tsshendo/2-Phase-interleaved-buck-converter/kicad/tools/README.md

# kicad/tools

Scripts used to build and check the Stage 2 schematic. Run them with KiCad's bundled Python
(`C:\Program Files\KiCad\10.0\bin\python.exe` on Windows).

| Script | What it does |
|---|---|
| `gen_symbols.py` | Writes the project symbol library `ECE533_Guide/ECE533.kicad_sym`: custom IC symbols drawn from the manufacturer datasheets (LTC3861, Si8274, AMC3301, INA301, LM5012, TPS2553, TLV3012, VOM1271, 74LVC1G74, SI86S620, NME1S0505SC, EPC2304, ERUC23) and the named power symbols (PGND, GND_ISO, +5V_PWR, +5V_ISO, VBUS, +24V). |
| `gen_schematic.py` | Generated the initial hierarchical sheets (root, input protection, power stage, 2 × power phase, aux supply/fan, isolation, controller, fault logic/rack I/O). |
| `check_netlist.py` | Connectivity checks on an exported netlist (74 checks: every signal path through the hierarchy, Kelvin returns, the two ground domains kept apart). |
| `gen_footprints.py` | Writes `ECE533_Mods.pretty` (EPC2304, TDK ERUC23, Kelvin 2512 shunt, Littelfuse 456 fuse, drawn from the datasheets), the fuse placeholder STEP, and the git-ignored `lib/vendor/ECE533_Vendor.pretty` (Würth REDCUBE, Murata NME1S). See `lib/vendor/README.md`. |
| `build_pcb.py` | Stage 3 first pass: builds `ECE533_Guide.kicad_pcb` from the netlist (footprints, nets, schematic links, outline, stack-up, net classes, heatsink/barrier drawings) and places all parts (fixed floor plan + nearest-free-spot placement). Re-running overwrites the board, so after Stage 3 edit in KiCad. |
| `check_footprints.py` | Checks every symbol pin against the pads of its footprint (and flags unused pads). |
| `make_bom.py` | Builds `bom/PCB_BOM.xlsx` and `bom/PCB_BOM.csv` from an exported netlist. |
| `route_power.py`, `route_signals.py` | Stage 4 power copper and Freerouting round trip for the main board; their `Router` and DSN helpers are reused by `pm_route.py`. |
| `pm_assign.py`, `pm_flags.py` | PowerModule: footprints, catalog values and MPN/LCSC fields on the base schematic; PWR_FLAGs on the driver supply nets. |
| `pm_build.py` | PowerModule: builds `PowerModule.kicad_pcb` from the netlist and places all 54 parts in the report's layout. |
| `pm_route.py` | PowerModule: report polygon pours (`power`), Freerouting for the signals (`signals`), ground fills and stitching (`finish`). See `docs/design/power_module.md` §8. |
| `pm_bom.py` | PowerModule: `bom/PowerModule_BOM.csv` from the netlist. |
| `kisch.py`, `kilib.py`, `sexp.py`, `parts.py` | Helpers: schematic writer, symbol builder, S-expression reader, part catalogue (footprints, MPNs). |

**After Stage 2, edit the schematic in KiCad.** Re-running `gen_schematic.py` overwrites the
sheets, so it is a record of how they were built, not the master copy. `check_netlist.py` stays
useful after manual edits:

```
kicad-cli sch export netlist -o build.net kicad/ECE533_Guide/ECE533_Guide.kicad_sch
python kicad/tools/check_netlist.py build.net
```
