tsshendo/2-Phase-interleaved-buck-converter/docs/datasheets/README.md

# Datasheets and references

Vendor datasheets aren't committed (copyright). Download them locally into this folder;
`*.pdf` here is fine to keep locally, but please don't commit it.

| Part | Role | Link |
|---|---|---|
| EPC2304 | 200 V eGaN FET (Q3–Q6) | https://www.digikey.com/en/products/result?keywords=EPC2304 |
| TDK ERUC23-3R2K | Coupled inductor (L1) | https://www.digikey.com/en/products/result?keywords=ERUC23-3R2K |
| Infineon 1EDN7550UXTSA1 | Gate driver (U1–U4) | https://www.digikey.com/en/products/result?keywords=1EDN7550UXTSA1 |
| MCC SS110HL-TP | Bootstrap Schottky (D1–D4) | https://www.digikey.com/en/products/result?keywords=SS110HL-TP |
| Skyworks SI86S620BC-IS | Digital isolator (likely removed) | https://www.digikey.com/en/products/result?keywords=SI86S620BC-IS |
| Murata NME1S0505SC | Isolated 5 V module (likely removed) | https://www.digikey.com/en/products/result?keywords=NME1S0505SC |
| Molex 105313-1206 | Signal header (J4) | https://www.digikey.com/en/products/result?keywords=1053131206 |
| Chemi-Con EGXF161ELL111MK25S | Bulk capacitor (C5/C6) | https://www.digikey.com/en/products/result?keywords=EGXF161ELL111MK25S |
| Alpha Novatech Z60-12.7B | Heatsink | https://www.alphanovatech.com/en/c_z60e.html |
| Sanyo Denki 9GA0405P6H001 | 5 V cooling fan | https://products.sanyodenki.com/en/sanace/dc/dc-fan/9GA0405P6H001/ |
| TI UCC27611 | Reference: alternative GaN driver | https://www.ti.com/product/UCC27611 |
| onsemi FAN3122 app note | Reference: gate-drive design | https://www.digikey.com/en/products/result?keywords=FAN3122 |
| TI TIDA-050089 | Reference design the topology follows | https://www.ti.com/tool/TIDA-050089 |
