tsshendo/2-Phase-interleaved-buck-converter/docs/design/power_module.md

# Power module board (`kicad/PowerModule`)

A separate KiCad project that holds **only the power stage** of the ECE 533 report design, driven
through a control connector. It is the report's module, laid out on the credit-card board. The main
board (`kicad/ECE533_Guide`, Stages 1–5) is a different project and is not affected.

| | |
|---|---|
| Schematic | Base files from the report (commit `57d8ca5`): `PowerModule.kicad_sch` (power stage) + `gate_drive.kicad_sch`. The circuit is unchanged (see §2) |
| Board | 85.60 × 53.98 mm ID-1 (R3.18), 4 × 2 oz, 1.6 mm, ENIG, JLCPCB 4-layer |
| Parts | 60, the same parts as the report (bulk caps split, 1 kΩ gate pull-downs added, §2): 4 × EPC2304, ERUC23-3R2K, 4 × 1EDN7550B, 2 × SI86S620BC, NME1S0505SC, REDCUBE terminals |
| Checks | ERC: 0 errors, 6 warnings (off-grid wire ends in the base drawing). DRC with schematic parity: **0 violations, 0 unconnected, 0 parity issues** |
| Scripts | `kicad/tools/pm_assign.py`, `pm_flags.py`, `pm_build.py`, `pm_route.py`, `pm_bom.py` (see §8) |

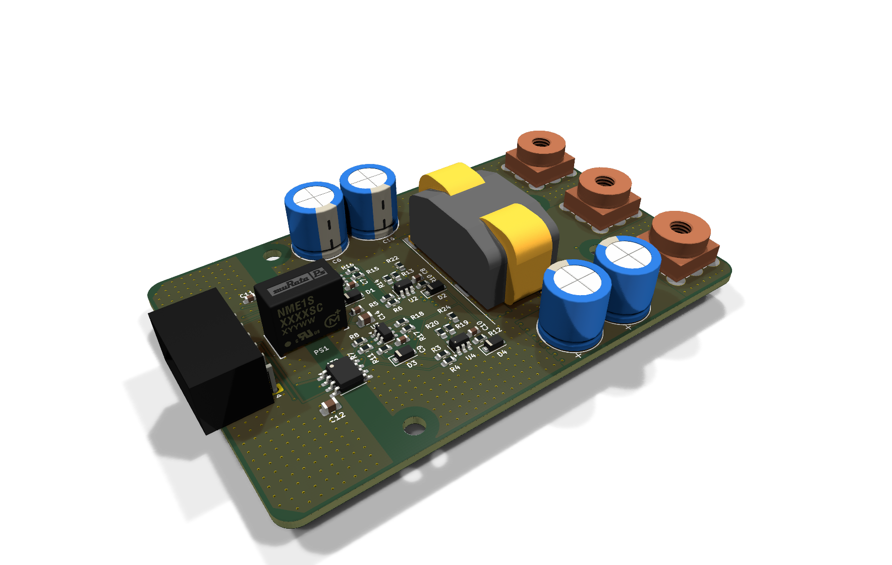
[picture p1: docs/design/img/pm_3d_iso.png]
top


## 1. What the module does
- 72 V in (J1 DC+, J3 DC−), 24 V / 46 A out (J2, return through J3), two phases 180° apart and one
  coupled inductor. No controller on board.
- **J4 (Molex Nano-Fit 105313-1206, right angle)**, centred on the left edge between the isolators,
  mating face 2.2 mm off the board edge (project footprint `ECE533_Mods:Molex_Nano-Fit_105313-1206_RA`
  with a right-angle model drawn from the footprint outline and the Molex drawing; KiCad's library has
  no Nano-Fit model). PS1 sits on J4's centreline. J4 brings in
  the four gate commands and their 5 V supply. The AT1 pair runs on L4 and the AT2 pair on L1 in
  fixed lanes (each pair swaps order at the isolator, so one signal per pair changes layer once):
  15–19 mm per line:

| J4 pin | Net | Function |
|---|---|---|
| 1 | +5V | 5 V for the isolator inputs and PS1 (the module draws < 0.1 W, PS1 is rated 1 W) |
| 2 | AT1 A1 | Phase 1 low side (Q4 on when high) |
| 3 | AT1 A2 | Phase 1 high side (Q3 on when high) |
| 4 | AT2 A1 | Phase 2 low side (Q5 on when high) |
| 5 | AT2 A2 | Phase 2 high side (Q6 on when high) |
| 6 | GND | Control ground (isolated from the power ground) |

  Each isolator output pair feeds the two drivers of a phase crosswise (B1 → U1 IN−/U2 IN+, B2 →
  U1 IN+/U2 IN−), so **both inputs high or both low turns both FETs off**. Dead time is set by the
  external controller.
- Isolation: AT1/AT2 (SI86S620BC) carry the commands, PS1 (NME1S0505SC) makes the isolated
  +5V_iso / GNDPWR supply for the driver side. The barrier band is x = 16.3–19.7 mm on every layer,
  with a 2.5 mm DRC rule between the J4-side nets and the rest.

## 2. Schematic changes (minimal)
The base schematic is used as given. The only additions are:
1. **Footprints, catalog values and part numbers** (`pm_assign.py`). Every passive is 0603 or
   larger, and the values follow the BOM:
   - C1–C4: 2.2 µF (base: 2.5 µF);
   - bulk: each bulk position is **two parallel EGXF 62 µF / 160 V** (EGXF161ELL620MJ25S, 10 × 25 mm):
     C5 + C15 on the output, C6 + C16 on the input (user request: half values for lower ESR; the GXF
     160 V series has no 55 µF part, so 2 × 62 µF = 124 µF per position, ≥ the former 110 µF).
     C15/C16 are joined with `VOUT` / `VIN` labels (`pm_split_bulk.py`). Base schematic: C6 440 µF;
   - R13/R14/R19/R20: 5.6 Ω (base: 6 Ω).
2. **`SHIELD` label** joining the two centre taps (C1/C2 and C3/C4). This is the interstitial-shield
   return terminal described in the report (p. 18).
3. **PWR_FLAGs** on the driver supply nets, which come in through J4, PS1 and the bootstrap parts.
4. **Gate pull-downs R21–R24** (1 kΩ, 0603, gate to Kelvin source: P1H–KS1, P1L–GNDPWR,
   P2H–KS2, P2L–GNDPWR), as in the report's LTspice model (`pm_pulldowns.py`).
5. `connectors.kicad_sch` was dropped: it was in the base folder but not in the hierarchy.

EPC2304 uses the base SamacSys 15-pin symbol. The new footprint `EPC2304_QFN-7_3x5mm_15pin` has the
EPC copper, mask and stencil drawing, with pins 8–15 stacked on the matching physical pad: G → 1/12,
SK → 2/15, D → 3/8, 5/9, 7/10/11, S → 4/13, 6/14.

## 3. Stack-up and layer use (two planes, as in the report)
| Layer | Report equivalent | Use |
|---|---|---|
| L1 (top, 70 µm) | 1st Cu plane | Inductor, drivers, isolators, PS1, bulk caps, terminals. VOUT plane (inductor → J2, C5), VBUS strip (C6, J1), switch-node pads, gate traces, PGND fill on the power side, GND fill on the J4 side |
| L2 (70 µm) | Interstitial shield | Continuous `SHIELD` plane on the power side, with antipads at every feedthrough. No traces |
| L3 (70 µm) | Interstitial shield | Second copy of the shield, 0.1 mm above the FET plane (closest to the dv/dt source). No traces |
| L4 (bottom, 70 µm) | 2nd Cu plane (MOSFET side) | EPC2304s and input ceramics; patterned VBUS / SW / PGND combs, centre-tap island, Kelvin islands, PGND return to J3 |

The report's alumina stack (70 µm / shield / 70 µm) becomes FR-4 3313 prepreg (0.1 mm) on each side
of a 1.1 mm core. L2 and L3 are set as plane layers, so the router never puts traces on them.
**Deviation:** the user's answer allowed L3 to be "empty (or ground)". I used it as a second shield
layer, because it sits right next to the switch nodes. If you want L3 empty, delete its zone.

## 4. Layout, following the report (pp. 20–25)
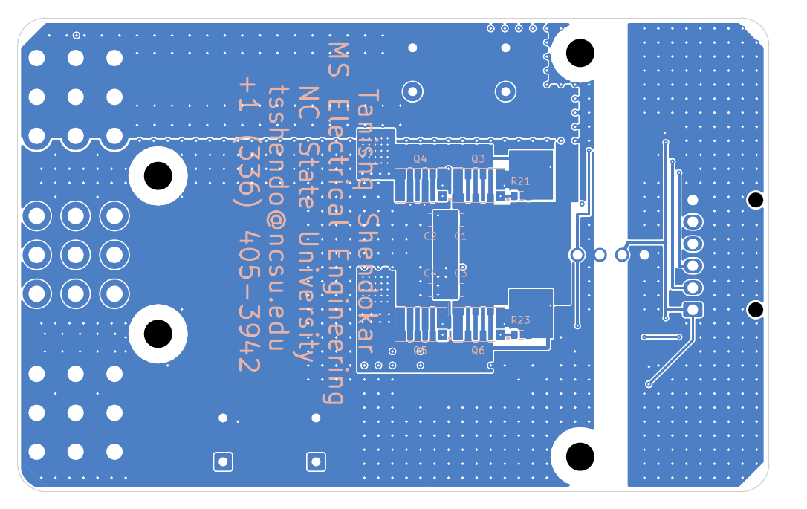
[picture p2: docs/design/img/pm_L4.png]
L4

*L4 from below (mirrored): the two half-bridges, combs and centre-tap island.*

- **Order, left to right** (report figures "Gate Isolator…" and "Gate and power terminals"): J4 on
  the side, AT1/AT2 with PS1 between them, a column of four gate drivers, the 2 × 2 FET block, the
  coupled inductor, then the bulk capacitors and the terminals. The report brings its power wires
  out of the top. Here they land on REDCUBE M4 terminals on the right edge: DC+ top, VOUT middle,
  DC− bottom.
- **FET block** (bottom, at x 33.0 / 39.6 and y 19.1 / 34.9). Each phase is one row: HS left, LS
  right, strips vertical, gate pads toward the drivers. The rows sit exactly under the inductor's
  switch-node pads (pad pitch 15.8 mm), so the phases are copies of each other.
- **Patterned 2nd plane (L4), per phase:**
  - Switch-node comb along the outer ends of the strips (HS sources + LS drains), straight under the
    inductor pad, with 25 filled vias in the pad and 8 more in the band (0.06 mΩ, < 3 % of RDS(on)).
  - VBUS comb (HS drains) and PGND comb (LS sources) along the inner ends.
  - C1 + C2 (C3 + C4) in series bridge VBUS → SHIELD → PGND right at the FETs, so the commutation
    loop is cap → HS → switch node → LS → cap. That loop is about 6.6 × 5 mm, flat, 0.1 mm above the
    L3 shield.
  - The centre taps of both phases form one `SHIELD` island between the rows, stitched to L2/L3.
    That is the shield's single return terminal (report p. 18).
- **Gate drive:**
  - The HS drivers are on the top, in the report's column left of the FETs, level with their FET
    row. The **LS drivers sit on the top between the two phases**, right at the LS gate pads, with
    their outputs facing the gate vias and the gate resistors running straight to them.
  - Gate pads and the LS Kelvin pads go up through filled via-in-pad.
  - Each HS driver sits over a **Kelvin island** on L4. The island connects to the HS SK pad and joins
    the switch node only once, at a tie next to the FET. It is the driver's reference and the return
    under its gate trace.
  - Driver output → gate resistor → gate pad, total: **LS 4.8 mm, HS 5.9–6.8 mm** (the first layout
    had LS 11–14 mm).
- **Input path:** J1 → VBUS strip (L1 + L4 along the top edge, C6 on a PGND tongue) → VBUS column
  down the left of the FET block → the HS combs. **Output path:** inductor pads → L1 VOUT plane → J2,
  and the VOUT plane down to the output capacitors on the bottom edge. **Return:** L4 PGND under the inductor → J3.
- **Symmetry about the board centreline:** the FET rows (y 19.1 / 34.9), the inductor body (centred;
  its SW pads, off-centre in the TDK footprint, sit 3.95 mm above each FET row and the L4 switch-node
  copper extends under them), J4, PS1, AT1/AT2, C11/C12, the screws and the terminals are mirrored.
  The **per-phase gate-drive cells are identical copies one phase pitch (15.8 mm) apart**, like the FET
  rows: the EPC2304 gate pad is at the same corner in both rows (a bottom-side part cannot be
  mirrored), so mirrored cells would give the two phases different gate loops. As copies, both phases
  have the same driver→gate paths (HS 8.3 mm, LS 5.9 mm including the pull-down stubs).
- **Bulk capacitors grouped by role:** input C6 + C16 together on the top edge, on the **input side**
  of the inductor, over the VBUS feed to the HS drains: they supply the pulsed input current next to
  the ceramics and keep the input ripple off the output side; their '−' pins reach the L4 PGND comb
  through an L1 tongue and vias next to LS1. Output C5 + C15 together on the bottom edge, on the
  **output side**, under the inductor's VOUT pads and next to J2, on the VOUT plane.

| L1 (1st Cu plane) | L2 (shield) |
|---|---|
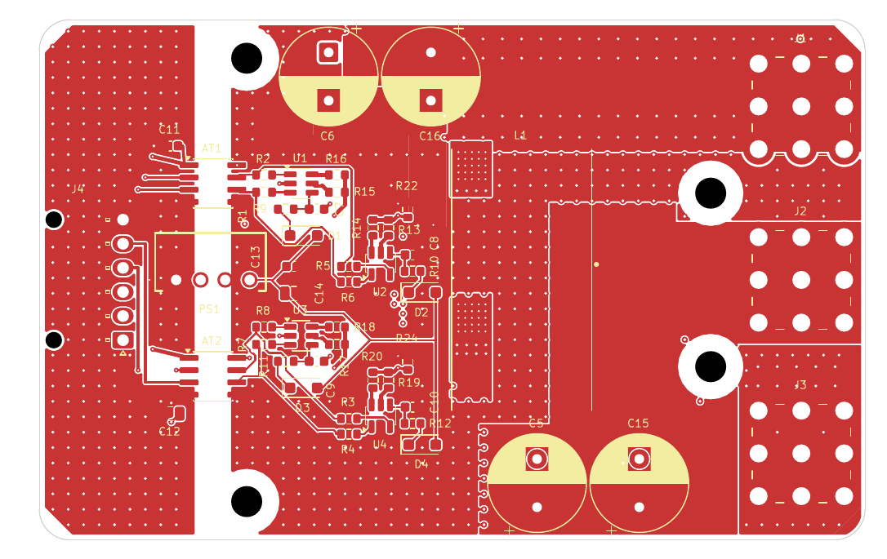
[picture p3: docs/design/img/pm_L1.png]
L1
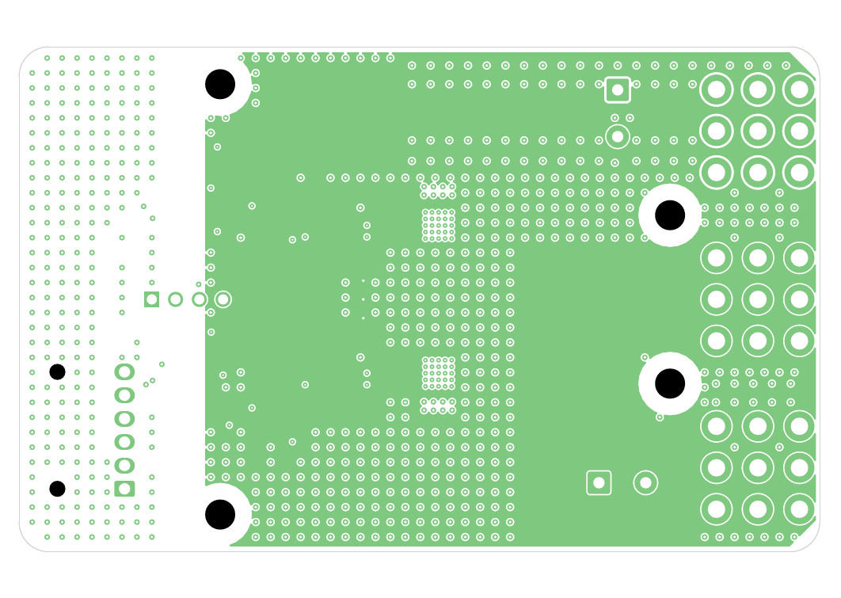
[picture p4: docs/design/img/pm_L2.png]
L2
|  |  |

- **Silkscreen:** every reference designator is on the silkscreen (0.8 mm, on the part's side).
  The bottom carries the owner block (name, degree, university, e-mail, phone) at 2.3 mm, between
  the FET block and the terminals. Note that the heatsink covers it once mounted.

## 5. Mechanics and thermal
- Z60-12.7B on the bottom at x 19–79 mm: flush with neither edge, 3 mm overhang top and bottom.
  There is a 3.0 mm pedestal over the FET block and an insulating TIM (HS and LS share the
  heatsink), drawn on Dwgs.User / B.Fab.
- **4 × M3 holes** (NPTH, 3.4 mm copper keep-out): (21.5, 4.0), (21.5, 50.0), (69.6, 18.0),
  (69.6, 36.0) mm. Screw heads stay clear of the top parts.
- Only the FETs and C1–C4 are on the bottom. THT leads under the heatsink (C5, C6, PS1 pins 3–4,
  J1–J3) must be trimmed to ≤ 2.5 mm (pedestal 3.0 mm).
- FET losses, junction temperature and fan: unchanged from `thermal.md`.

## 6. Current and copper
| Path | Copper | Estimate |
|---|---|---|
| Switch node → inductor, per phase | L4 band + 33 vias + L1 pad | 0.06 mΩ (vias), 23 A |
| VOUT, inductor → J2 | L1 plane ≥ 12.6 mm wide, about 25 mm long | ≈ 0.45 mΩ → 0.9 W at 46 A (one layer) |
| PGND return → J3 | L4 plane ≥ 10 mm wide + L1 fill | ≈ 0.4 mΩ |
| VBUS column (narrowest part) | L4, 2.6 mm × 7.3 mm beside the HS1 Kelvin island | 0.69 mΩ → 0.22 W at 17.9 A |
These are DC estimates (ρ = 1.72 × 10⁻⁸ Ω·m, 70 µm). Stage 1 asked for ≥ 20 mm of VOUT copper on
two layers. This module has one VOUT layer (the report's two-plane scheme puts PGND under it), so it
runs warmer than the main board. See §7.

## 6a. Parasitics vs the report (hand estimates, ±50 %)
Report values: Q3D tables and the LTspice models in `sim/ltspice/`. Layout values: copper measured on
this board; strip-over-shield L ≈ μ0·h·ℓ/w (h = 0.17 mm to the L2/L3 shield), microstrip 0.33 nH/mm,
via pair 0.4·h·ln(s/r) nH, ρℓ/A, FR-4 3313 0.0994 mm (0.365 pF/mm²; alumina 70 µm was 1.265 pF/mm²).

| Quantity | Report | This layout | Note |
|---|---|---|---|
| Commutation loop | 10.8 nH (Q3D) | ≈ 2.6 nH (2.1–3.4): planar 1.4 + 2 × 0805 in series 0.9 + FETs 0.3 | Lateral loop 6.6 × 6 mm over the shield |
| LS V_DS overshoot | ≈ 88 V (160 V peak) | ≈ 17–28 V (scaled) → ≈ 95–105 V peak | Target < 100 V: borderline-OK, confirm by extraction |
| HS gate loop | 4.93 nH, 12.6 mΩ | ≈ 4 nH, ≈ 9 mΩ (copper) | Kelvin island return under the trace |
| LS gate loop | 9.79 nH, 22.7 mΩ | ≈ 3 nH, ≈ 7 mΩ | LS drivers moved next to the LS FETs |
| Freewheel interconnect | target 0.15 mΩ (3 % RDS(on)); SPICE 0.25 + 0.1 mΩ | ≈ 0.4 mΩ (vias 0.06, SW band 0.25–0.3, return 0.1) | Over the 0.15 mΩ target, ≈ the SPICE value; an L1 copper layer over the SW band would roughly halve it (more SW area) |
| SW node → shield | 71.5 pF | ≈ 45 pF (phase 1), ≈ 64 pF (phase 2) | Includes the Kelvin island and the L1 pad; SW2 reaches 7 mm up to the centred inductor's pad |
| Shield return (tap → IL) | 1.02 nH, 0.94 mΩ | ≈ 0.3 nH, 0.24 mΩ (6 vias) | |
| IL → ground (heatsink) | 141 pF | not comparable | Here L4 copper screens the shield from the heatsink; the heatsink touches the FETs through the TIM |
| HF decoupling | 2.5 µF per leg (SPICE) | 1.1 µF per phase (2 × 2.2 µF in series, base schematic) | |
| Bulk | 440 µF in / 100 µF out (SPICE) | 124 µF in / 124 µF out | |
| Gate resistors | 2 Ω / 6 Ω, 1 kΩ pull-downs | 2 Ω / 5.6 Ω, 1 kΩ pull-downs R21–R24 (added) | HS pull-downs on the bottom in the Kelvin island, LS on the top over the gate via |

## 7. Open issues and deviations
1. **VOUT on one layer, VBUS neck 2.6 mm:** expect roughly 20–30 °C of copper rise at 46 A with no
   airflow. Options: thicker copper, or VOUT on L4 as well with PGND moved to L1.
2. **Commutation-loop inductance:** not extracted. A flat lateral loop of about 33 mm², 0.1 mm over
   the shield, should be a few nH, against the report's 10.8 nH. Confirm with Q3D/FastHenry before
   building. The series centre-tapped caps (base schematic) give only 1.1 µF per phase. Consider
   additional ceramics if overshoot is high.
3. **1EDN7550B high side:** Stage 1 judged its static common-mode range marginal at a 79 V high side.
   This is why the main board moved to the Si8274. Kept here because the module reproduces the report.
4. **PS1 SIP-4 pitch** across the barrier: same issue as the main board. PS1 sits on J4's centreline. The barrier keep-out at PS1 runs from pin-2 centre to pin-3 centre, so
   copper reaches each pin only from its own side; a DRC exception allows 0.9 mm between the pins and
   1.5 mm for copper entering PS1 (≈ 1.4 mm needed for functional isolation at ≤ 80 V, PD2).
5. Gate pull-downs R21–R24 (1 kΩ, gate to Kelvin source) were added to the base schematic (`pm_pulldowns.py`).
6. The LS Kelvin return runs on L1 and joins PGND through the fill.
7. Stock: the Digi-Key numbers come from the main BOM where the part is shared. The 1EDN7550BXTSA1
   Digi-Key PN and its stock still need to be confirmed, as do those of EGXF161ELL620MJ25S.
8. J4's 3D model is a dimensioned placeholder (boxes); swap in Molex's STEP if a full mechanical model is needed.

## 8. Regenerating
Run each command with KiCad's Python (`C:\Program Files\KiCad\10.0\bin\python.exe`) from `kicad/tools`.
```
python pm_assign.py ; python pm_flags.py ; python pm_split_bulk.py ; python pm_pulldowns.py   # once (applied)
kicad-cli sch export netlist -o pm.net ../PowerModule/PowerModule.kicad_sch
python pm_build.py pm.net                            # board, outline, stack-up, placement
python pm_route.py power                             # report pours, vias, Kelvin islands, hops
python pm_route.py signals <freerouting.exe> <dir>   # Freerouting v2.4.1 for the signals
python pm_route.py finish                            # ground fills, stitching
python pm_bom.py pm.net ../../bom/PowerModule_BOM.csv
```
Freerouting is not deterministic. After a rerun, check DRC again; the committed board is the
checked one.
