tsshendo/2-Phase-interleaved-buck-converter/docs/design/img/pm_3d_bottom.png

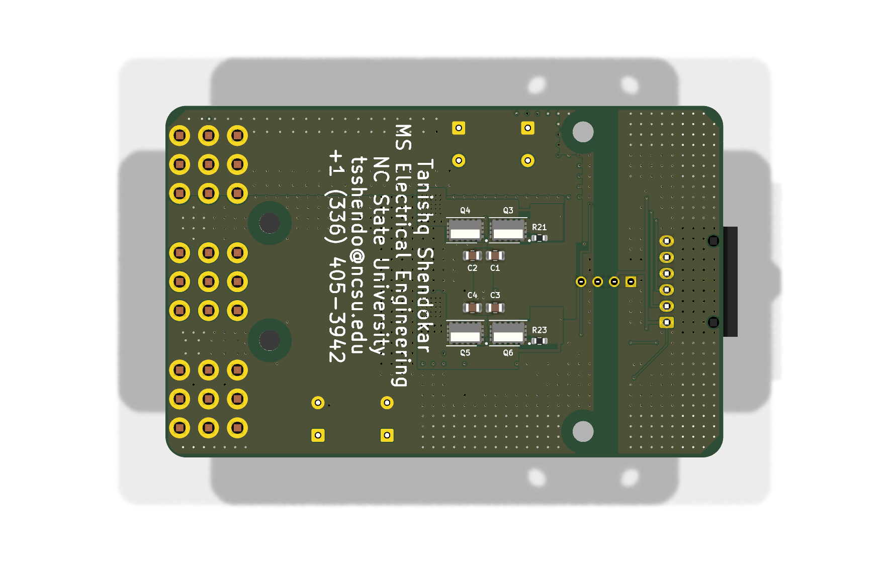
docs/design/img/pm_3d_bottom.png
