tsshendo/2-Phase-interleaved-buck-converter/docs/design/img/pm_3d_top.png

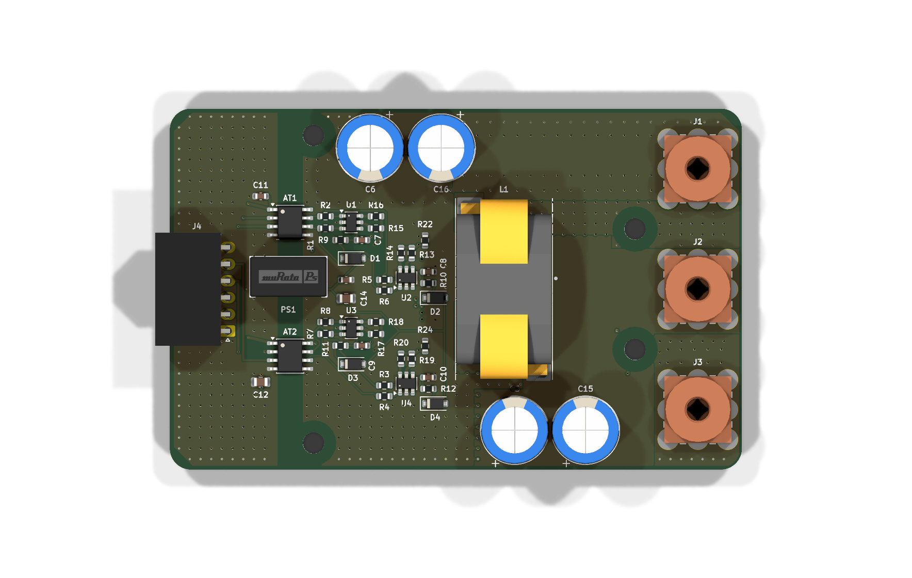
docs/design/img/pm_3d_top.png
