tsshendo/2-Phase-interleaved-buck-converter/docs/design/img/pm_all.png

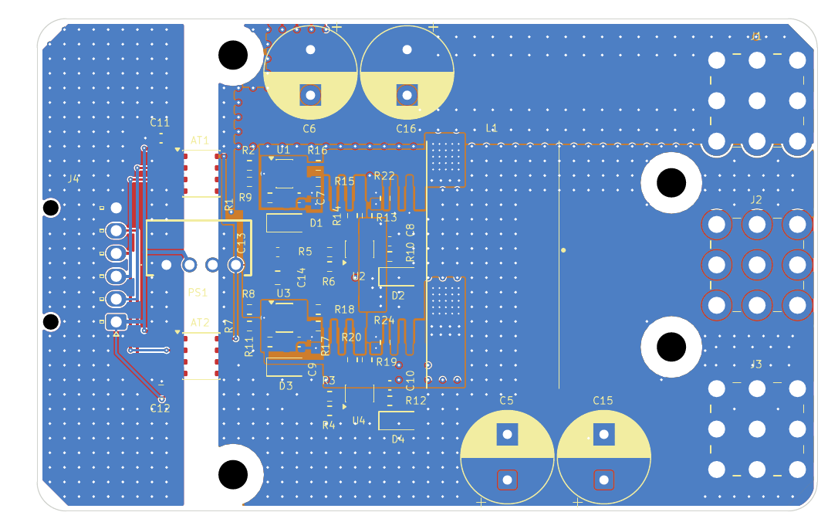
docs/design/img/pm_all.png
