tsshendo/2-Phase-interleaved-buck-converter/docs/design/img/stage3_footprints_3d.png

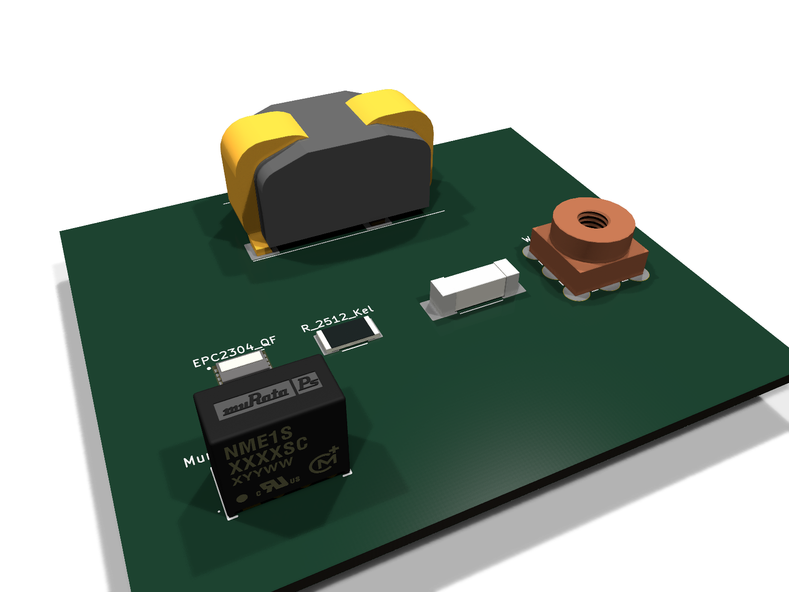
docs/design/img/stage3_footprints_3d.png
