tsshendo/2-Phase-interleaved-buck-converter/bom/PowerModule_BOM.csv

Item | Qty | Reference designators | Value | Manufacturer part number | Manufacturer | Digi-Key PN | LCSC PN | Footprint | Side | Notes
1 | 2 | AT1,AT2 | SI86S620BC-IS | SI86S620BC-IS | Skyworks | 863-SI86S620BC-IS-ND | C7363570 | SOIC-8_3.9x4.9mm_P1.27mm | Top | Report part (base schematic)
2 | 4 | C1,C2,C3,C4 | 2.2u/100V | GRM21BD72A225KE01L | Murata | 490-GRM21BD72A225KE01LCT-ND | C2981733 | C_0805_2012Metric | Bottom | Report part (base schematic)
3 | 4 | C5,C6,C15,C16 | 62u/160V | EGXF161ELL620MJ25S | Chemi-Con |  |  | CP_Radial_D10.0mm_P5.00mm | Top | Bulk split into 2 x half value per position (GXF 160 V, 10 x 25 mm); Digi-Key PN and stock to confirm
4 | 6 | C7,C8,C9,C10,C11,C13 | 100n/50V | GRM188R71H104KA93D | Murata |  | C77055 | C_0603_1608Metric | Top | Same part as the main board BOM
5 | 2 | C12,C14 | 10u/10V | GRM21BR71A106KE51L | Murata |  | C86038 | C_0805_2012Metric | Top | Same part as the main board BOM
6 | 4 | D1,D2,D3,D4 | SS110HL | SS110HL-TP | MCC | 353-SS110HL-TPCT-ND | C19996385 | D_SOD-123F | Top | Report part (base schematic)
7 | 1 | J1 | DC+ | 74650194R | Wurth Elektronik |  |  | Wurth_REDCUBE_74650194 | Top | Same part as the main board BOM
8 | 1 | J2 | Power_out | 74650194R | Wurth Elektronik |  |  | Wurth_REDCUBE_74650194 | Top | Same part as the main board BOM
9 | 1 | J3 | DC- | 74650194R | Wurth Elektronik |  |  | Wurth_REDCUBE_74650194 | Top | Same part as the main board BOM
10 | 1 | J4 | 105313-1206 | 105313-1206 | Molex | WM14975-ND | C17656275 | Molex_Nano-Fit_105313-1206_RA | Top | Report part (base schematic)
11 | 1 | L1 | ERUC23-3R2K | ERUC23-3R2K | TDK | 495-ERUC23-3R2KCT-ND |  | TDK_ERUC23 | Top | Report part (base schematic)
12 | 1 | PS1 | NME1S0505SC | NME1S0505SC | Murata | 811-NME1S0505SC-ND | C39128444 | Murata_NME1S_SIP-4 | Top | Report part (base schematic)
13 | 4 | Q3,Q4,Q5,Q6 | EPC2304 | EPC2304 | EPC | 917-EPC2304CT-ND | C6549215 | EPC2304_QFN-7_3x5mm_15pin | Bottom | Report part (base schematic)
14 | 8 | R1,R2,R3,R4,R5,R6,R7,R8 | 51k | RC0603FR-0751KL | YAGEO |  |  | R_0603_1608Metric | Top | Same part as the main board BOM
15 | 4 | R9,R10,R11,R12 | 4.7 | RC0603FR-074R7L | YAGEO |  |  | R_0603_1608Metric | Top | Same part as the main board BOM
16 | 4 | R13,R14,R19,R20 | 5.6 | RC0603FR-075R6L | YAGEO |  |  | R_0603_1608Metric | Top | Same part as the main board BOM
17 | 4 | R15,R16,R17,R18 | 2 | RC0603FR-072RL | YAGEO |  |  | R_0603_1608Metric | Top | Same part as the main board BOM
18 | 4 | R21,R22,R23,R24 | 1k | RC0603FR-071KL | YAGEO |  |  | R_0603_1608Metric | Top + Bottom | Gate pull-downs (report LTspice model): R21/R23 bottom, R22/R24 top
19 | 4 | U1,U2,U3,U4 | 1EDN7550B | 1EDN7550BXTSA1 | Infineon |  |  | SOT-23-6 | Top | Report driver (base schematic); Digi-Key PN and stock to confirm
20 | 1 | (mechanical) | Z60-12.7B heatsink | Z60-12.7B | Alpha Novatech |  |  | 4 x M3 holes H1-H4 | Bottom | Pedestal 3.0 mm over the FET block, insulating TIM
