tsshendo/2-Phase-interleaved-buck-converter/bom/PCB_BOM.csv

Item | Qty | Reference designators | Value | Manufacturer part number | Manufacturer | Digi-Key PN | Unit price (USD) | Ext. price (USD) | LCSC PN | Footprint | DNP | Notes
1 | 2 | AT1,AT2 | SI86S620BC-IS | SI86S620BC-IS | Skyworks | 863-SI86S620BC-IS-ND | 3.28 |  | C7363570 | SOIC-8_3.9x4.9mm_P1.27mm |  | Required part (CLAUDE.md section 4)
2 | 10 | C1,C2,C3,C4,C15,C16,C17,C18,C74,C75 | 2.2u/100V | GRM21BD72A225KE01L | Murata | 490-GRM21BD72A225KE01LCT-ND | 0.44 |  | C2981733 | C_0805_2012Metric |  | Required part (CLAUDE.md section 4)
3 | 2 | C5,C6 | 110u/160V | EGXF161ELL111MK25S | Chemi-Con | 565-EGXF161ELL111MK25S-ND | 2.07 |  | C1598290 | CP_Radial_D12.5mm_P5.00mm |  | Required part (CLAUDE.md section 4)
4 | 39 | C7,C8,C9,C10,C11,C13,C30,C31,C40,C41,C45,C47,C49,C50,C54,C56,C58,C59,C68,C73,C80,C87,C88,C89,C90,C91,C94,C96,C98,C100,C102,C103,C111,C112,C113,C114,C116,C117,C119 | 100n/50V | GRM188R71H104KA93D | Murata |  |  |  | C77055 | C_0603_1608Metric
5 | 4 | C12,C14,C84,C86 | 10u/10V | GRM21BR71A106KE51L | Murata |  |  |  | C86038 | C_0805_2012Metric
6 | 4 | C32,C33,C34,C35 | 10n/100V | GRM188R72A103KA01D | Murata |  |  |  | C162275 | C_0603_1608Metric
7 | 4 | C42,C51,C105,C106 | 1n/50V | GRM1885C1H102JA01D | Murata |  |  |  | C77026 | C_0603_1608Metric
8 | 16 | C43,C44,C46,C48,C52,C53,C55,C57,C83,C85,C93,C95,C97,C99,C101,C115 | 1u/25V | GRM188R71E105KA12D | Murata |  |  |  | C86020 | C_0603_1608Metric
9 | 6 | C60,C61,C62,C63,C64,C65 | 10u/50V | GRM32ER71H106KA12L | Murata |  |  |  | C77102 | C_1210_3225Metric
10 | 2 | C66,C67 | 100u/35V | EEH-ZA1V101P | Panasonic |  |  |  |  | CP_Elec_8x10.5
11 | 2 | C70,C71 | 1u/100V | CC0805KKX7R0BB105 | YAGEO |  |  |  | C5370002 | C_0805_2012Metric
12 | 1 | C72 | 470n/25V | GRM188R71E474KA12D | Murata |  |  |  | C77052 | C_0603_1608Metric
13 | 1 | C76 | 100n/100V | GRM188R72A104KA35D | Murata |  |  |  | C77058 | C_0603_1608Metric
14 | 2 | C77,C107 | 2.2n/50V | GRM188R71H222KA01D | Murata |  |  |  | C86023 | C_0603_1608Metric
15 | 2 | C78,C79 | 22u/10V | GRM31CR71A226KE15L | Murata |  |  |  | C91604 | C_1206_3216Metric
16 | 2 | C81,C108 | 4.7n/50V | GRM188R71H472KA01D | Murata |  |  |  | C77057 | C_0603_1608Metric
17 | 1 | C82 | 47n/50V | GRM188R71H473KA61D | Murata |  |  |  | C86027 | C_0603_1608Metric
18 | 3 | C92,C104,C109 | 100p/50V | GRM1885C1H101JA01D | Murata |  |  |  | C71664 | C_0603_1608Metric
19 | 1 | C118 | 10n/50V | GRM188R71H103KA01D | Murata |  |  |  | C77053 | C_0603_1608Metric
20 | 2 | D1,D2 | SS110HL | SS110HL-TP | MCC | 353-SS110HL-TPCT-ND | 0.36 |  | C19996385 | D_SOD-123F |  | Required part (CLAUDE.md section 4)
21 | 2 | D3,D4 | 5.1V | BZT52C5V1-TP | MCC |  |  |  | C78728 | D_SOD-123
22 | 1 | D5 | 30BQ100 | VS-30BQ100TRPBF | Vishay |  |  |  |  | D_SMC
23 | 1 | D6 | SMDJ85CA | SMDJ85CA | Littelfuse |  |  |  | C1978008 | D_SMC
24 | 2 | D7,D14 | TPD4E05U06 | TPD4E05U06DQAR | TI |  |  |  | C138714 | USON-10_2.5x1.0mm_P0.5mm
25 | 1 | D8 | GREEN PGOOD | LTST-C191KGKT | Lite-On |  |  |  | C125098 | LED_0603_1608Metric
26 | 1 | D9 | RED FAULT | LTST-C191KRKT | Lite-On |  |  |  | C125099 | LED_0603_1608Metric
27 | 2 | D15,D16 | BAT54W | BAT54W-7-F | Diodes Inc |  |  |  | C134417 | SOT-323_SC-70
28 | 1 | FB1 | 600R@100MHz | BLM18KG601SN1D | Murata |  |  |  | C85833 | L_0603_1608Metric
29 | 1 | J1 | DC+ 72V | 74650194R | Wurth Elektronik |  |  |  |  | Wurth_REDCUBE_74650194
30 | 1 | J2 | VOUT+ | 74650194R | Wurth Elektronik |  |  |  |  | Wurth_REDCUBE_74650194
31 | 1 | J3 | DC- return | 74650194R | Wurth Elektronik |  |  |  |  | Wurth_REDCUBE_74650194
32 | 1 | J4 | RACK I/O Nano-Fit | 105313-1206 | Molex | WM14975-ND | 2.54 |  | C17656275 | Molex_Nano-Fit_105313-xx06_1x06_P2.50mm_Horizontal |  | Required part (CLAUDE.md section 4)
33 | 1 | J5 | FAN Micro-Fit | 43650-0400 | Molex |  |  |  | C277684 | Molex_Micro-Fit_3.0_43650-0400_1x04_P3.00mm_Horizontal
34 | 1 | J6 | VOUT- | 74650194R | Wurth Elektronik |  |  |  |  | Wurth_REDCUBE_74650194
35 | 1 | L1 | ERUC23-3R2K | ERUC23-3R2K | TDK | 495-ERUC23-3R2KCT-ND | 8.96 |  |  | TDK_ERUC23 |  | Required part (CLAUDE.md section 4); Custom footprint, drawn in Stage 3
36 | 1 | L2 | 33uH | XAL7070-333MEB | Coilcraft |  |  |  |  | L_Coilcraft_XAL7070-XXX
37 | 1 | PS1 | NME1S0505SC | NME1S0505SC | Murata | 811-NME1S0505SC-ND | 1.86 |  | C39128444 | Murata_NME1S_SIP-4 |  | Required part (CLAUDE.md section 4)
38 | 2 | Q1,Q2 | IPT015N10N5 | IPT015N10N5 | Infineon |  |  |  | C108964 | Infineon_PG-HSOF-8-1
39 | 4 | Q3,Q4,Q5,Q6 | EPC2304 | EPC2304 | EPC | 917-EPC2304CT-ND | 9.05 |  | C6549215 | EPC2304_QFN-7_3x5mm |  | Required part (CLAUDE.md section 4); Custom footprint, drawn in Stage 3
40 | 2 | Q7,Q8 | 2N7002 | 2N7002LT1G | onsemi |  |  |  | C16338 | SOT-23
41 | 4 | R1,R2,R3,R4 | 51k | RC0603FR-0751KL | YAGEO |  |  |  |  | R_0603_1608Metric
42 | 2 | R9,R10 | 4.7 | RC0603FR-074R7L | YAGEO |  |  |  |  | R_0603_1608Metric
43 | 2 | R13,R14 | 5.6 | RC0603FR-075R6L | YAGEO |  |  |  |  | R_0603_1608Metric
44 | 2 | R15,R16 | 2 | RC0603FR-072RL | YAGEO |  |  |  |  | R_0603_1608Metric
45 | 2 | R21,R22 | 6.04k | RC0603FR-076K04L | YAGEO |  |  |  |  | R_0603_1608Metric
46 | 2 | R27,R28 | 22.6k | RC0603FR-0722K6L | YAGEO |  |  |  |  | R_0603_1608Metric
47 | 15 | R29,R30,R48,R52,R53,R55,R58,R61,R62,R81,R84,R91,R93,R94,R95 | 10k | RC0603FR-0710KL | YAGEO |  |  |  |  | R_0603_1608Metric
48 | 5 | R31,R32,R33,R34,R44 | 10 | RC0603FR-0710RL | YAGEO |  |  |  |  | R_0603_1608Metric
49 | 1 | R40 | 5.49k | RC0603FR-075K49L | YAGEO |  |  |  |  | R_0603_1608Metric
50 | 1 | R41 | 1M | RC0603FR-071ML | YAGEO |  |  |  |  | R_0603_1608Metric
51 | 1 | R43 | 330 | RC0603FR-07330RL | YAGEO |  |  |  |  | R_0603_1608Metric
52 | 1 | R45 | 95.3k | RC1206FR-0795K3L | YAGEO |  |  |  |  | R_1206_3216Metric
53 | 1 | R46 | 4.12k | RC0603FR-074K12L | YAGEO |  |  |  |  | R_0603_1608Metric
54 | 1 | R47 | 13.0k | RC0603FR-0713KL | YAGEO |  |  |  |  | R_0603_1608Metric
55 | 1 | R49 | 649k 0.1% | ERA-8AEB6493V | Panasonic |  |  |  |  | R_1206_3216Metric
56 | 4 | R50,R65,R69,R71 | 10.0k 0.1% | ERA-3AEB1002V | Panasonic |  |  |  |  | R_0603_1608Metric
57 | 1 | R51 | 1.69M | RC0603FR-071M69L | YAGEO |  |  |  |  | R_0603_1608Metric
58 | 1 | R54 | 200k | RC1206FR-07200KL | YAGEO |  |  |  |  | R_1206_3216Metric
59 | 1 | R56 | 32.4k | RC0603FR-0732K4L | YAGEO |  |  |  |  | R_0603_1608Metric
60 | 1 | R57 | 33.2k | RC0603FR-0733K2L | YAGEO |  |  |  |  | R_0603_1608Metric
61 | 3 | R59,R86,R87 | 100k | RC0603FR-07100KL | YAGEO |  |  |  |  | R_0603_1608Metric
62 | 1 | R60 | 25.5k | RC0603FR-0725K5L | YAGEO |  |  |  |  | R_0603_1608Metric
63 | 1 | R64 | 290k 0.1% | ERA-3AEB2903V | Panasonic |  |  |  |  | R_0603_1608Metric
64 | 1 | R66 | 26.1k | RC0603FR-0726K1L | YAGEO |  |  |  |  | R_0603_1608Metric
65 | 2 | R67,R68 | 52.3k | RC0603FR-0752K3L | YAGEO |  |  |  |  | R_0603_1608Metric
66 | 2 | R70,R72 | 5.97k 0.1% | ERA-3AEB5971V | Panasonic |  |  |  |  | R_0603_1608Metric
67 | 4 | R73,R75,R77,R79 | 7.50k 0.1% | ERA-3AEB7501V | Panasonic |  |  |  |  | R_0603_1608Metric
68 | 4 | R74,R76,R78,R80 | 2.67k 0.1% | ERA-3AEB2671V | Panasonic |  |  |  |  | R_0603_1608Metric
69 | 2 | R82,R88 | 1k | RC0603FR-071KL | YAGEO |  |  |  |  | R_0603_1608Metric
70 | 1 | R83 | 20k | RC0603FR-0720KL | YAGEO |  |  |  |  | R_0603_1608Metric
71 | 1 | R85 | 11.8k | RC0603FR-0711K8L | YAGEO |  |  |  |  | R_0603_1608Metric
72 | 2 | R89,R90 | 1.5k | RC0603FR-071K5L | YAGEO |  |  |  |  | R_0603_1608Metric
73 | 1 | R92 | 100 | RC0603FR-07100RL | YAGEO |  |  |  |  | R_0603_1608Metric
74 | 1 | R96 | 0R 100A | CSS2H-2512C-000 | Bourns |  |  |  |  | R_2512_CSS2H |  | Custom footprint, drawn in Stage 3
75 | 1 | RS1 | 2m | CSS2H-2512R-2L00F | Bourns |  |  |  |  | R_2512_Kelvin |  | Custom footprint, drawn in Stage 3
76 | 2 | RS2,RS3 | 0.5m | CSS2H-2512R-L500F | Bourns |  |  |  | C2073667 | R_2512_Kelvin |  | Custom footprint, drawn in Stage 3
77 | 1 | RT1 | 10k B3380 | NCP18XH103F03RB | Murata |  |  |  | C13564 | R_0603_1608Metric
78 | 2 | U1,U2 | Si8274GB1-IS1 | Si8274GB1-IS1 | Skyworks |  |  |  | C17368638 | SOIC-16_3.9x9.9mm_P1.27mm |  | Required part (CLAUDE.md section 4)
79 | 1 | U5 | LTC3861IUHE#PBF | LTC3861IUHE#PBF | Analog Devices |  |  |  | C686466 | QFN-36-1EP_5x6mm_P0.5mm_EP3.6x4.1mm
80 | 2 | U6,U7 | AMC3301 | AMC3301DWER | TI |  |  |  | C2869778 | SOIC-16W_7.5x10.3mm_P1.27mm
81 | 1 | U8 | AMC3330 | AMC3330DWER | TI |  |  |  | C2999368 | SOIC-16W_7.5x10.3mm_P1.27mm
82 | 2 | U9,U10 | INA301A3 | INA301A3IDGKR | TI |  |  |  | C2861552 | VSSOP-8_3x3mm_P0.65mm
83 | 1 | U11 | LM5012DDAR | LM5012DDAR | TI |  |  |  | C6079494 | HSOP-8-1EP_3.9x4.9mm_P1.27mm_EP2.41x3.1mm
84 | 1 | U12 | LM5069MM-2 | LM5069MM-2/NOPB | TI |  |  |  |  | MSOP-10_3x3mm_P0.5mm
85 | 1 | U13 | VOM1271T | VOM1271T | Vishay |  |  |  | C146286 | SOP-4_3.8x4.1mm_P2.54mm
86 | 3 | U14,U15,U22 | TLV3012 | TLV3012AIDBVR | TI |  |  |  | C62505 | SOT-23-6
87 | 3 | U16,U17,U18 | SN74LVC1G74 | SN74LVC1G74DCTR | TI |  |  |  | C840104 | SSOP-8_2.95x2.8mm_P0.65mm
88 | 3 | U19,U20,U25 | 74LVC1G08 | SN74LVC1G08DBVR | TI |  |  |  | C7666 | SOT-23-5
89 | 1 | U21 | TPS2553DBVR | TPS2553DBVR | TI |  |  |  | C55266 | SOT-23-6
90 | 4 | C36,C37,C38,C39 | 1n/200V | C0805C102J2GAC7800 | KEMET |  |  |  | C2170811 | C_0805_2012Metric | DNP | DNP: footprint only
91 | 4 | D10,D11,D12,D13 | SMBJ85A | SMBJ85A | Littelfuse |  |  |  |  | D_SMB | DNP | DNP: footprint only
92 | 1 | F1 | FUSE OPT | not fitted |  |  |  |  |  | Fuse_Littelfuse_NANO2_456 | DNP | Custom footprint, drawn in Stage 3; DNP: footprint only
93 | 4 | R23,R24,R25,R26 | 2.2 | RC1206FR-072R2L | YAGEO |  |  |  |  | R_1206_3216Metric | DNP | DNP: footprint only
94 | 1 | R42 | 0 | RC0603JR-070RL | YAGEO |  |  |  |  | R_0603_1608Metric | DNP | DNP: footprint only
95 | 1 | R63 | 10k | RC0603FR-0710KL | YAGEO |  |  |  |  | R_0603_1608Metric | DNP | DNP: footprint only
