tsshendo/2-Phase-interleaved-buck-converter/kicad/ECE533_Guide/ECE533_Guide.csv

Reference | Qty | Value | DNP | Exclude from BOM | Exclude from Board | Footprint | Datasheet
AT1,AT2 | 2 | SI86S620BC-IS |  |  |  | SOIC127P600X175-8N | https://www.skyworksinc.com/-/media/SkyWorks/SL/documents/public/data-sheets/si86s61x_2x_Ox-datasheet.pdf
C1,C2,C3,C4 | 4 | 2.5uF
C5 | 1 | 100uF
C6 | 1 | 440uF
C7,C8,C9,C10,C11,C13 | 6 | 100nF
C12,C14 | 2 | 10uF
D1,D2,D3,D4 | 4 | SS110 |  |  |  | Diode_SMD:D_SMA | https://www.smc-diodes.com/propdf/SS12-SS110%20N0229%20REV.C.pdf
J1 | 1 | DC+
J2 | 1 | Power_out
J3 | 1 | DC-
J4 | 1 | 105313-1206 |  |  |  | 1053131206 | http://www.molex.com/webdocs/datasheets/pdf/en-us//1053131206_PCB_HEADERS.pdf
L1 | 1 | ERUC23-3R2K |  |  |  | ERUC233R2K | https://product.tdk.com/system/files/dam/doc/product/inductor/inductor/high/data_sheet/b82559sxm023.pdf
PS1 | 1 | NME1S0505SC |  |  |  | NME1S0505SC | https://www.murata.com/products/productdata/8822286319646/KDC-NME1.pdf?1689910216000
Q3,Q4,Q5,Q6 | 4 | EPC2304 |  |  |  | EPC2308 | https://epc-co.com/epc/documents/datasheets/EPC2304_datasheet.pdf
R1,R2,R3,R4,R5,R6,R7,R8 | 8 | 51k
R9,R10,R11,R12 | 4 | 4.7R
R13,R14,R19,R20 | 4 | 6R
R15,R16,R17,R18 | 4 | 2R
U1,U2,U3,U4 | 4 | 1EDN7550B |  |  |  | Package_TO_SOT_SMD:SOT-23-6 | https://www.infineon.com/dgdl/Infineon-1EDN7550B-DS-v02_00-EN.pdf?fileId=5546d46262b31d2e01635d9799ef264f
