tsshendo/2-Phase-interleaved-buck-converter/sim/ltspice/Parasitic_Cap.asc

C1: cap; 71.53p
C5: cap; 13.99p
C7: cap; 141.1p
L1: ind; 1.02n
L4: ind; 5.14n
R1: res; 0.94m
R4: res; 10.075m
V1: voltage; PULSE(0 72 0 20n 20n 1.666u 5u); AC 1
Named nets: 0
.ac dec 1000 10k 1G
