tsshendo/2-Phase-interleaved-buck-converter/sim/ltspice/ECE533_IL_Buck_parasitics (2).asc

C1: cap; {Cd}
C2: cap; 440µ
C3: cap; {Cd}
C4: cap; {0.5*Cd}
C5: cap; 100n
C6: cap; 100n
C8: cap; 100µ
D1: schottky; 1N5817
D2: schottky; 1N5817
I1: current; PULSE(0 1m 0 10n 10n 2.5u 5u)
I2: current; PULSE(0 1m 2.5u 10n 10n 2.5u 5u)
L1: ERUC
L2: ind; 0.11n
L3: ind; {Lp}
L4: ind; 0.11n
L5: ind; 9.79n
L6: ind; {Lp}
L7: ind; {Lp}
L8: ind; {Lp}
L9: ind; 0.11n
L10: ind; 0.11n
L11: ind; 9.79n
L12: ind; 4.93n
L13: ind; 4.93n
R1: res; 0.1m
R2: res; {Rpd}
R3: res; 0.25m
R4: res; {Rg1}
R5: res; 0.25m
R6: res; 0.25m
R7: res; {Rpd}
R8: res; {Rpd}
R9: res; {Rg1}
R10: res; {Rg2}
R11: res; {Rg2}
R12: res; {Rpd}
R13: res; 0.1m
R14: res; 0.1m
R15: res; 0.1m
R16: res; 22.7m
R17: res; 22.7m
R18: res; 12.6m
R19: res; 12.6m
R: res; 0.25m
Rload: res; 0.521
U1: EPCGaN; EPC2304
U2: EPCGaN; EPC2304
U3: EPCGaN; EPC2304
U4: EPCGaN; EPC2304
V1: voltage; PULSE(0 5 0 {tr} {tf} 1.666u 5u)
V2: voltage; PULSE(0 5 1.766u {tr} {tf} 3.1344u 5u)
V3: voltage; PULSE(0 5 2.5u {tr} {tf} 1.666u 5u)
V4: voltage; PULSE(0 5 4.266u {tr} {tf} 3.1344u 5u)
V5: voltage; 5
V6: voltage; 5
VIN: voltage; 72
Named nets: 0
.inc EPCGaNLibrary.lib
.inc ERUC.sub
.tran 0 1m 0 100n
.param Rg1=2
.param tr=5n
.param tf=5n
.param Lp=0.47n
.param Cd=5u
.param Rg2=6
.param Rpd=1k
