tsshendo/2-Phase-interleaved-buck-converter/kicad/PowerModule/PowerModule.kicad_pcb

## KiCad design kicad/PowerModule/PowerModule.kicad_pcb (2026-10-18)

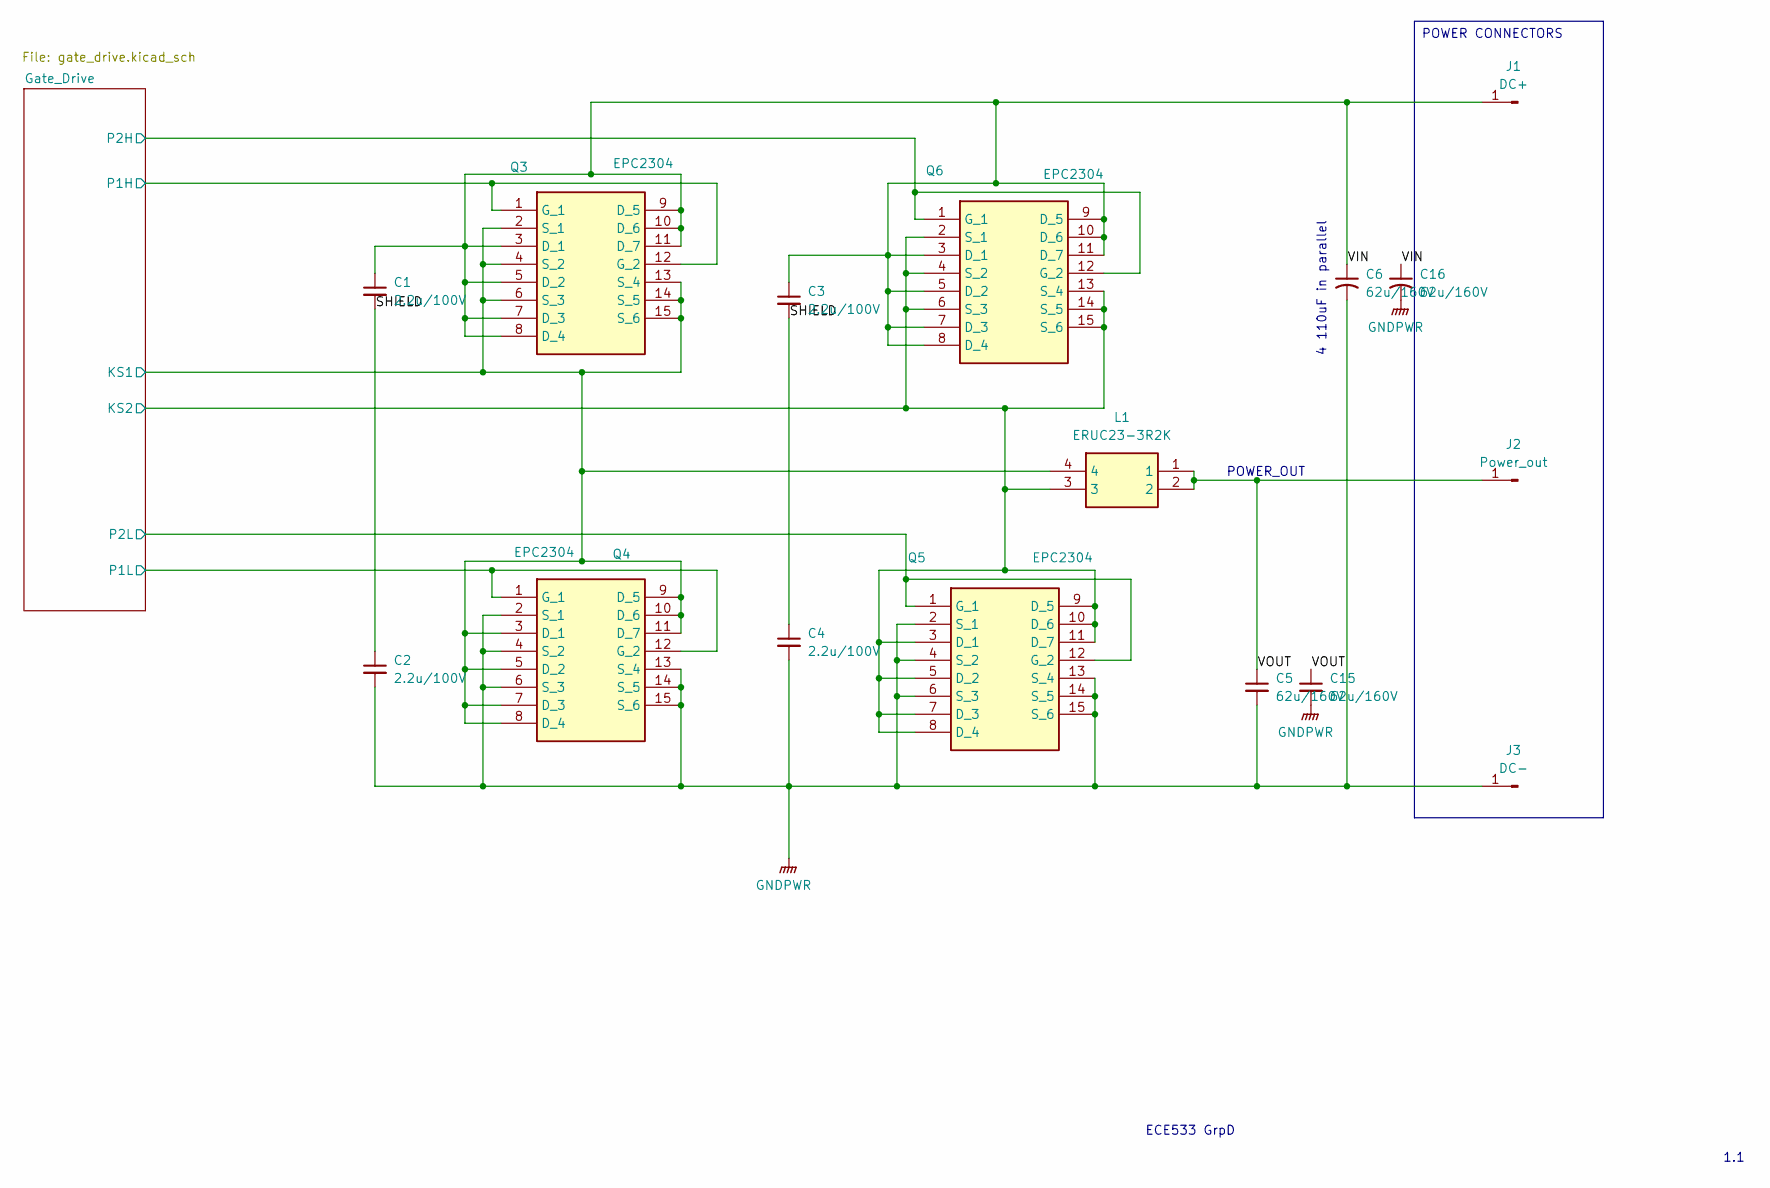
[picture p121: schematic PowerModule.kicad_sch]

Parts:
C1, C2, C3, C4: 2.2u/100V; C_0805_2012Metric; MPN GRM21BD72A225KE01L; LCSC C2981733
C5, C6, C15, C16: 62u/160V; CP_Radial_D10.0mm_P5.00mm; MPN EGXF161ELL620MJ25S
J1: DC+; Wurth_REDCUBE_74650194; MPN 74650194R
J2: Power_out; Wurth_REDCUBE_74650194; MPN 74650194R
J3: DC-; Wurth_REDCUBE_74650194; MPN 74650194R
L1: ERUC23-3R2K; TDK_ERUC23; Manufacturer_Part_Number ERUC23-3R2K; Mouser Part Number 871-ERUC23-3R2K
Q3, Q4, Q5, Q6: EPC2304; EPC2304_QFN-7_3x5mm_15pin; Manufacturer_Part_Number EPC2304; LCSC C6549215

Connections:
/Gate_Drive/KS1: L1.4, Q3.2 (S_1), Q3.4 (S_2), Q3.6 (S_3), Q3.13 (S_4), Q3.14 (S_5), Q3.15 (S_6), Q4.3 (D_1), Q4.5 (D_2), Q4.7 (D_3), Q4.8 (D_4), Q4.9 (D_5), Q4.10 (D_6), Q4.11 (D_7); also elsewhere on the board
/Gate_Drive/KS2: L1.3, Q5.3 (D_1), Q5.5 (D_2), Q5.7 (D_3), Q5.8 (D_4), Q5.9 (D_5), Q5.10 (D_6), Q5.11 (D_7), Q6.2 (S_1), Q6.4 (S_2), Q6.6 (S_3), Q6.13 (S_4), Q6.14 (S_5), Q6.15 (S_6); also elsewhere on the board
/Gate_Drive/P1H: Q3.1 (G_1), Q3.12 (G_2); also elsewhere on the board
/Gate_Drive/P1L: Q4.1 (G_1), Q4.12 (G_2); also elsewhere on the board
/Gate_Drive/P2H: Q6.1 (G_1), Q6.12 (G_2); also elsewhere on the board
/Gate_Drive/P2L: Q5.1 (G_1), Q5.12 (G_2); also elsewhere on the board
/SHIELD: C1.2, C2.1, C3.2, C4.1
/VIN: C1.1, C3.1, C6.1, C16.1, J1.1, Q3.3 (D_1), Q3.5 (D_2), Q3.7 (D_3), Q3.8 (D_4), Q3.9 (D_5), Q3.10 (D_6), Q3.11 (D_7), Q6.3 (D_1), Q6.5 (D_2), Q6.7 (D_3), Q6.8 (D_4), Q6.9 (D_5), Q6.10 (D_6), Q6.11 (D_7)
/VOUT: C5.1, C15.1, J2.1, L1.1, L1.2
GNDPWR: C2.2, C4.2, C5.2, C6.2, C15.2, C16.2, J3.1, Q4.2 (S_1), Q4.4 (S_2), Q4.6 (S_3), Q4.13 (S_4), Q4.14 (S_5), Q4.15 (S_6), Q5.2 (S_1), Q5.4 (S_2), Q5.6 (S_3), Q5.13 (S_4), Q5.14 (S_5), Q5.15 (S_6); also elsewhere on the board

Notes on the sheet:
POWER_OUT
ECE533 GrpD
1.1
4 110uF in parallel
POWER CONNECTORS

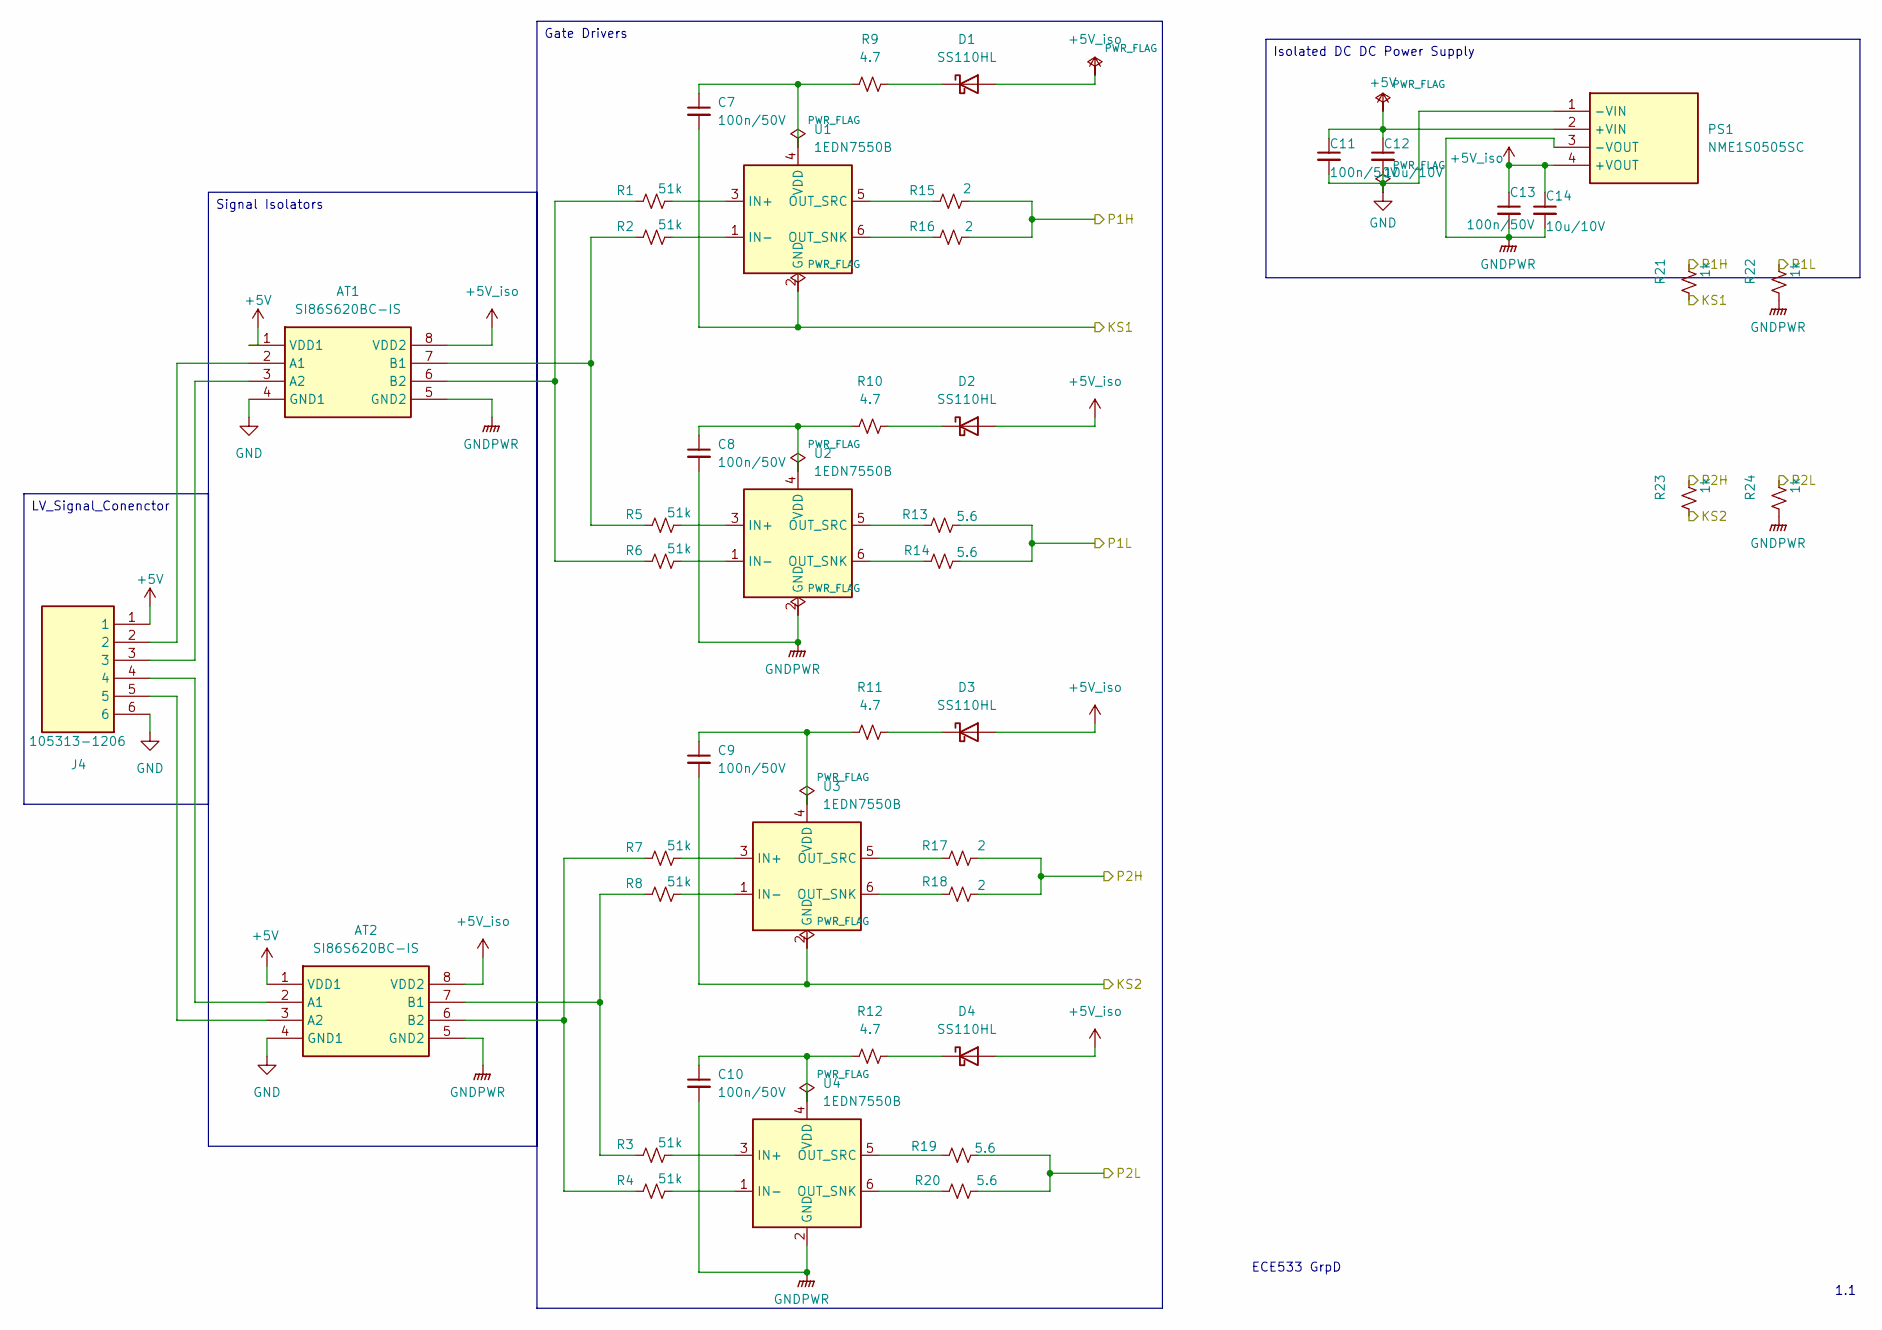
[picture p122: schematic gate_drive.kicad_sch]

Parts:
AT1, AT2: SI86S620BC-IS; SOIC-8_3.9x4.9mm_P1.27mm; Manufacturer_Part_Number SI86S620BC-IS; Mouser Part Number 873-SI86S620BC-IS
C7, C8, C9, C10, C11, C13: 100n/50V; C_0603_1608Metric; MPN GRM188R71H104KA93D; LCSC C77055
C12, C14: 10u/10V; C_0805_2012Metric; MPN GRM21BR71A106KE51L; LCSC C86038
D1, D2, D3, D4: SS110HL; D_SOD-123F; MPN SS110HL-TP; LCSC C19996385
J4: 105313-1206; Molex_Nano-Fit_105313-1206_RA; Manufacturer_Part_Number 105313-1206; Mouser Part Number 538-105313-1206
PS1: NME1S0505SC; Murata_NME1S_SIP-4; Manufacturer_Part_Number NME1S0505SC; Mouser Part Number 580-NME1S0505SC
R1, R2, R3, R4, R5, R6, R7, R8: 51k; R_0603_1608Metric; MPN RC0603FR-0751KL
R9, R10, R11, R12: 4.7; R_0603_1608Metric; MPN RC0603FR-074R7L
R13, R14, R19, R20: 5.6; R_0603_1608Metric; MPN RC0603FR-075R6L
R15, R16, R17, R18: 2; R_0603_1608Metric; MPN RC0603FR-072RL
R21, R22, R23, R24: 1k; R_0603_1608Metric; MPN RC0603FR-071KL
U1, U2, U3, U4: 1EDN7550B; SOT-23-6; MPN 1EDN7550BXTSA1

Connections:
+5V: AT1.1 (VDD1), AT2.1 (VDD1), C11.1, C12.1, J4.1, PS1.2 (+VIN)
+5V_iso: AT1.8 (VDD2), AT2.8 (VDD2), C13.1, C14.1, D1.2 (A), D2.2 (A), D3.2 (A), D4.2 (A), PS1.4 (+VOUT)
/Gate_Drive/KS1: C7.2, R21.2, U1.2 (GND); also elsewhere on the board
/Gate_Drive/KS2: C9.2, R23.2, U3.2 (GND); also elsewhere on the board
/Gate_Drive/P1H: R15.1, R16.1, R21.1; also elsewhere on the board
/Gate_Drive/P1L: R13.1, R14.1, R22.1; also elsewhere on the board
/Gate_Drive/P2H: R17.1, R18.1, R23.1; also elsewhere on the board
/Gate_Drive/P2L: R19.1, R20.1, R24.1; also elsewhere on the board
GND: AT1.4 (GND1), AT2.4 (GND1), C11.2, C12.2, J4.6, PS1.1 (-VIN)
GNDPWR: AT1.5 (GND2), AT2.5 (GND2), C8.2, C10.2, C13.2, C14.2, PS1.3 (-VOUT), R22.2, R24.2, U2.2 (GND), U4.2 (GND); also elsewhere on the board
unnamed: AT1.2 (A1), J4.2
unnamed: AT1.3 (A2), J4.3
unnamed: AT1.7 (B1), R2.2, R5.2
unnamed: AT1.6 (B2), R1.2, R6.2
unnamed: AT2.2 (A1), J4.4
unnamed: AT2.3 (A2), J4.5
unnamed: AT2.7 (B1), R3.2, R8.2
unnamed: AT2.6 (B2), R4.2, R7.2
unnamed: D1.1 (K), R9.1
unnamed: D2.1 (K), R10.1
unnamed: D3.1 (K), R11.1
unnamed: D4.1 (K), R12.1
unnamed: R1.1, U1.3 (IN+)
unnamed: R2.1, U1.1 (IN-)
unnamed: R16.2, U1.6 (OUT_SNK)
unnamed: R15.2, U1.5 (OUT_SRC)
unnamed: C7.1, R9.2, U1.4 (VDD)
unnamed: R5.1, U2.3 (IN+)
unnamed: R6.1, U2.1 (IN-)
unnamed: R14.2, U2.6 (OUT_SNK)
unnamed: R13.2, U2.5 (OUT_SRC)
unnamed: C8.1, R10.2, U2.4 (VDD)
unnamed: R7.1, U3.3 (IN+)
unnamed: R8.1, U3.1 (IN-)
unnamed: R18.2, U3.6 (OUT_SNK)
unnamed: R17.2, U3.5 (OUT_SRC)
unnamed: C9.1, R11.2, U3.4 (VDD)
unnamed: R3.1, U4.3 (IN+)
unnamed: R4.1, U4.1 (IN-)
unnamed: R20.2, U4.6 (OUT_SNK)
unnamed: R19.2, U4.5 (OUT_SRC)
unnamed: C10.1, R12.2, U4.4 (VDD)

Notes on the sheet:
ECE533 GrpD
1.1
LV_Signal_Conenctor
Isolated DC DC Power Supply
Gate Drivers
Signal Isolators

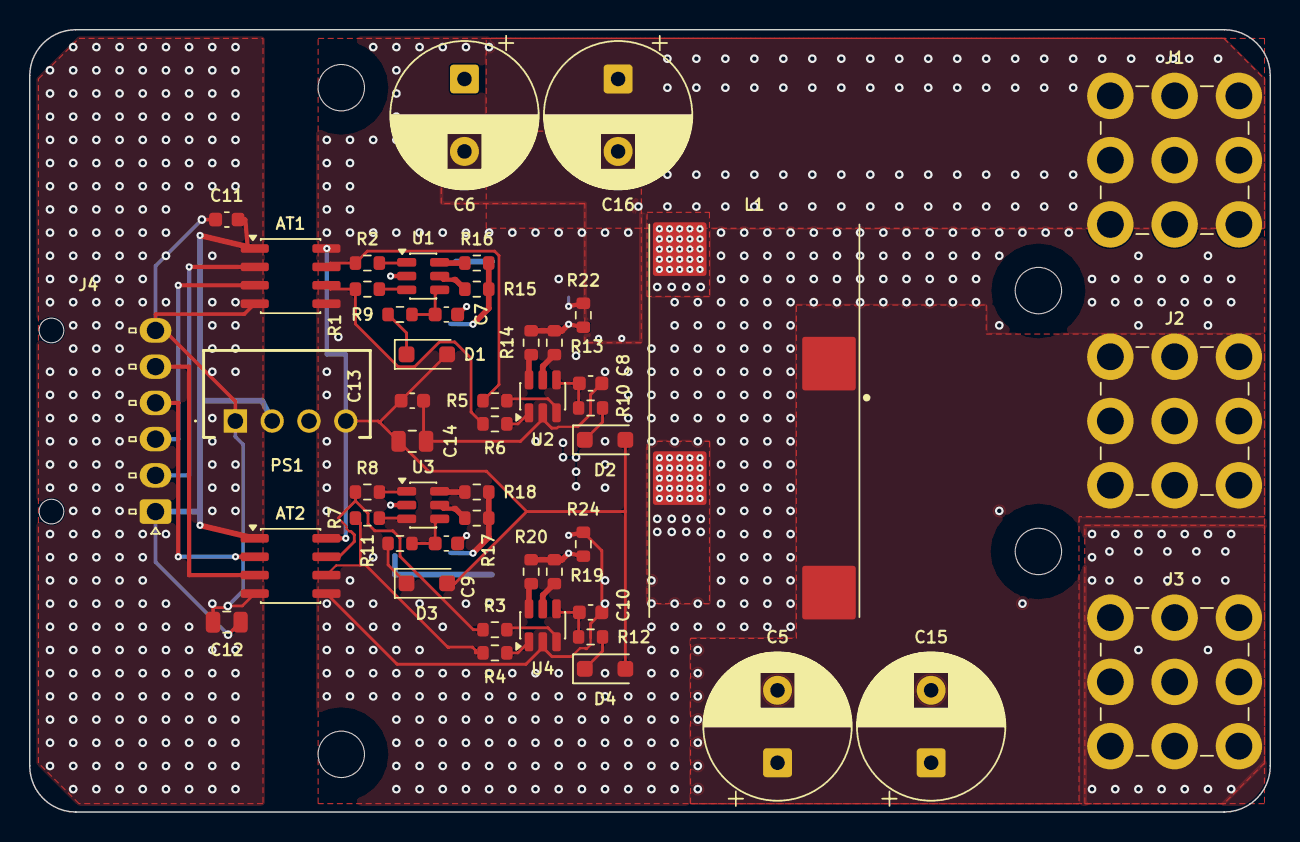
[picture p123: board PowerModule.kicad_pcb from above]

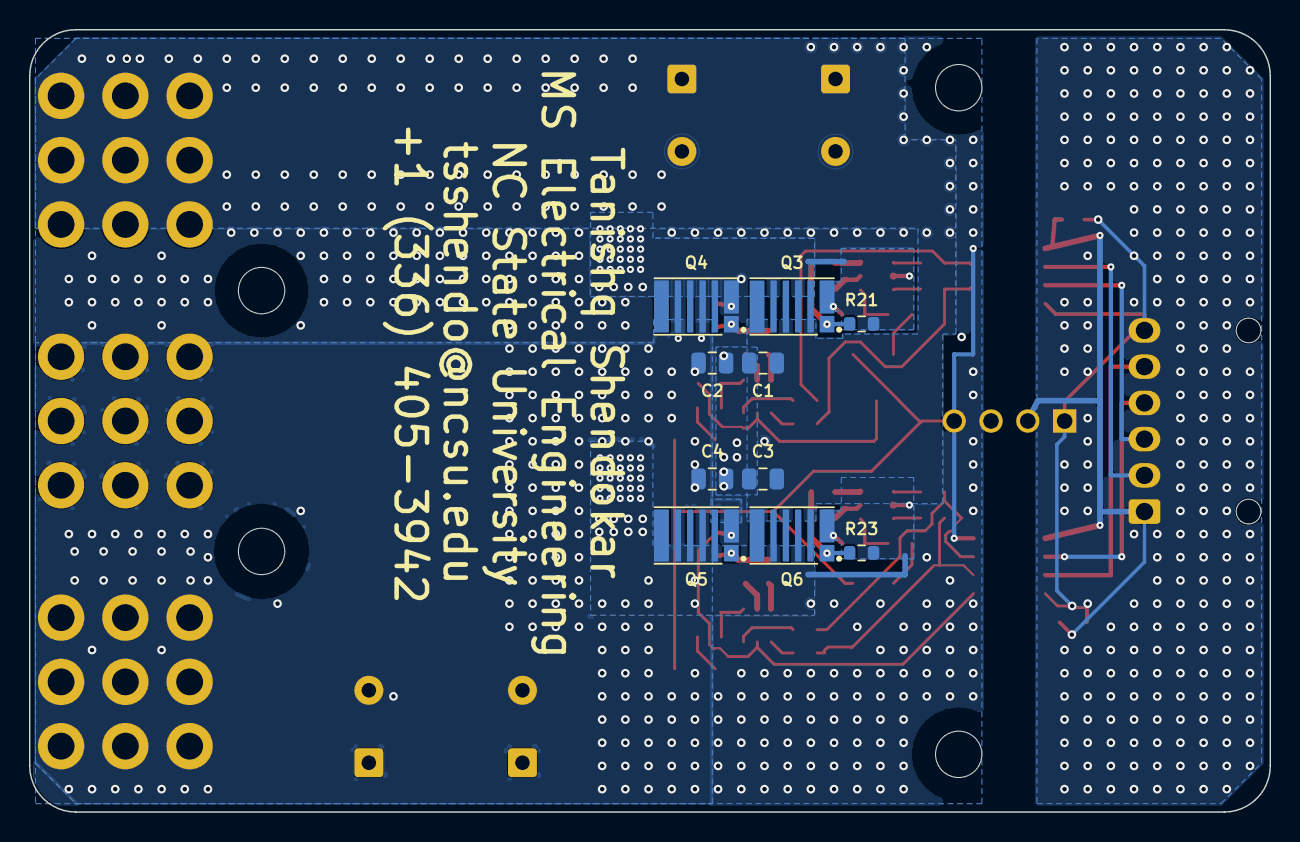
[picture p124: board PowerModule.kicad_pcb from below]

Board: 4 copper layers, 85.6 x 54.0 mm, 64 parts (10 on the bottom side), 45 nets.

Other parts of the board:
H1, H2, H3, H4: M3 heatsink; MountingHole_3.2mm_M3
