tsshendo/2-Phase-interleaved-buck-converter/kicad/ECE533_Guide/ECE533_Guide.kicad_pcb

## KiCad design kicad/ECE533_Guide/ECE533_Guide.kicad_pcb (2026-10-17)

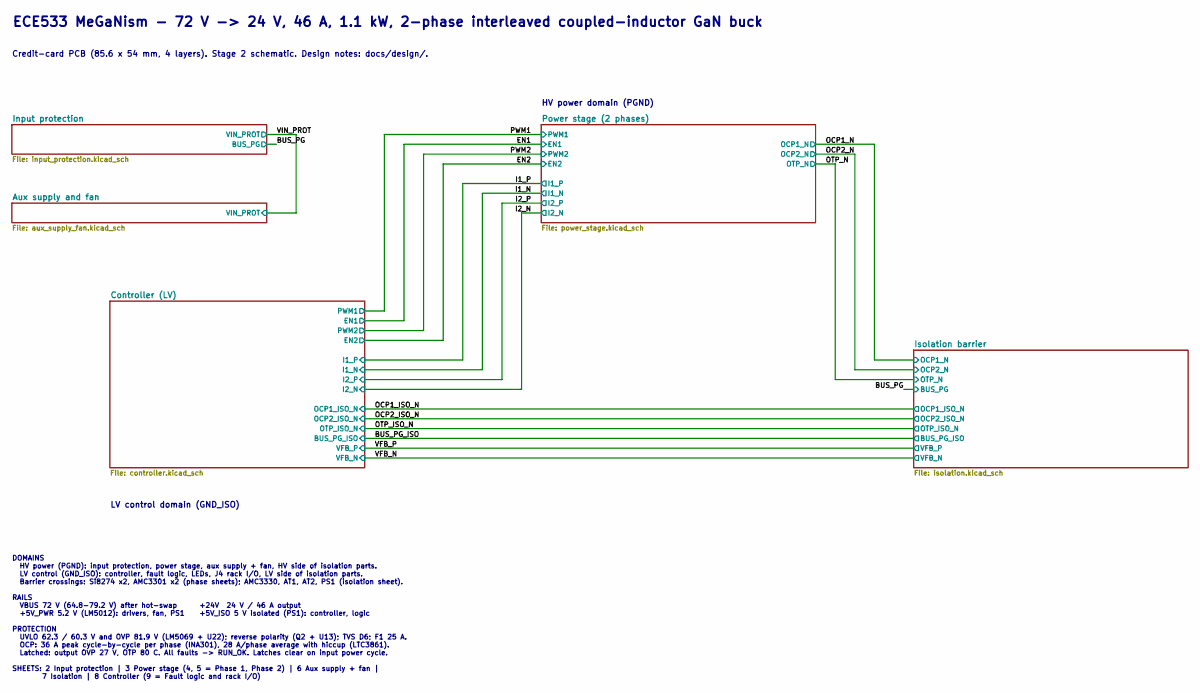
[picture p125: schematic ECE533_Guide.kicad_sch, Overview and block diagram]

Notes on the sheet:
ECE533 MeGaNism - 72 V -> 24 V, 46 A, 1.1 kW, 2-phase interleaved coupled-inductor GaN buck
Credit-card PCB (85.6 x 54 mm, 4 layers). Stage 2 schematic. Design notes: docs/design/.
HV power domain (PGND)
LV control domain (GND_ISO)
DOMAINS HV power (PGND): input protection, power stage, aux supply + fan, HV side of isolation parts. LV control (GND_ISO): controller, fault logic, LEDs, J4 rack I/O, LV side of isolation parts. Barrier crossings: Si8274 x2, AMC3301 x2 (phase sheets); AMC3330, AT1, AT2, PS1 (isolation sheet). RAIL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

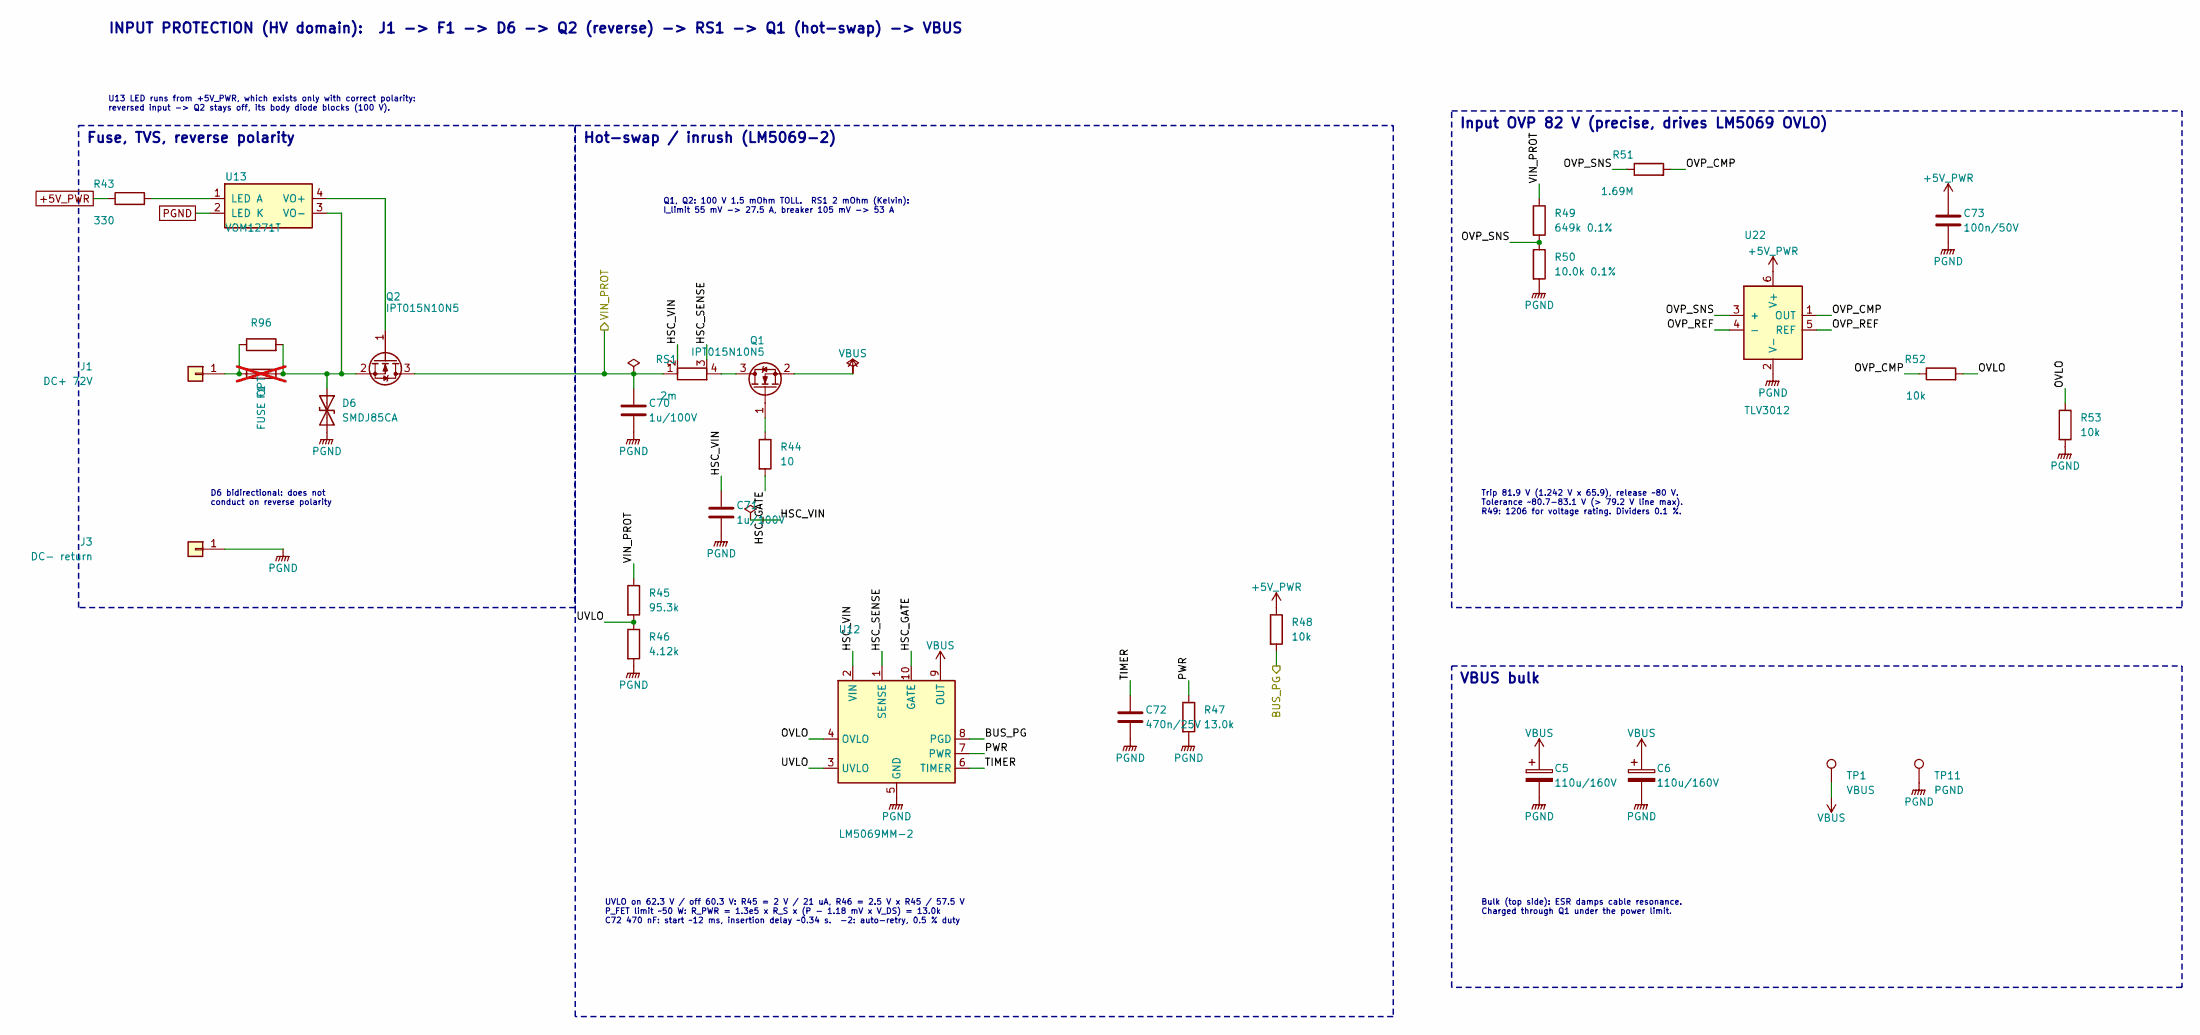
[picture p126: schematic input_protection.kicad_sch, Input protection and hot-swap]

Parts:
C5, C6: 110u/160V; CP_Radial_D12.5mm_P5.00mm; MPN EGXF161ELL111MK25S; LCSC C1598290
C70, C71: 1u/100V; C_0805_2012Metric; MPN CC0805KKX7R0BB105; LCSC C5370002
C72: 470n/25V; C_0603_1608Metric; MPN GRM188R71E474KA12D; LCSC C77052
C73: 100n/50V; C_0603_1608Metric; MPN GRM188R71H104KA93D; LCSC C77055
D6: SMDJ85CA; D_SMC; MPN SMDJ85CA; LCSC C1978008
F1: FUSE OPT; Fuse_Littelfuse_NANO2_456; MPN not fitted; not fitted
J1: DC+ 72V; Wurth_REDCUBE_74650194; MPN 74650194R
J3: DC- return; Wurth_REDCUBE_74650194; MPN 74650194R
Q1, Q2: IPT015N10N5; Infineon_PG-HSOF-8-1; MPN IPT015N10N5; LCSC C108964
R43: 330; R_0603_1608Metric; MPN RC0603FR-07330RL
R44: 10; R_0603_1608Metric; MPN RC0603FR-0710RL
R45: 95.3k; R_1206_3216Metric; MPN RC1206FR-0795K3L
R46: 4.12k; R_0603_1608Metric; MPN RC0603FR-074K12L
R47: 13.0k; R_0603_1608Metric; MPN RC0603FR-0713KL
R48, R52, R53: 10k; R_0603_1608Metric; MPN RC0603FR-0710KL
R49: 649k 0.1%; R_1206_3216Metric; MPN ERA-8AEB6493V
R50: 10.0k 0.1%; R_0603_1608Metric; MPN ERA-3AEB1002V
R51: 1.69M; R_0603_1608Metric; MPN RC0603FR-071M69L
R96: 0R 100A; R_2512_CSS2H; MPN CSS2H-2512C-000
RS1: 2m; R_2512_Kelvin; MPN CSS2H-2512R-2L00F
TP1: VBUS; TestPoint_Pad_D1.0mm; MPN Test pad (bare copper)
TP11: PGND; TestPoint_Pad_D1.0mm; MPN Test pad (bare copper)
U12: LM5069MM-2; MSOP-10_3x3mm_P0.5mm; MPN LM5069MM-2/NOPB
U13: VOM1271T; SOP-4_3.8x4.1mm_P2.54mm; MPN VOM1271T; LCSC C146286
U22: TLV3012; SOT-23-6; MPN TLV3012AIDBVR; LCSC C62505

Connections:
+5V_PWR: C73.1, R43.1, R48.1, U22.6 (V+); also elsewhere on the board
/BUS_PG: R48.2, U12.8 (PGD); also elsewhere on the board
/Input protection/HSC_GATE: R44.2, U12.10 (GATE)
/Input protection/HSC_SENSE: RS1.3, U12.1 (SENSE)
/Input protection/HSC_VIN: C71.1, RS1.2, U12.2 (VIN)
/Input protection/OVLO: R52.2, R53.1, U12.4 (OVLO)
/Input protection/OVP_CMP: R51.2, R52.1, U22.1 (OUT)
/Input protection/OVP_REF: U22.4 (-), U22.5 (REF)
/Input protection/OVP_SNS: R49.2, R50.1, R51.1, U22.3 (+)
/Input protection/PWR: R47.1, U12.7 (PWR)
/Input protection/TIMER: C72.1, U12.6 (TIMER)
/Input protection/UVLO: R45.2, R46.1, U12.3 (UVLO)
/VIN_PROT: C70.1, Q2.3 (D), R45.1, R49.1, RS1.1; also elsewhere on the board
unnamed: D6.1 (A1), F1.2, Q2.2 (S), R96.2, U13.3 (VO-)
unnamed: F1.1, J1.1, R96.1
unnamed: Q1.3 (D), RS1.4
unnamed: Q1.1 (G), R44.1
unnamed: Q2.1 (G), U13.4 (VO+)
unnamed: R43.2, U13.1 (LED A)
PGND: C5.2, C6.2, C70.2, C71.2, C72.2, C73.2, D6.2 (A2), J3.1, R46.2, R47.2, R50.2, R53.2, TP11.1, U12.5 (GND), U13.2 (LED K), U22.2 (V-); also elsewhere on the board
VBUS: C5.1, C6.1, Q1.2 (S), TP1.1, U12.9 (OUT); also elsewhere on the board

Notes on the sheet:
INPUT PROTECTION (HV domain): J1 -> F1 -> D6 -> Q2 (reverse) -> RS1 -> Q1 (hot-swap) -> VBUS
D6 bidirectional: does not conduct on reverse polarity
U13 LED runs from +5V_PWR, which exists only with correct polarity: reversed input -> Q2 stays off, its body diode blocks (100 V).
Fuse, TVS, reverse polarity
Q1, Q2: 100 V 1.5 mOhm TOLL. RS1 2 mOhm (Kelvin): I_limit 55 mV -> 27.5 A, breaker 105 mV -> 53 A
UVLO on 62.3 V / off 60.3 V: R45 = 2 V / 21 uA, R46 = 2.5 V x R45 / 57.5 V P_FET limit ~50 W: R_PWR = 1.3e5 x R_S x (P - 1.18 mV x V_DS) = 13.0k C72 470 nF: start ~12 ms, insertion delay ~0.34 s. -2: auto-retry, 0.5 % duty
Hot-swap / inrush (LM5069-2)
Trip 81.9 V (1.242 V x 65.9), release ~80 V. Tolerance ~80.7-83.1 V (> 79.2 V line max). R49: 1206 for voltage rating. Dividers 0.1 %.
Input OVP 82 V (precise, drives LM5069 OVLO)
Bulk (top side): ESR damps cable resonance. Charged through Q1 under the power limit.
VBUS bulk

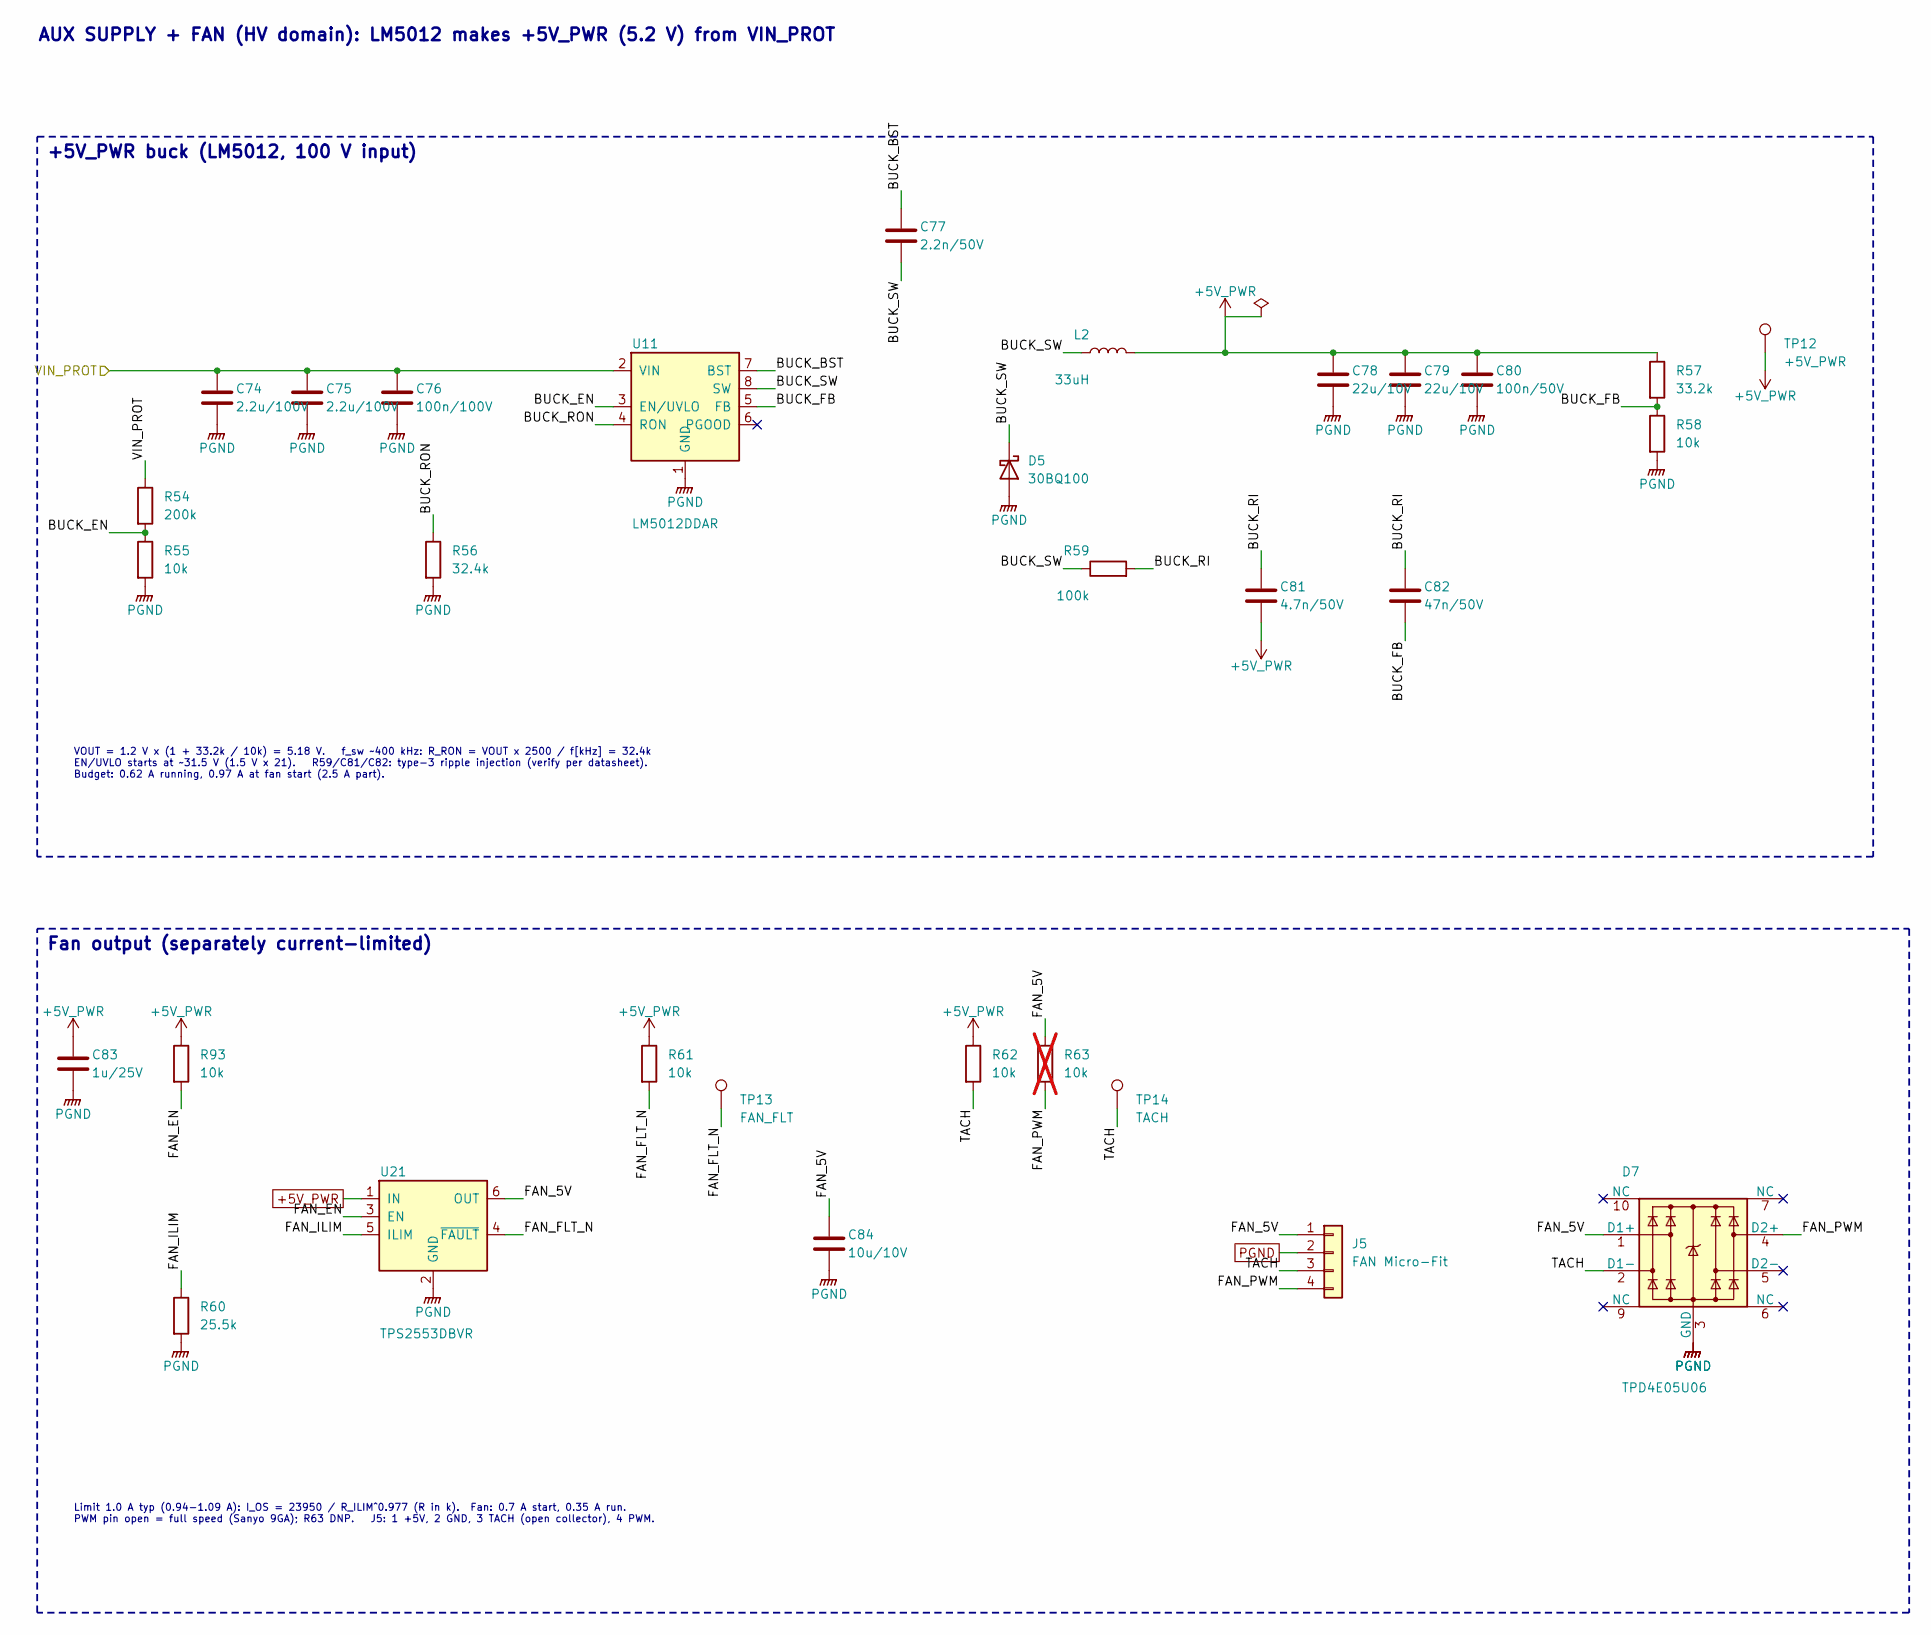
[picture p127: schematic aux_supply_fan.kicad_sch, Aux supply (+5V_PWR) and fan]

Parts:
C74, C75: 2.2u/100V; C_0805_2012Metric; MPN GRM21BD72A225KE01L; LCSC C2981733
C76: 100n/100V; C_0603_1608Metric; MPN GRM188R72A104KA35D; LCSC C77058
C77: 2.2n/50V; C_0603_1608Metric; MPN GRM188R71H222KA01D; LCSC C86023
C78, C79: 22u/10V; C_1206_3216Metric; MPN GRM31CR71A226KE15L; LCSC C91604
C80: 100n/50V; C_0603_1608Metric; MPN GRM188R71H104KA93D; LCSC C77055
C81: 4.7n/50V; C_0603_1608Metric; MPN GRM188R71H472KA01D; LCSC C77057
C82: 47n/50V; C_0603_1608Metric; MPN GRM188R71H473KA61D; LCSC C86027
C83: 1u/25V; C_0603_1608Metric; MPN GRM188R71E105KA12D; LCSC C86020
C84: 10u/10V; C_0805_2012Metric; MPN GRM21BR71A106KE51L; LCSC C86038
D5: 30BQ100; D_SMC; MPN VS-30BQ100TRPBF
D7: TPD4E05U06; USON-10_2.5x1.0mm_P0.5mm; MPN TPD4E05U06DQAR; LCSC C138714
J5: FAN Micro-Fit; Molex_Micro-Fit_3.0_43650-0400_1x04_P3.00mm_Horizontal; MPN 43650-0400; LCSC C277684
L2: 33uH; L_Coilcraft_XAL7070-XXX; MPN XAL7070-333MEB
R54: 200k; R_1206_3216Metric; MPN RC1206FR-07200KL
R55, R58, R61, R62, R93: 10k; R_0603_1608Metric; MPN RC0603FR-0710KL
R56: 32.4k; R_0603_1608Metric; MPN RC0603FR-0732K4L
R57: 33.2k; R_0603_1608Metric; MPN RC0603FR-0733K2L
R59: 100k; R_0603_1608Metric; MPN RC0603FR-07100KL
R60: 25.5k; R_0603_1608Metric; MPN RC0603FR-0725K5L
R63: 10k; R_0603_1608Metric; MPN RC0603FR-0710KL; not fitted
TP12: +5V_PWR; TestPoint_Pad_D1.0mm; MPN Test pad (bare copper)
TP13: FAN_FLT; TestPoint_Pad_D1.0mm; MPN Test pad (bare copper)
TP14: TACH; TestPoint_Pad_D1.0mm; MPN Test pad (bare copper)
U11: LM5012DDAR; HSOP-8-1EP_3.9x4.9mm_P1.27mm_EP2.41x3.1mm; MPN LM5012DDAR; LCSC C6079494
U21: TPS2553DBVR; SOT-23-6; MPN TPS2553DBVR; LCSC C55266

Connections:
+5V_PWR: C78.1, C79.1, C80.1, C81.2, C83.1, L2.2, R57.1, R61.1, R62.1, R93.1, TP12.1, U21.1 (IN); also elsewhere on the board
/Aux supply and fan/BUCK_BST: C77.1, U11.7 (BST)
/Aux supply and fan/BUCK_EN: R54.2, R55.1, U11.3 (EN/UVLO)
/Aux supply and fan/BUCK_FB: C82.2, R57.2, R58.1, U11.5 (FB)
/Aux supply and fan/BUCK_RI: C81.1, C82.1, R59.2
/Aux supply and fan/BUCK_RON: R56.1, U11.4 (RON)
/Aux supply and fan/BUCK_SW: C77.2, D5.1 (K), L2.1, R59.1, U11.8 (SW)
/Aux supply and fan/FAN_5V: C84.1, D7.1 (D1+), J5.1, R63.1, U21.6 (OUT)
/Aux supply and fan/FAN_EN: R93.2, U21.3 (EN)
/Aux supply and fan/FAN_FLT_N: R61.2, TP13.1, U21.4 (~FAULT)
/Aux supply and fan/FAN_ILIM: R60.1, U21.5 (ILIM)
/Aux supply and fan/FAN_PWM: D7.4 (D2+), J5.4, R63.2
/Aux supply and fan/TACH: D7.2 (D1-), J5.3, R62.2, TP14.1
/VIN_PROT: C74.1, C75.1, C76.1, R54.1, U11.2 (VIN); also elsewhere on the board
PGND: C74.2, C75.2, C76.2, C78.2, C79.2, C80.2, C83.2, C84.2, D5.2 (A), D7.3 (GND), D7.8 (GND), J5.2, R55.2, R56.2, R58.2, R60.2, U11.1 (GND), U11.9 (GND), U21.2 (GND); also elsewhere on the board

Notes on the sheet:
AUX SUPPLY + FAN (HV domain): LM5012 makes +5V_PWR (5.2 V) from VIN_PROT
VOUT = 1.2 V x (1 + 33.2k / 10k) = 5.18 V. f_sw ~400 kHz: R_RON = VOUT x 2500 / f[kHz] = 32.4k EN/UVLO starts at ~31.5 V (1.5 V x 21). R59/C81/C82: type-3 ripple injection (verify per datasheet). Budget: 0.62 A running, 0.97 A at fan start (2.5 A part).
+5V_PWR buck (LM5012, 100 V input)
Limit 1.0 A typ (0.94-1.09 A): I_OS = 23950 / R_ILIM^0.977 (R in k). Fan: 0.7 A start, 0.35 A run. PWM pin open = full speed (Sanyo 9GA); R63 DNP. J5: 1 +5V, 2 GND, 3 TACH (open collector), 4 PWM.
Fan output (separately current-limited)
