tsshendo/2-Phase-interleaved-buck-converter/kicad/ECE533_Guide/ECE533_Guide.kicad_pcb

## KiCad design kicad/ECE533_Guide/ECE533_Guide.kicad_pcb (continued)

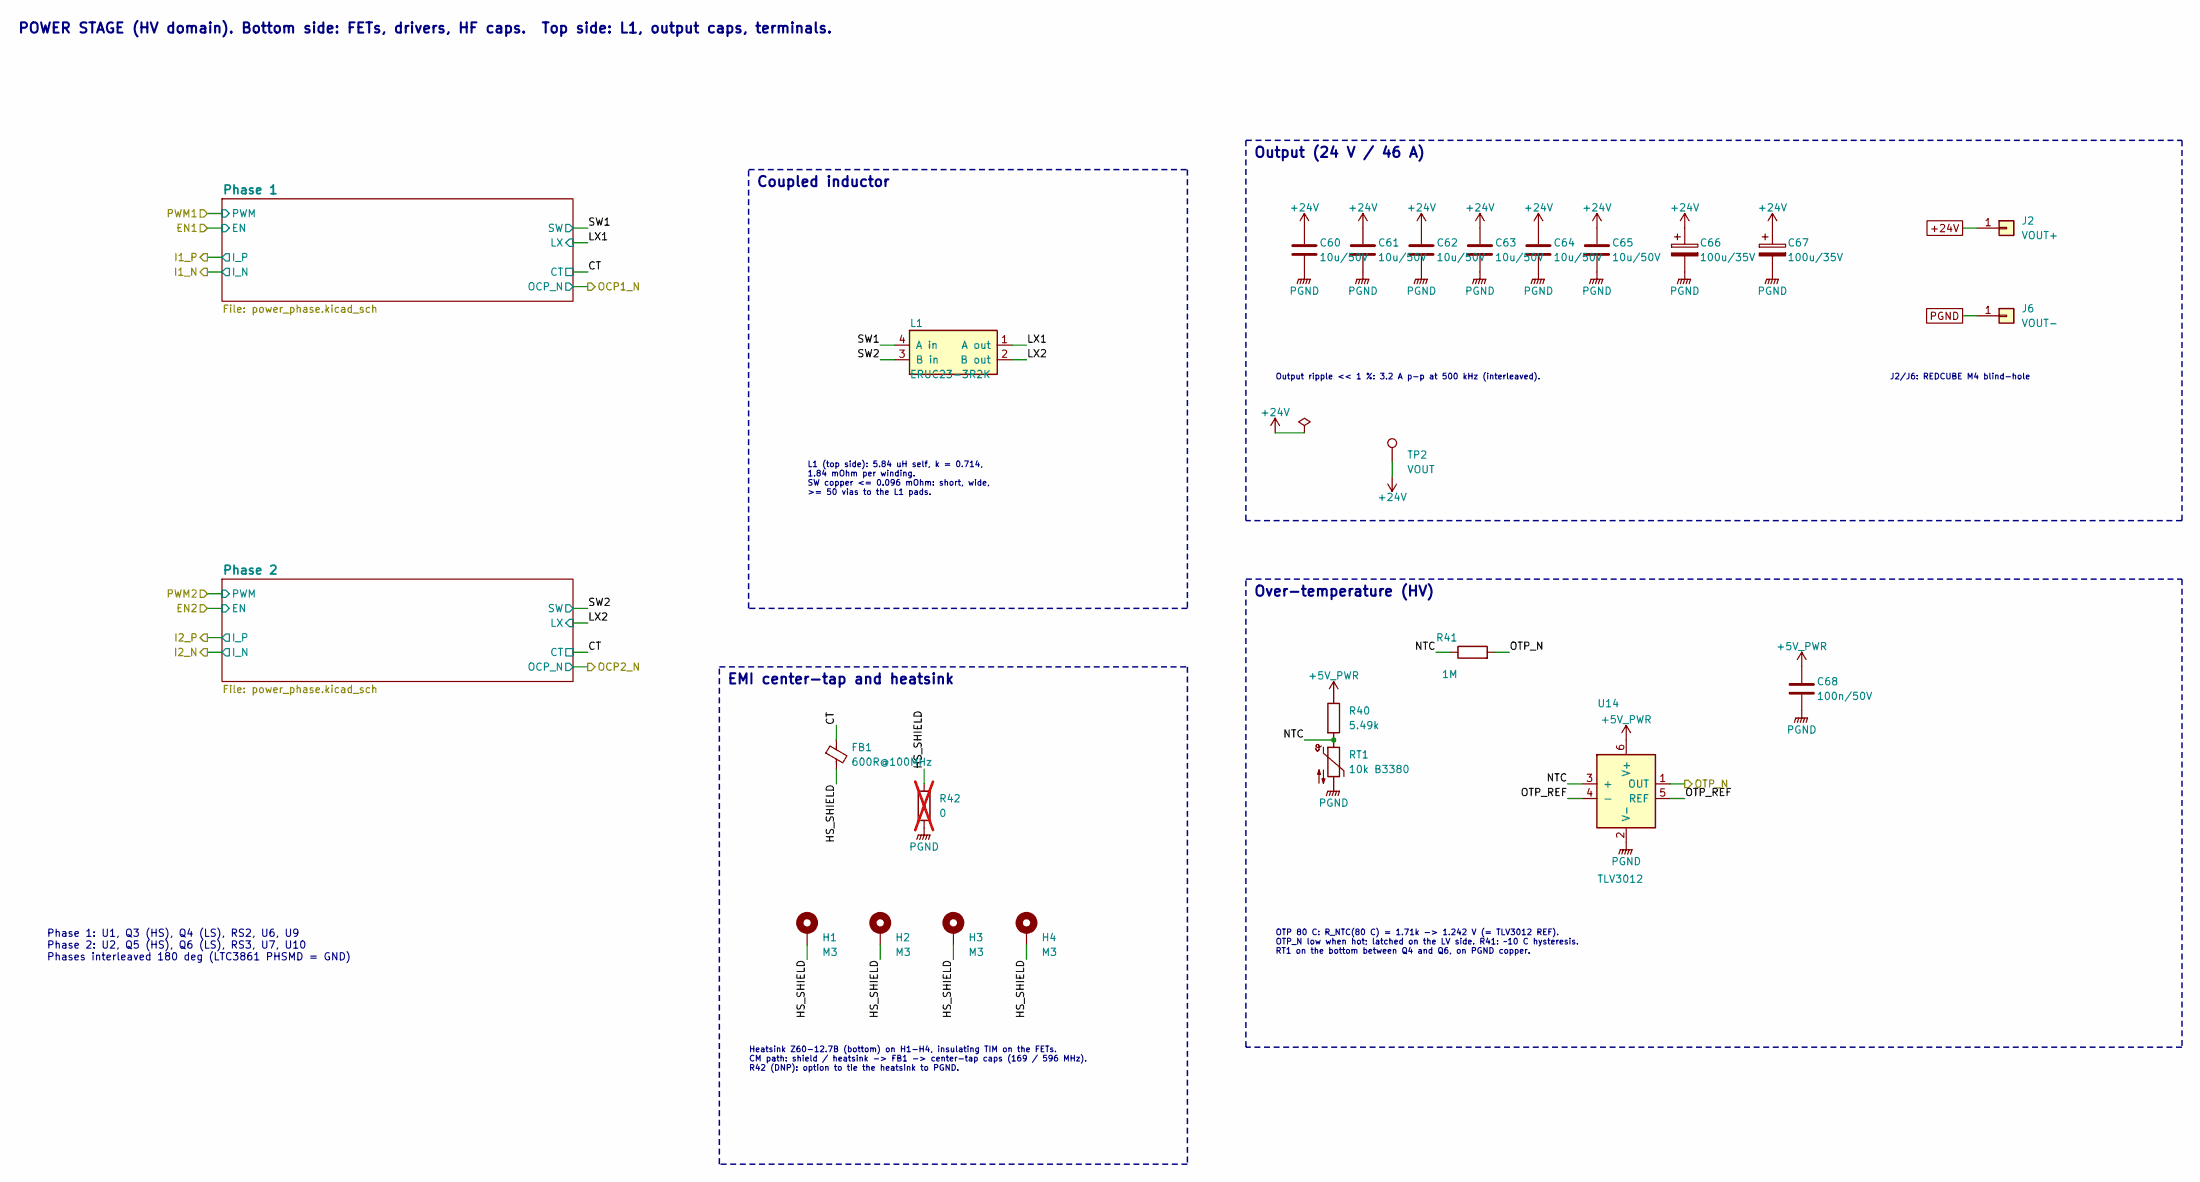
[picture p128: schematic power_stage.kicad_sch, Power stage]

Parts:
C60, C61, C62, C63, C64, C65: 10u/50V; C_1210_3225Metric; MPN GRM32ER71H106KA12L; LCSC C77102
C66, C67: 100u/35V; CP_Elec_8x10.5; MPN EEH-ZA1V101P
C68: 100n/50V; C_0603_1608Metric; MPN GRM188R71H104KA93D; LCSC C77055
FB1: 600R@100MHz; L_0603_1608Metric; MPN BLM18KG601SN1D; LCSC C85833
H1, H2, H3, H4: M3; MountingHole_3.2mm_M3_Pad_Via; MPN M3 plated hole
J2: VOUT+; Wurth_REDCUBE_74650194; MPN 74650194R
J6: VOUT-; Wurth_REDCUBE_74650194; MPN 74650194R
L1: ERUC23-3R2K; TDK_ERUC23; MPN ERUC23-3R2K
R40: 5.49k; R_0603_1608Metric; MPN RC0603FR-075K49L
R41: 1M; R_0603_1608Metric; MPN RC0603FR-071ML
R42: 0; R_0603_1608Metric; MPN RC0603JR-070RL; not fitted
RT1: 10k B3380; R_0603_1608Metric; MPN NCP18XH103F03RB; LCSC C13564
TP2: VOUT; TestPoint_Pad_D1.0mm; MPN Test pad (bare copper)
U14: TLV3012; SOT-23-6; MPN TLV3012AIDBVR; LCSC C62505

Connections:
+5V_PWR: C68.1, R40.1, U14.6 (V+); also elsewhere on the board
+24V: C60.1, C61.1, C62.1, C63.1, C64.1, C65.1, C66.1, C67.1, J2.1, TP2.1; also elsewhere on the board
/OTP_N: R41.2, U14.1 (OUT); also elsewhere on the board
/Power stage (2 phases)/CT: FB1.1; also elsewhere on the board
/Power stage (2 phases)/HS_SHIELD: FB1.2, H1.1, H2.1, H3.1, H4.1, R42.1
/Power stage (2 phases)/LX1: L1.1 (A out); also elsewhere on the board
/Power stage (2 phases)/LX2: L1.2 (B out); also elsewhere on the board
/Power stage (2 phases)/NTC: R40.2, R41.1, RT1.1, U14.3 (+)
/Power stage (2 phases)/OTP_REF: U14.4 (-), U14.5 (REF)
/Power stage (2 phases)/SW1: L1.4 (A in); also elsewhere on the board
/Power stage (2 phases)/SW2: L1.3 (B in); also elsewhere on the board
PGND: C60.2, C61.2, C62.2, C63.2, C64.2, C65.2, C66.2, C67.2, C68.2, J6.1, R42.2, RT1.2, U14.2 (V-); also elsewhere on the board

Notes on the sheet:
POWER STAGE (HV domain). Bottom side: FETs, drivers, HF caps. Top side: L1, output caps, terminals.
Phase 1: U1, Q3 (HS), Q4 (LS), RS2, U6, U9 Phase 2: U2, Q5 (HS), Q6 (LS), RS3, U7, U10 Phases interleaved 180 deg (LTC3861 PHSMD = GND)
L1 (top side): 5.84 uH self, k = 0.714, 1.84 mOhm per winding. SW copper <= 0.096 mOhm: short, wide, >= 50 vias to the L1 pads.
Coupled inductor
Output ripple << 1 %: 3.2 A p-p at 500 kHz (interleaved).
J2/J6: REDCUBE M4 blind-hole
Output (24 V / 46 A)
OTP 80 C: R_NTC(80 C) = 1.71k -> 1.242 V (= TLV3012 REF). OTP_N low when hot; latched on the LV side. R41: ~10 C hysteresis. RT1 on the bottom between Q4 and Q6, on PGND copper.
Over-temperature (HV)
Heatsink Z60-12.7B (bottom) on H1-H4, insulating TIM on the FETs. CM path: shield / heatsink -> FB1 -> center-tap caps (169 / 596 MHz). R42 (DNP): option to tie the heatsink to PGND.
EMI center-tap and heatsink

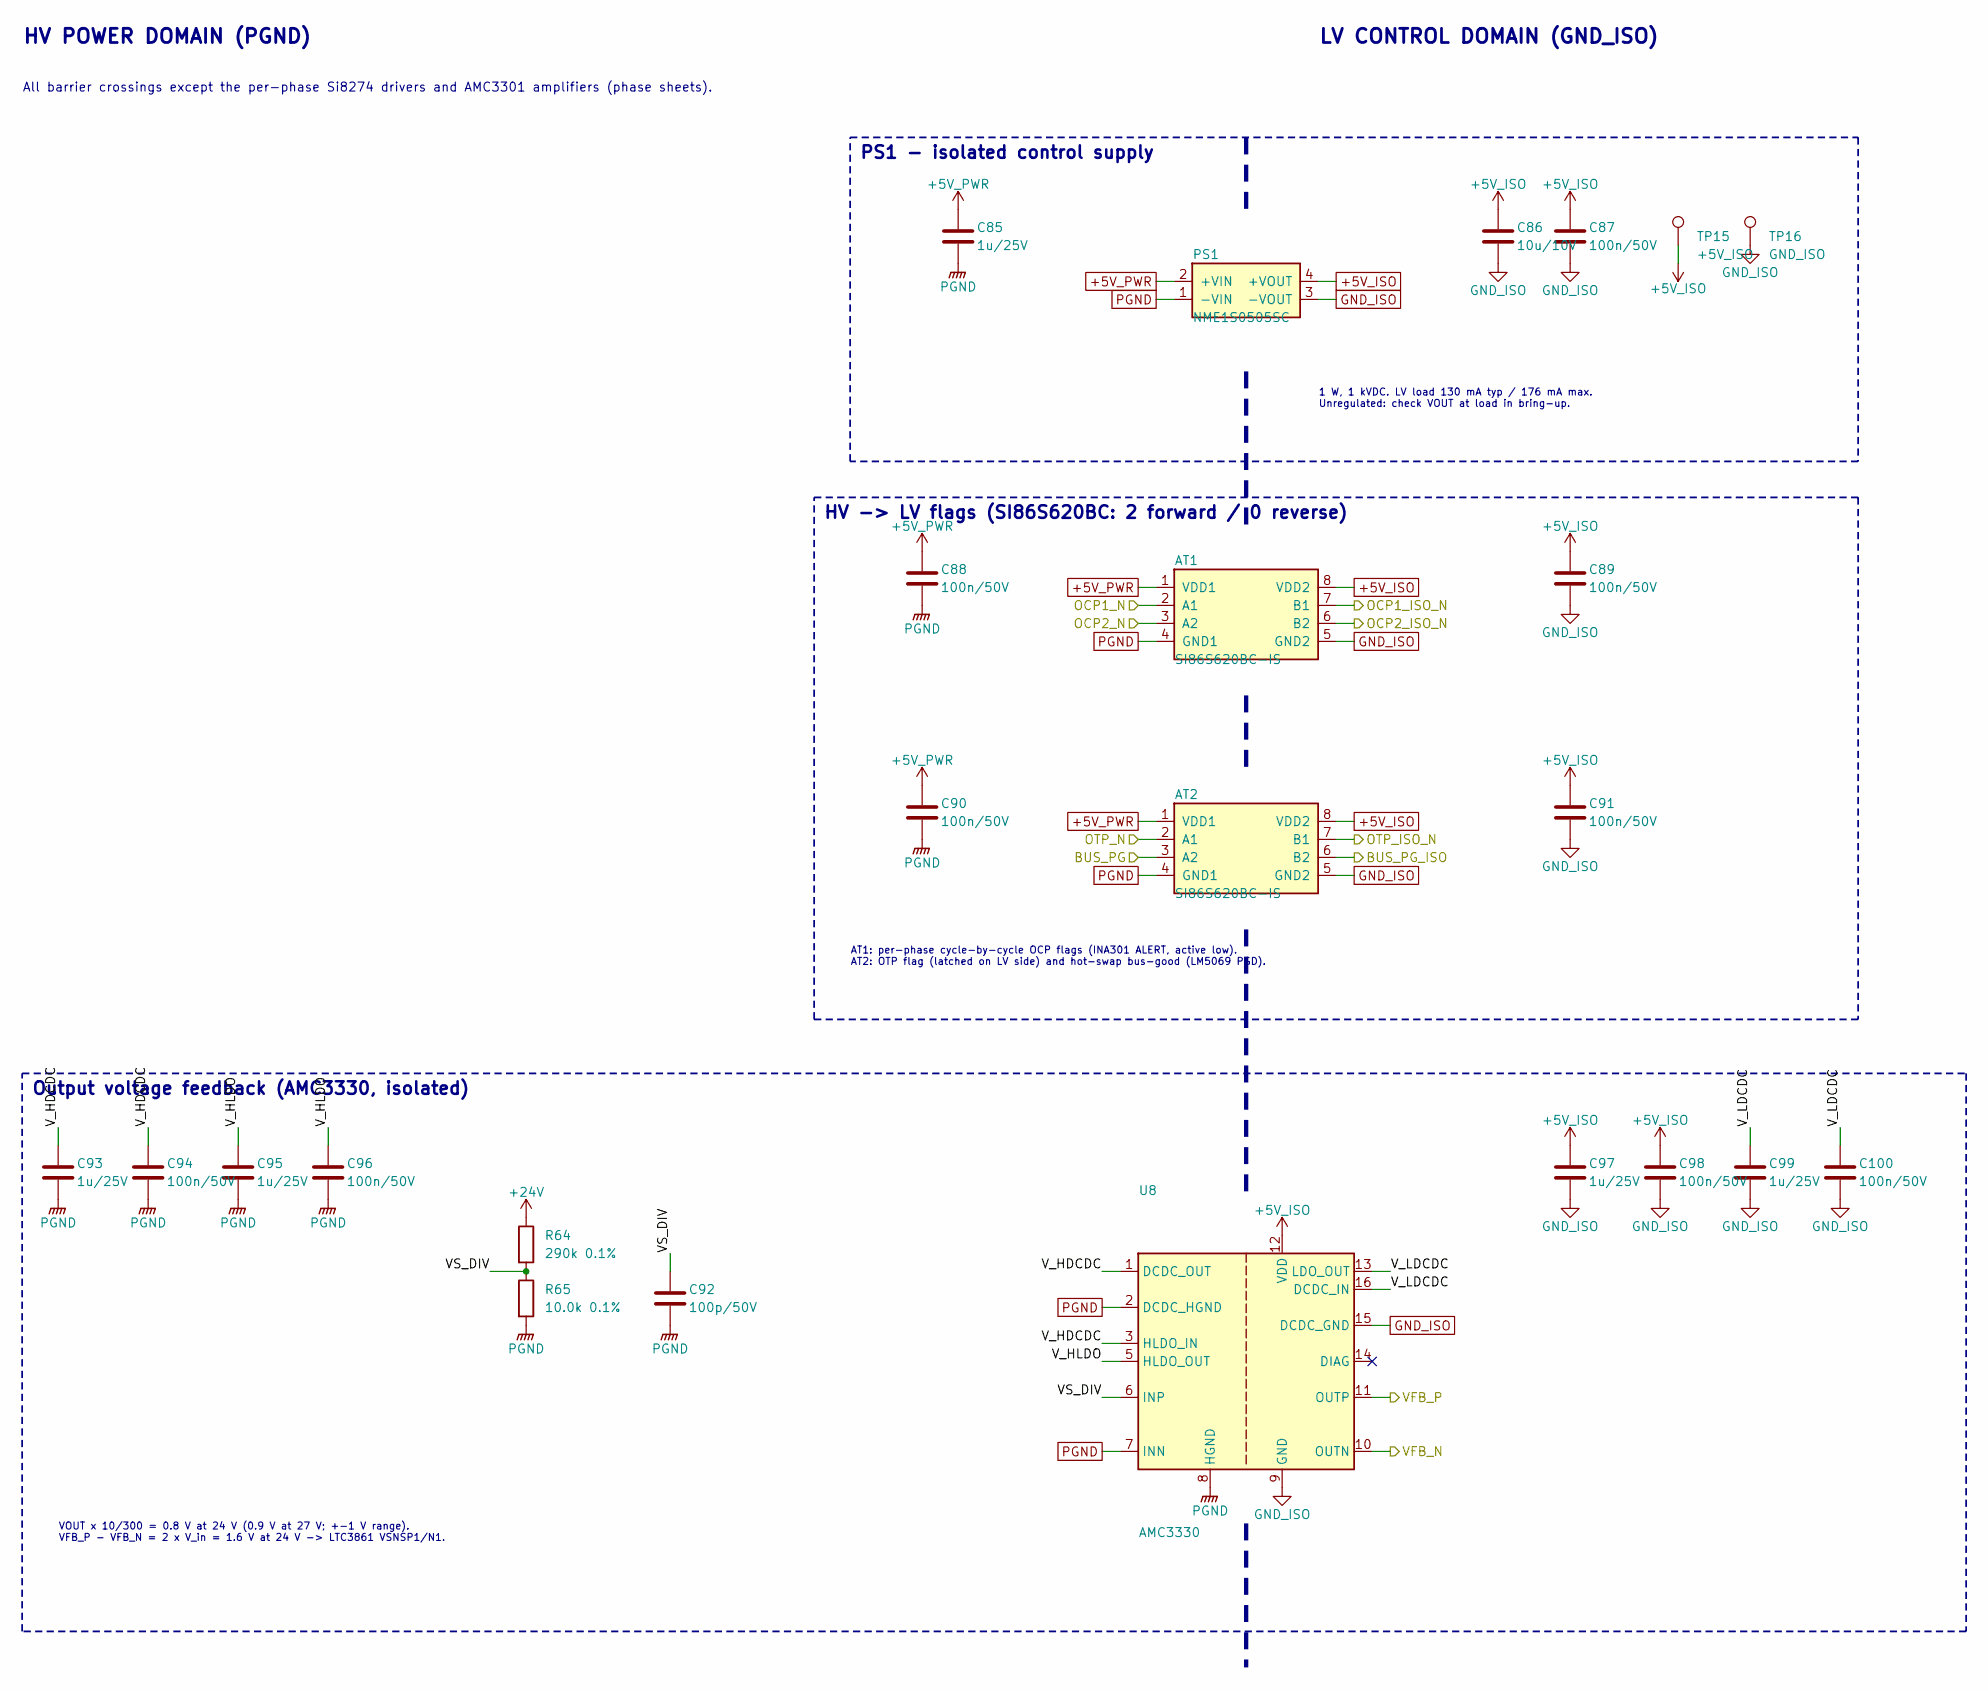
[picture p129: schematic isolation.kicad_sch, Isolation barrier crossings]

Parts:
AT1, AT2: SI86S620BC-IS; SOIC-8_3.9x4.9mm_P1.27mm; MPN SI86S620BC-IS; LCSC C7363570
C85, C93, C95, C97, C99: 1u/25V; C_0603_1608Metric; MPN GRM188R71E105KA12D; LCSC C86020
C86: 10u/10V; C_0805_2012Metric; MPN GRM21BR71A106KE51L; LCSC C86038
C87, C88, C89, C90, C91, C94, C96, C98, C100: 100n/50V; C_0603_1608Metric; MPN GRM188R71H104KA93D; LCSC C77055
C92: 100p/50V; C_0603_1608Metric; MPN GRM1885C1H101JA01D; LCSC C71664
PS1: NME1S0505SC; Murata_NME1S_SIP-4; MPN NME1S0505SC; LCSC C39128444
R64: 290k 0.1%; R_0603_1608Metric; MPN ERA-3AEB2903V
R65: 10.0k 0.1%; R_0603_1608Metric; MPN ERA-3AEB1002V
TP15: +5V_ISO; TestPoint_Pad_D1.0mm; MPN Test pad (bare copper)
TP16: GND_ISO; TestPoint_Pad_D1.0mm; MPN Test pad (bare copper)
U8: AMC3330; SOIC-16W_7.5x10.3mm_P1.27mm; MPN AMC3330DWER; LCSC C2999368

Connections:
+5V_ISO: AT1.8 (VDD2), AT2.8 (VDD2), C86.1, C87.1, C89.1, C91.1, C97.1, C98.1, PS1.4 (+VOUT), TP15.1, U8.12 (VDD); also elsewhere on the board
+5V_PWR: AT1.1 (VDD1), AT2.1 (VDD1), C85.1, C88.1, C90.1, PS1.2 (+VIN); also elsewhere on the board
+24V: R64.1; also elsewhere on the board
/BUS_PG: AT2.3 (A2); also elsewhere on the board
/BUS_PG_ISO: AT2.6 (B2); also elsewhere on the board
/Isolation barrier/VS_DIV: C92.1, R64.2, R65.1, U8.6 (INP)
/Isolation barrier/V_HDCDC: C93.1, C94.1, U8.1 (DCDC_OUT), U8.3 (HLDO_IN)
/Isolation barrier/V_HLDO: C95.1, C96.1, U8.5 (HLDO_OUT)
/Isolation barrier/V_LDCDC: C99.1, C100.1, U8.13 (LDO_OUT), U8.16 (DCDC_IN)
/OCP1_ISO_N: AT1.7 (B1); also elsewhere on the board
/OCP1_N: AT1.2 (A1); also elsewhere on the board
/OCP2_ISO_N: AT1.6 (B2); also elsewhere on the board
/OCP2_N: AT1.3 (A2); also elsewhere on the board
/OTP_ISO_N: AT2.7 (B1); also elsewhere on the board
/OTP_N: AT2.2 (A1); also elsewhere on the board
/VFB_N: U8.10 (OUTN); also elsewhere on the board
/VFB_P: U8.11 (OUTP); also elsewhere on the board
GND_ISO: AT1.5 (GND2), AT2.5 (GND2), C86.2, C87.2, C89.2, C91.2, C97.2, C98.2, C99.2, C100.2, PS1.3 (-VOUT), TP16.1, U8.9 (GND), U8.15 (DCDC_GND); also elsewhere on the board
PGND: AT1.4 (GND1), AT2.4 (GND1), C85.2, C88.2, C90.2, C92.2, C93.2, C94.2, C95.2, C96.2, PS1.1 (-VIN), R65.2, U8.2 (DCDC_HGND), U8.7 (INN), U8.8 (HGND); also elsewhere on the board

Notes on the sheet:
HV POWER DOMAIN (PGND)
LV CONTROL DOMAIN (GND_ISO)
All barrier crossings except the per-phase Si8274 drivers and AMC3301 amplifiers (phase sheets).
1 W, 1 kVDC. LV load 130 mA typ / 176 mA max. Unregulated: check VOUT at load in bring-up.
PS1 - isolated control supply
AT1: per-phase cycle-by-cycle OCP flags (INA301 ALERT, active low). AT2: OTP flag (latched on LV side) and hot-swap bus-good (LM5069 PGD).
HV -> LV flags (SI86S620BC: 2 forward / 0 reverse)
VOUT x 10/300 = 0.8 V at 24 V (0.9 V at 27 V; +-1 V range). VFB_P - VFB_N = 2 x V_in = 1.6 V at 24 V -> LTC3861 VSNSP1/N1.
Output voltage feedback (AMC3330, isolated)

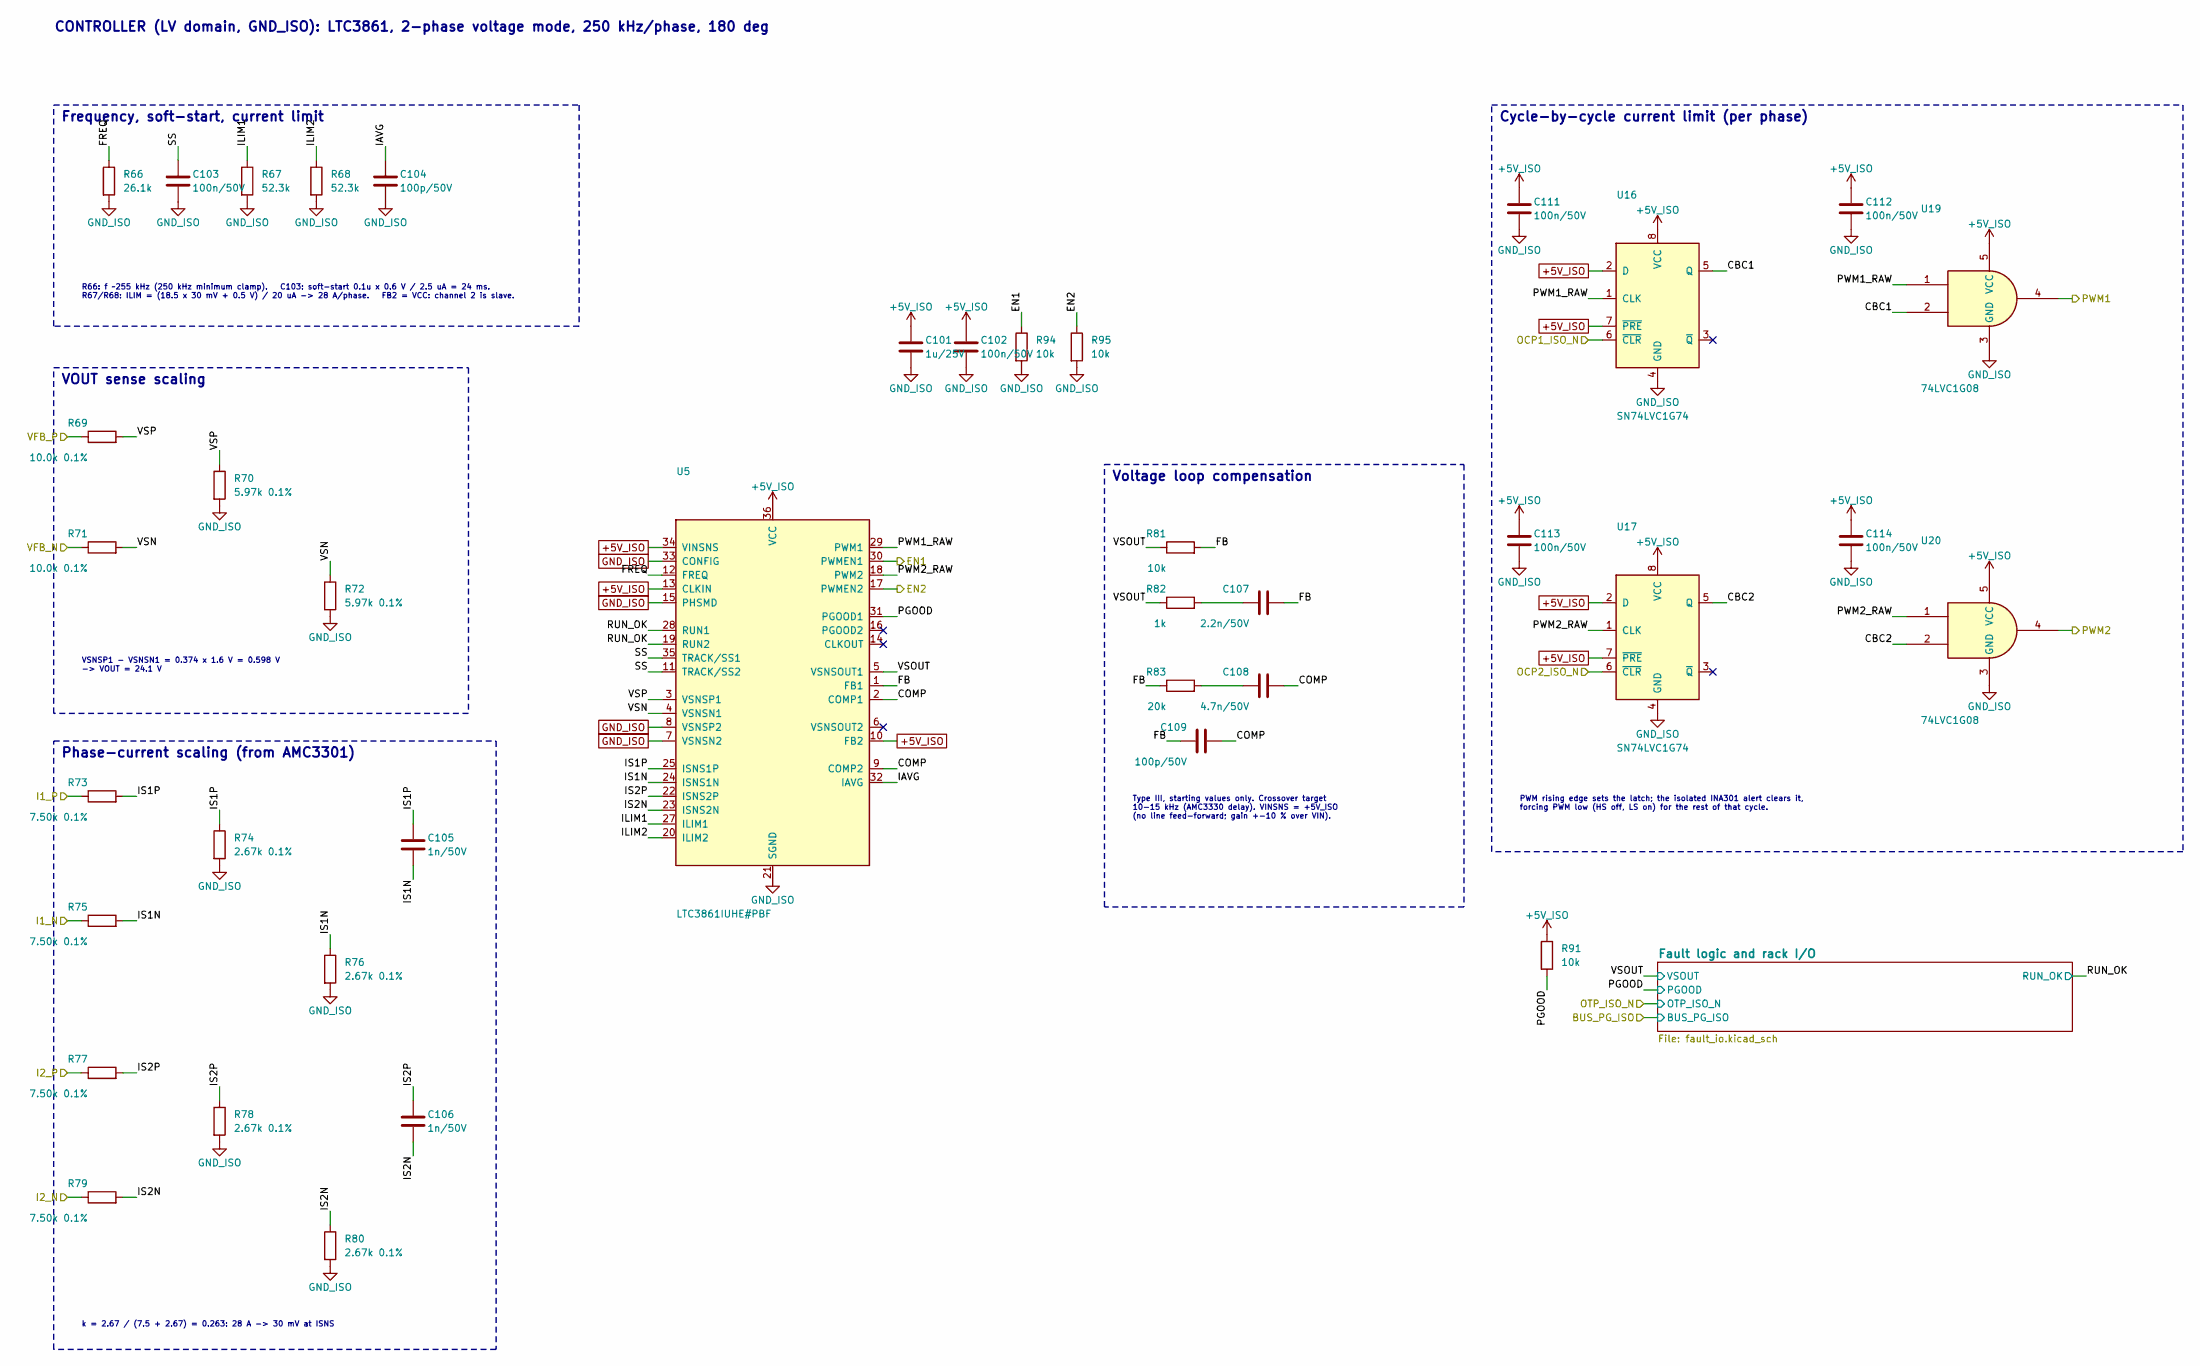
[picture p130: schematic controller.kicad_sch, Controller (LV)]

Parts:
C101: 1u/25V; C_0603_1608Metric; MPN GRM188R71E105KA12D; LCSC C86020
C102, C103, C111, C112, C113, C114: 100n/50V; C_0603_1608Metric; MPN GRM188R71H104KA93D; LCSC C77055
C104, C109: 100p/50V; C_0603_1608Metric; MPN GRM1885C1H101JA01D; LCSC C71664
C105, C106: 1n/50V; C_0603_1608Metric; MPN GRM1885C1H102JA01D; LCSC C77026
C107: 2.2n/50V; C_0603_1608Metric; MPN GRM188R71H222KA01D; LCSC C86023
C108: 4.7n/50V; C_0603_1608Metric; MPN GRM188R71H472KA01D; LCSC C77057
R66: 26.1k; R_0603_1608Metric; MPN RC0603FR-0726K1L
R67, R68: 52.3k; R_0603_1608Metric; MPN RC0603FR-0752K3L
R69, R71: 10.0k 0.1%; R_0603_1608Metric; MPN ERA-3AEB1002V
R70, R72: 5.97k 0.1%; R_0603_1608Metric; MPN ERA-3AEB5971V
R73, R75, R77, R79: 7.50k 0.1%; R_0603_1608Metric; MPN ERA-3AEB7501V
R74, R76, R78, R80: 2.67k 0.1%; R_0603_1608Metric; MPN ERA-3AEB2671V
R81, R91, R94, R95: 10k; R_0603_1608Metric; MPN RC0603FR-0710KL
R82: 1k; R_0603_1608Metric; MPN RC0603FR-071KL
R83: 20k; R_0603_1608Metric; MPN RC0603FR-0720KL
U5: LTC3861IUHE#PBF; QFN-36-1EP_5x6mm_P0.5mm_EP3.6x4.1mm; MPN LTC3861IUHE#PBF; LCSC C686466
U16, U17: SN74LVC1G74; SSOP-8_2.95x2.8mm_P0.65mm; MPN SN74LVC1G74DCTR; LCSC C840104
U19, U20: 74LVC1G08; SOT-23-5; MPN SN74LVC1G08DBVR; LCSC C7666

Connections:
+5V_ISO: C101.1, C102.1, C111.1, C112.1, C113.1, C114.1, R91.1, U5.10 (FB2), U5.13 (CLKIN), U5.34 (VINSNS), U5.36 (VCC), U16.2 (D), U16.7 (~PRE), U16.8 (VCC), U17.2 (D), U17.7 (~PRE), U17.8 (VCC), U19.5 (VCC), U20.5 (VCC); also elsewhere on the board
/Controller (LV)/CBC1: U16.5 (Q), U19.2
/Controller (LV)/CBC2: U17.5 (Q), U20.2
/Controller (LV)/COMP: C108.2, C109.2, U5.2 (COMP1), U5.9 (COMP2)
/Controller (LV)/FB: C107.2, C109.1, R81.2, R83.1, U5.1 (FB1)
/Controller (LV)/FREQ: R66.1, U5.12 (FREQ)
/Controller (LV)/IAVG: C104.1, U5.32 (IAVG)
/Controller (LV)/ILIM1: R67.1, U5.27 (ILIM1)
/Controller (LV)/ILIM2: R68.1, U5.20 (ILIM2)
/Controller (LV)/IS1N: C105.2, R75.2, R76.1, U5.24 (ISNS1N)
/Controller (LV)/IS1P: C105.1, R73.2, R74.1, U5.25 (ISNS1P)
/Controller (LV)/IS2N: C106.2, R79.2, R80.1, U5.23 (ISNS2N)
/Controller (LV)/IS2P: C106.1, R77.2, R78.1, U5.22 (ISNS2P)
/Controller (LV)/PGOOD: R91.2, U5.31 (PGOOD1); also elsewhere on the board
/Controller (LV)/PWM1_RAW: U5.29 (PWM1), U16.1 (CLK), U19.1
/Controller (LV)/PWM2_RAW: U5.18 (PWM2), U17.1 (CLK), U20.1
/Controller (LV)/RUN_OK: U5.19 (RUN2), U5.28 (RUN1); also elsewhere on the board
/Controller (LV)/SS: C103.1, U5.11 (TRACK/SS2), U5.35 (TRACK/SS1)
/Controller (LV)/VSN: R71.2, R72.1, U5.4 (VSNSN1)
/Controller (LV)/VSOUT: R81.1, R82.1, U5.5 (VSNSOUT1); also elsewhere on the board
/Controller (LV)/VSP: R69.2, R70.1, U5.3 (VSNSP1)
/EN1: R94.1, U5.30 (PWMEN1); also elsewhere on the board
/EN2: R95.1, U5.17 (PWMEN2); also elsewhere on the board
/I1_N: R75.1; also elsewhere on the board
/I1_P: R73.1; also elsewhere on the board
/I2_N: R79.1; also elsewhere on the board
/I2_P: R77.1; also elsewhere on the board
/OCP1_ISO_N: U16.6 (~CLR); also elsewhere on the board
/OCP2_ISO_N: U17.6 (~CLR); also elsewhere on the board
/PWM1: U19.4; also elsewhere on the board
/PWM2: U20.4; also elsewhere on the board
/VFB_N: R71.1; also elsewhere on the board
/VFB_P: R69.1; also elsewhere on the board
GND_ISO: C101.2, C102.2, C103.2, C104.2, C111.2, C112.2, C113.2, C114.2, R66.2, R67.2, R68.2, R70.2, R72.2, R74.2, R76.2, R78.2, R80.2, R94.2, R95.2, U5.7 (VSNSN2), U5.8 (VSNSP2), U5.15 (PHSMD), U5.21 (SGND), U5.26 (SGND), U5.33 (CONFIG), U5.37 (SGND), U16.4 (GND), U17.4 (GND), U19.3 (GND), U20.3 (GND); also elsewhere on the board
unnamed: C107.1, R82.2
unnamed: C108.1, R83.2

Notes on the sheet:
CONTROLLER (LV domain, GND_ISO): LTC3861, 2-phase voltage mode, 250 kHz/phase, 180 deg
R66: f ~255 kHz (250 kHz minimum clamp). C103: soft-start 0.1u x 0.6 V / 2.5 uA = 24 ms. R67/R68: ILIM = (18.5 x 30 mV + 0.5 V) / 20 uA -> 28 A/phase. FB2 = VCC: channel 2 is slave.
Frequency, soft-start, current limit
VSNSP1 - VSNSN1 = 0.374 x 1.6 V = 0.598 V -> VOUT = 24.1 V
VOUT sense scaling
k = 2.67 / (7.5 + 2.67) = 0.263: 28 A -> 30 mV at ISNS
Phase-current scaling (from AMC3301)
Type III, starting values only. Crossover target 10-15 kHz (AMC3330 delay). VINSNS = +5V_ISO (no line feed-forward; gain +-10 % over VIN).
Voltage loop compensation
PWM rising edge sets the latch; the isolated INA301 alert clears it, forcing PWM low (HS off, LS on) for the rest of that cycle.
Cycle-by-cycle current limit (per phase)
