tsshendo/2-Phase-interleaved-buck-converter/kicad/ECE533_Guide/ECE533_Guide.kicad_pcb

## KiCad design kicad/ECE533_Guide/ECE533_Guide.kicad_pcb (continued)

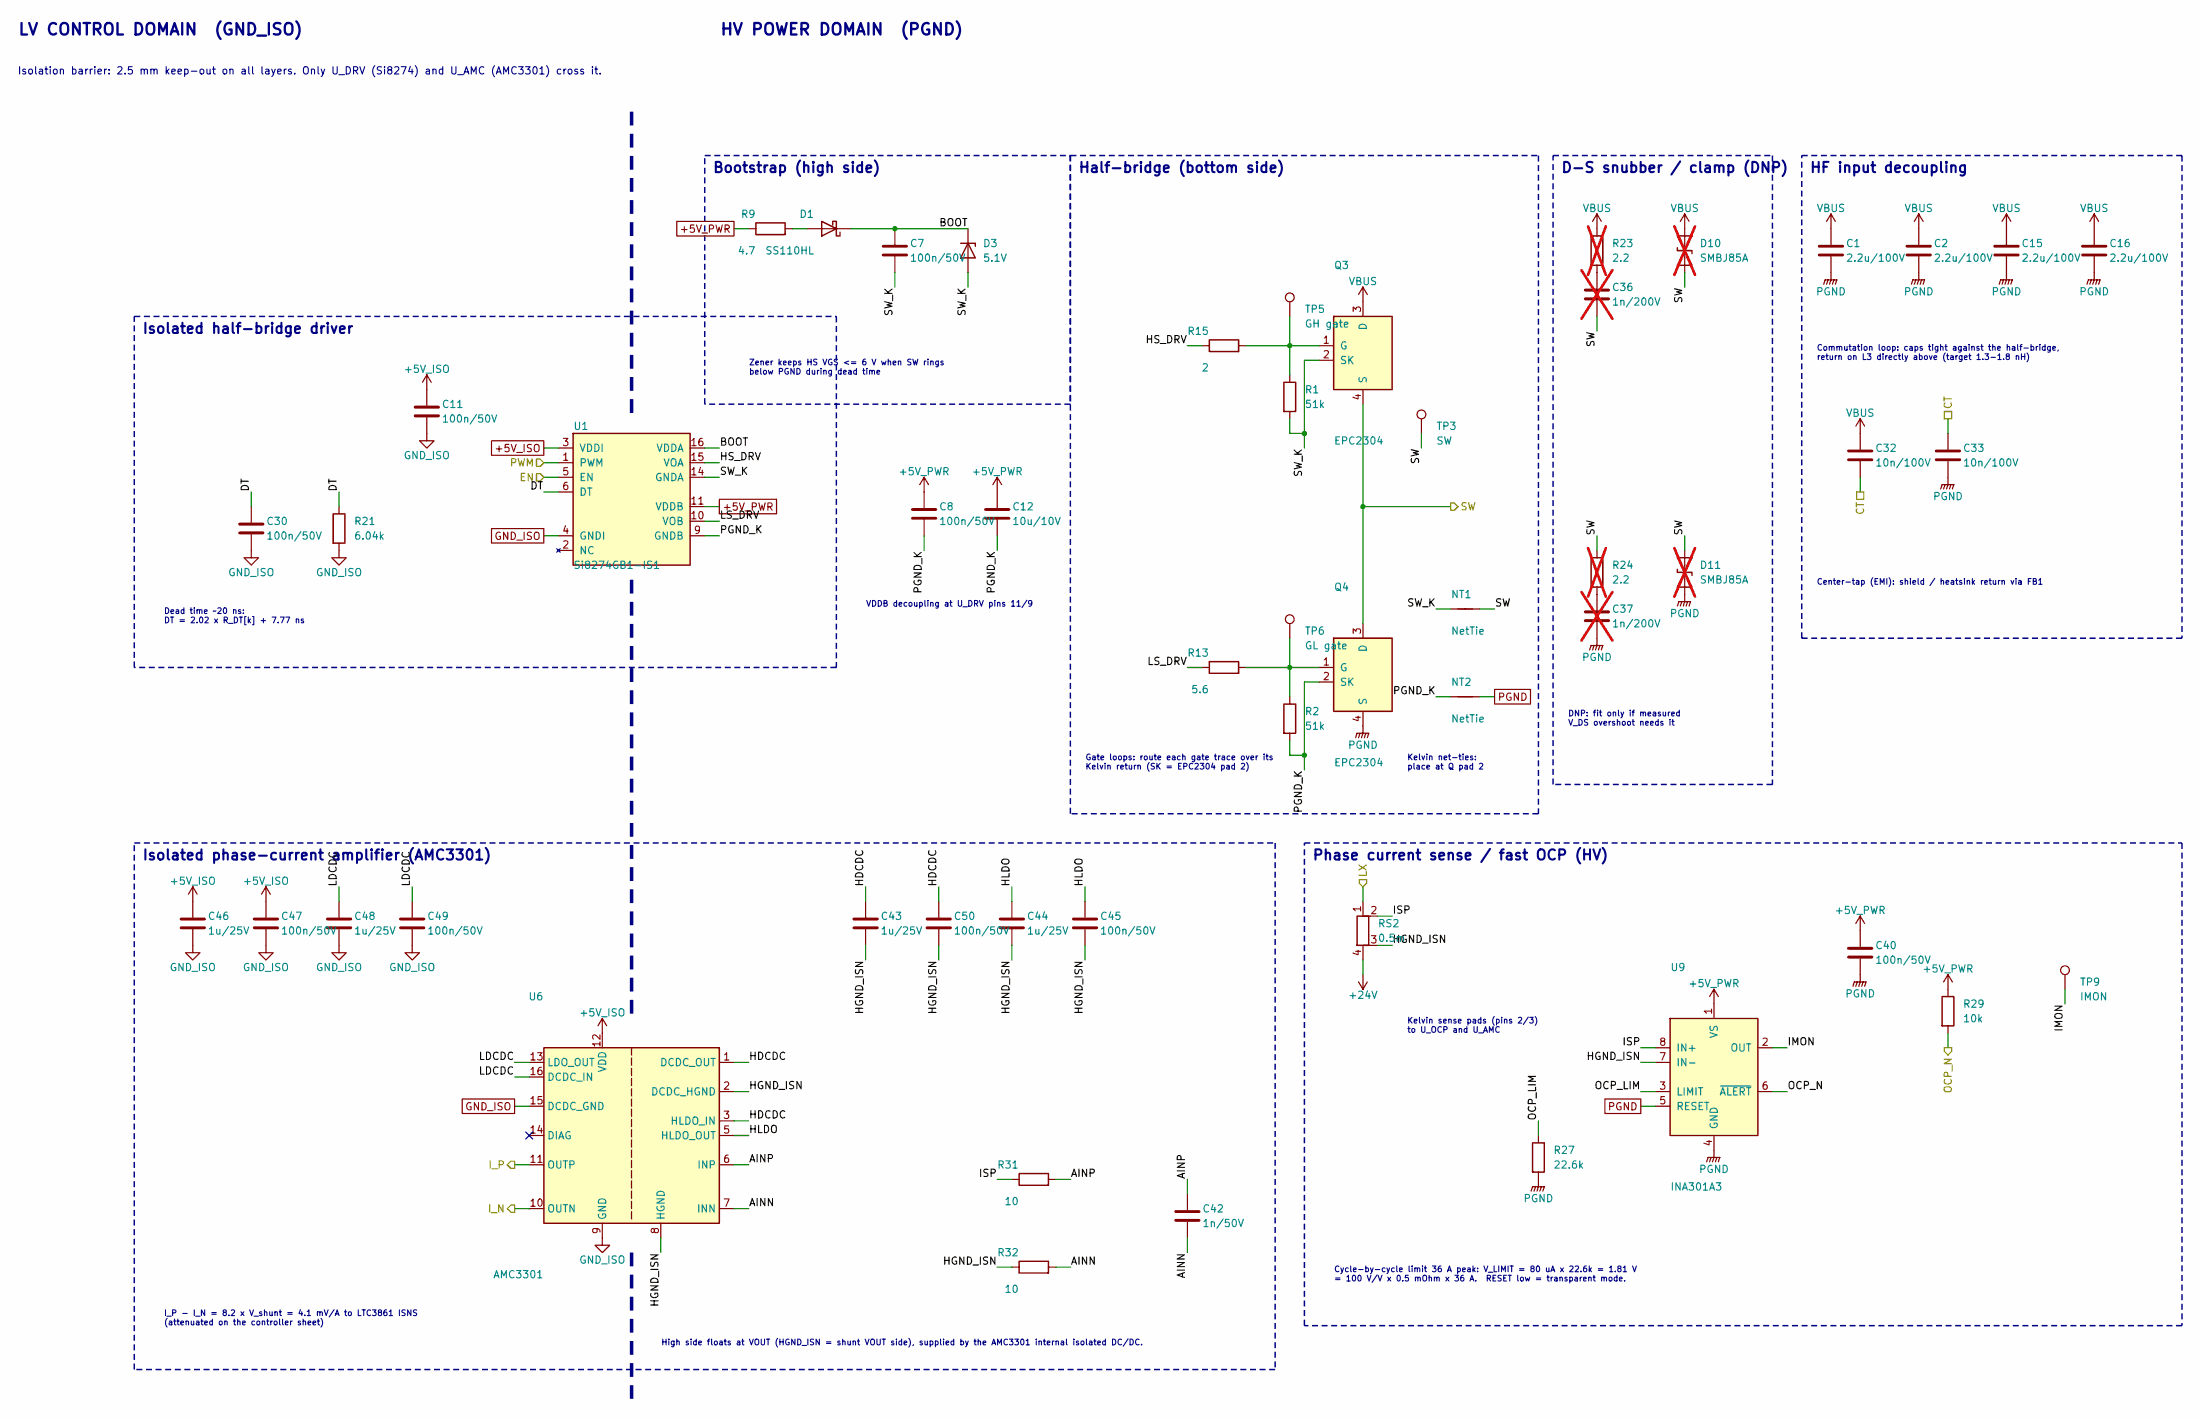
[picture p131: schematic power_phase.kicad_sch, Power phase (one instance per phase)]

Parts:
C1, C2, C15, C16: 2.2u/100V; C_0805_2012Metric; MPN GRM21BD72A225KE01L; LCSC C2981733
C7, C8, C11, C30, C40, C45, C47, C49, C50: 100n/50V; C_0603_1608Metric; MPN GRM188R71H104KA93D; LCSC C77055
C12: 10u/10V; C_0805_2012Metric; MPN GRM21BR71A106KE51L; LCSC C86038
C32, C33: 10n/100V; C_0603_1608Metric; MPN GRM188R72A103KA01D; LCSC C162275
C36, C37: 1n/200V; C_0805_2012Metric; MPN C0805C102J2GAC7800; LCSC C2170811; not fitted
C42: 1n/50V; C_0603_1608Metric; MPN GRM1885C1H102JA01D; LCSC C77026
C43, C44, C46, C48: 1u/25V; C_0603_1608Metric; MPN GRM188R71E105KA12D; LCSC C86020
D1: SS110HL; D_SOD-123F; MPN SS110HL-TP; LCSC C19996385
D3: 5.1V; D_SOD-123; MPN BZT52C5V1-TP; LCSC C78728
D10, D11: SMBJ85A; D_SMB; MPN SMBJ85A; not fitted
NT1, NT2: NetTie; NetTie-2_SMD_Pad0.5mm; MPN NetTie
Q3, Q4: EPC2304; EPC2304_QFN-7_3x5mm; MPN EPC2304; LCSC C6549215
R1, R2: 51k; R_0603_1608Metric; MPN RC0603FR-0751KL
R9: 4.7; R_0603_1608Metric; MPN RC0603FR-074R7L
R13: 5.6; R_0603_1608Metric; MPN RC0603FR-075R6L
R15: 2; R_0603_1608Metric; MPN RC0603FR-072RL
R21: 6.04k; R_0603_1608Metric; MPN RC0603FR-076K04L
R23, R24: 2.2; R_1206_3216Metric; MPN RC1206FR-072R2L; not fitted
R27: 22.6k; R_0603_1608Metric; MPN RC0603FR-0722K6L
R29: 10k; R_0603_1608Metric; MPN RC0603FR-0710KL
R31, R32: 10; R_0603_1608Metric; MPN RC0603FR-0710RL
RS2: 0.5m; R_2512_Kelvin; MPN CSS2H-2512R-L500F; LCSC C2073667
TP3: SW; TestPoint_Pad_D1.0mm; MPN Test pad (bare copper)
TP5: GH gate; TestPoint_Pad_D1.0mm; MPN Test pad (bare copper)
TP6: GL gate; TestPoint_Pad_D1.0mm; MPN Test pad (bare copper)
TP9: IMON; TestPoint_Pad_D1.0mm; MPN Test pad (bare copper)
U1: Si8274GB1-IS1; SOIC-16_3.9x9.9mm_P1.27mm; MPN Si8274GB1-IS1; LCSC C17368638
U6: AMC3301; SOIC-16W_7.5x10.3mm_P1.27mm; MPN AMC3301DWER; LCSC C2869778
U9: INA301A3; VSSOP-8_3x3mm_P0.65mm; MPN INA301A3IDGKR; LCSC C2861552

Connections:
+5V_ISO: C11.1, C46.1, C47.1, U1.3 (VDDI), U1.8 (VDDI), U6.12 (VDD); also elsewhere on the board
+5V_PWR: C8.1, C12.1, C40.1, R9.1, R29.1, U1.11 (VDDB), U9.1 (VS); also elsewhere on the board
+24V: RS2.4; also elsewhere on the board
/EN1: U1.5 (EN); also elsewhere on the board
/I1_N: U6.10 (OUTN); also elsewhere on the board
/I1_P: U6.11 (OUTP); also elsewhere on the board
/OCP1_N: R29.2, U9.6 (~ALERT); also elsewhere on the board
/PWM1: U1.1 (PWM); also elsewhere on the board
/Power stage (2 phases)/CT: C32.2, C33.1; also elsewhere on the board
/Power stage (2 phases)/LX1: RS2.1; also elsewhere on the board
/Power stage (2 phases)/Phase 1/AINN: C42.2, R32.2, U6.7 (INN)
/Power stage (2 phases)/Phase 1/AINP: C42.1, R31.2, U6.6 (INP)
/Power stage (2 phases)/Phase 1/BOOT: C7.1, D1.1 (K), D3.1 (K), U1.16 (VDDA)
/Power stage (2 phases)/Phase 1/DT: C30.1, R21.1, U1.6 (DT)
/Power stage (2 phases)/Phase 1/HDCDC: C43.1, C50.1, U6.1 (DCDC_OUT), U6.3 (HLDO_IN)
/Power stage (2 phases)/Phase 1/HGND_ISN: C43.2, C44.2, C45.2, C50.2, R32.1, RS2.3, U6.2 (DCDC_HGND), U6.8 (HGND), U9.7 (IN-)
/Power stage (2 phases)/Phase 1/HLDO: C44.1, C45.1, U6.5 (HLDO_OUT)
/Power stage (2 phases)/Phase 1/HS_DRV: R15.1, U1.15 (VOA)
/Power stage (2 phases)/Phase 1/IMON: TP9.1, U9.2 (OUT)
/Power stage (2 phases)/Phase 1/ISP: R31.1, RS2.2, U9.8 (IN+)
/Power stage (2 phases)/Phase 1/LDCDC: C48.1, C49.1, U6.13 (LDO_OUT), U6.16 (DCDC_IN)
/Power stage (2 phases)/Phase 1/LS_DRV: R13.1, U1.10 (VOB)
/Power stage (2 phases)/Phase 1/OCP_LIM: R27.1, U9.3 (LIMIT)
/Power stage (2 phases)/Phase 1/PGND_K: C8.2, C12.2, NT2.1, Q4.2 (SK), R2.2, U1.9 (GNDB)
/Power stage (2 phases)/Phase 1/SW_K: C7.2, D3.2 (A), NT1.1, Q3.2 (SK), R1.2, U1.14 (GNDA)
/Power stage (2 phases)/SW1: C36.2, D10.2 (A2), D11.1 (A1), NT1.2, Q3.4 (S), Q3.6 (S), Q4.3 (D), Q4.5 (D), Q4.7 (D), R24.1, TP3.1; also elsewhere on the board
GND_ISO: C11.2, C30.2, C46.2, C47.2, C48.2, C49.2, R21.2, U1.4 (GNDI), U6.9 (GND), U6.15 (DCDC_GND); also elsewhere on the board
unnamed: C36.1, R23.2
unnamed: C37.1, R24.2
unnamed: D1.2 (A), R9.2
unnamed: Q3.1 (G), R1.1, R15.2, TP5.1
unnamed: Q4.1 (G), R2.1, R13.2, TP6.1
PGND: C1.2, C2.2, C15.2, C16.2, C33.2, C37.2, C40.2, D11.2 (A2), NT2.2, Q4.4 (S), Q4.6 (S), R27.2, U9.4 (GND), U9.5 (RESET); also elsewhere on the board
VBUS: C1.1, C2.1, C15.1, C16.1, C32.1, D10.1 (A1), Q3.3 (D), Q3.5 (D), Q3.7 (D), R23.1; also elsewhere on the board

Parts of its further copies:
C3, C4, C17, C18: 2.2u/100V; C_0805_2012Metric; MPN GRM21BD72A225KE01L; LCSC C2981733
C9, C10, C13, C31, C41, C54, C56, C58, C59: 100n/50V; C_0603_1608Metric; MPN GRM188R71H104KA93D; LCSC C77055
C14: 10u/10V; C_0805_2012Metric; MPN GRM21BR71A106KE51L; LCSC C86038
C34, C35: 10n/100V; C_0603_1608Metric; MPN GRM188R72A103KA01D; LCSC C162275
C38, C39: 1n/200V; C_0805_2012Metric; MPN C0805C102J2GAC7800; LCSC C2170811; not fitted
C51: 1n/50V; C_0603_1608Metric; MPN GRM1885C1H102JA01D; LCSC C77026
C52, C53, C55, C57: 1u/25V; C_0603_1608Metric; MPN GRM188R71E105KA12D; LCSC C86020
D2: SS110HL; D_SOD-123F; MPN SS110HL-TP; LCSC C19996385
D4: 5.1V; D_SOD-123; MPN BZT52C5V1-TP; LCSC C78728
D12, D13: SMBJ85A; D_SMB; MPN SMBJ85A; not fitted
NT3, NT4: NetTie; NetTie-2_SMD_Pad0.5mm; MPN NetTie
Q5, Q6: EPC2304; EPC2304_QFN-7_3x5mm; MPN EPC2304; LCSC C6549215
R3, R4: 51k; R_0603_1608Metric; MPN RC0603FR-0751KL
R10: 4.7; R_0603_1608Metric; MPN RC0603FR-074R7L
R14: 5.6; R_0603_1608Metric; MPN RC0603FR-075R6L
R16: 2; R_0603_1608Metric; MPN RC0603FR-072RL
R22: 6.04k; R_0603_1608Metric; MPN RC0603FR-076K04L
R25, R26: 2.2; R_1206_3216Metric; MPN RC1206FR-072R2L; not fitted
R28: 22.6k; R_0603_1608Metric; MPN RC0603FR-0722K6L
R30: 10k; R_0603_1608Metric; MPN RC0603FR-0710KL
R33, R34: 10; R_0603_1608Metric; MPN RC0603FR-0710RL
RS3: 0.5m; R_2512_Kelvin; MPN CSS2H-2512R-L500F; LCSC C2073667
TP4: SW; TestPoint_Pad_D1.0mm; MPN Test pad (bare copper)
TP7: GH gate; TestPoint_Pad_D1.0mm; MPN Test pad (bare copper)
TP8: GL gate; TestPoint_Pad_D1.0mm; MPN Test pad (bare copper)
TP10: IMON; TestPoint_Pad_D1.0mm; MPN Test pad (bare copper)
U2: Si8274GB1-IS1; SOIC-16_3.9x9.9mm_P1.27mm; MPN Si8274GB1-IS1; LCSC C17368638
U7: AMC3301; SOIC-16W_7.5x10.3mm_P1.27mm; MPN AMC3301DWER; LCSC C2869778
U10: INA301A3; VSSOP-8_3x3mm_P0.65mm; MPN INA301A3IDGKR; LCSC C2861552

Connections of its further copies:
+5V_ISO: C13.1, C55.1, C56.1, U2.3 (VDDI), U2.8 (VDDI), U7.12 (VDD); also elsewhere on the board
+5V_PWR: C10.1, C14.1, C41.1, R10.1, R30.1, U2.11 (VDDB), U10.1 (VS); also elsewhere on the board
+24V: RS3.4; also elsewhere on the board
/EN2: U2.5 (EN); also elsewhere on the board
/I2_N: U7.10 (OUTN); also elsewhere on the board
/I2_P: U7.11 (OUTP); also elsewhere on the board
/OCP2_N: R30.2, U10.6 (~ALERT); also elsewhere on the board
/PWM2: U2.1 (PWM); also elsewhere on the board
/Power stage (2 phases)/CT: C34.2, C35.1; also elsewhere on the board
/Power stage (2 phases)/LX2: RS3.1; also elsewhere on the board
/Power stage (2 phases)/Phase 2/AINN: C51.2, R34.2, U7.7 (INN)
/Power stage (2 phases)/Phase 2/AINP: C51.1, R33.2, U7.6 (INP)
/Power stage (2 phases)/Phase 2/BOOT: C9.1, D2.1 (K), D4.1 (K), U2.16 (VDDA)
/Power stage (2 phases)/Phase 2/DT: C31.1, R22.1, U2.6 (DT)
/Power stage (2 phases)/Phase 2/HDCDC: C52.1, C59.1, U7.1 (DCDC_OUT), U7.3 (HLDO_IN)
/Power stage (2 phases)/Phase 2/HGND_ISN: C52.2, C53.2, C54.2, C59.2, R34.1, RS3.3, U7.2 (DCDC_HGND), U7.8 (HGND), U10.7 (IN-)
/Power stage (2 phases)/Phase 2/HLDO: C53.1, C54.1, U7.5 (HLDO_OUT)
/Power stage (2 phases)/Phase 2/HS_DRV: R16.1, U2.15 (VOA)
/Power stage (2 phases)/Phase 2/IMON: TP10.1, U10.2 (OUT)
/Power stage (2 phases)/Phase 2/ISP: R33.1, RS3.2, U10.8 (IN+)
/Power stage (2 phases)/Phase 2/LDCDC: C57.1, C58.1, U7.13 (LDO_OUT), U7.16 (DCDC_IN)
/Power stage (2 phases)/Phase 2/LS_DRV: R14.1, U2.10 (VOB)
/Power stage (2 phases)/Phase 2/OCP_LIM: R28.1, U10.3 (LIMIT)
/Power stage (2 phases)/Phase 2/PGND_K: C10.2, C14.2, NT4.1, Q6.2 (SK), R4.2, U2.9 (GNDB)
/Power stage (2 phases)/Phase 2/SW_K: C9.2, D4.2 (A), NT3.1, Q5.2 (SK), R3.2, U2.14 (GNDA)
/Power stage (2 phases)/SW2: C38.2, D12.2 (A2), D13.1 (A1), NT3.2, Q5.4 (S), Q5.6 (S), Q6.3 (D), Q6.5 (D), Q6.7 (D), R26.1, TP4.1; also elsewhere on the board
GND_ISO: C13.2, C31.2, C55.2, C56.2, C57.2, C58.2, R22.2, U2.4 (GNDI), U7.9 (GND), U7.15 (DCDC_GND); also elsewhere on the board
unnamed: C38.1, R25.2
unnamed: C39.1, R26.2
unnamed: D2.2 (A), R10.2
unnamed: Q5.1 (G), R3.1, R16.2, TP7.1
unnamed: Q6.1 (G), R4.1, R14.2, TP8.1
PGND: C3.2, C4.2, C17.2, C18.2, C35.2, C39.2, C41.2, D13.2 (A2), NT4.2, Q6.4 (S), Q6.6 (S), R28.2, U10.4 (GND), U10.5 (RESET); also elsewhere on the board
VBUS: C3.1, C4.1, C17.1, C18.1, C34.1, D12.1 (A1), Q5.3 (D), Q5.5 (D), Q5.7 (D), R25.1; also elsewhere on the board

Notes on the sheet:
LV CONTROL DOMAIN (GND_ISO)
HV POWER DOMAIN (PGND)
Isolation barrier: 2.5 mm keep-out on all layers. Only U_DRV (Si8274) and U_AMC (AMC3301) cross it.
Dead time ~20 ns: DT = 2.02 x R_DT[k] + 7.77 ns
Isolated half-bridge driver
Zener keeps HS VGS <= 6 V when SW rings below PGND during dead time
Bootstrap (high side)
VDDB decoupling at U_DRV pins 11/9
Gate loops: route each gate trace over its Kelvin return (SK = EPC2304 pad 2)
Kelvin net-ties: place at Q pad 2
Half-bridge (bottom side)
DNP: fit only if measured V_DS overshoot needs it
D-S snubber / clamp (DNP)
Commutation loop: caps tight against the half-bridge, return on L3 directly above (target 1.3-1.8 nH)
Center-tap (EMI): shield / heatsink return via FB1
HF input decoupling
Kelvin sense pads (pins 2/3) to U_OCP and U_AMC
Cycle-by-cycle limit 36 A peak: V_LIMIT = 80 uA x 22.6k = 1.81 V = 100 V/V x 0.5 mOhm x 36 A. RESET low = transparent mode.
Phase current sense / fast OCP (HV)
High side floats at VOUT (HGND_ISN = shunt VOUT side), supplied by the AMC3301 internal isolated DC/DC.
I_P - I_N = 8.2 x V_shunt = 4.1 mV/A to LTC3861 ISNS (attenuated on the controller sheet)
Isolated phase-current amplifier (AMC3301)

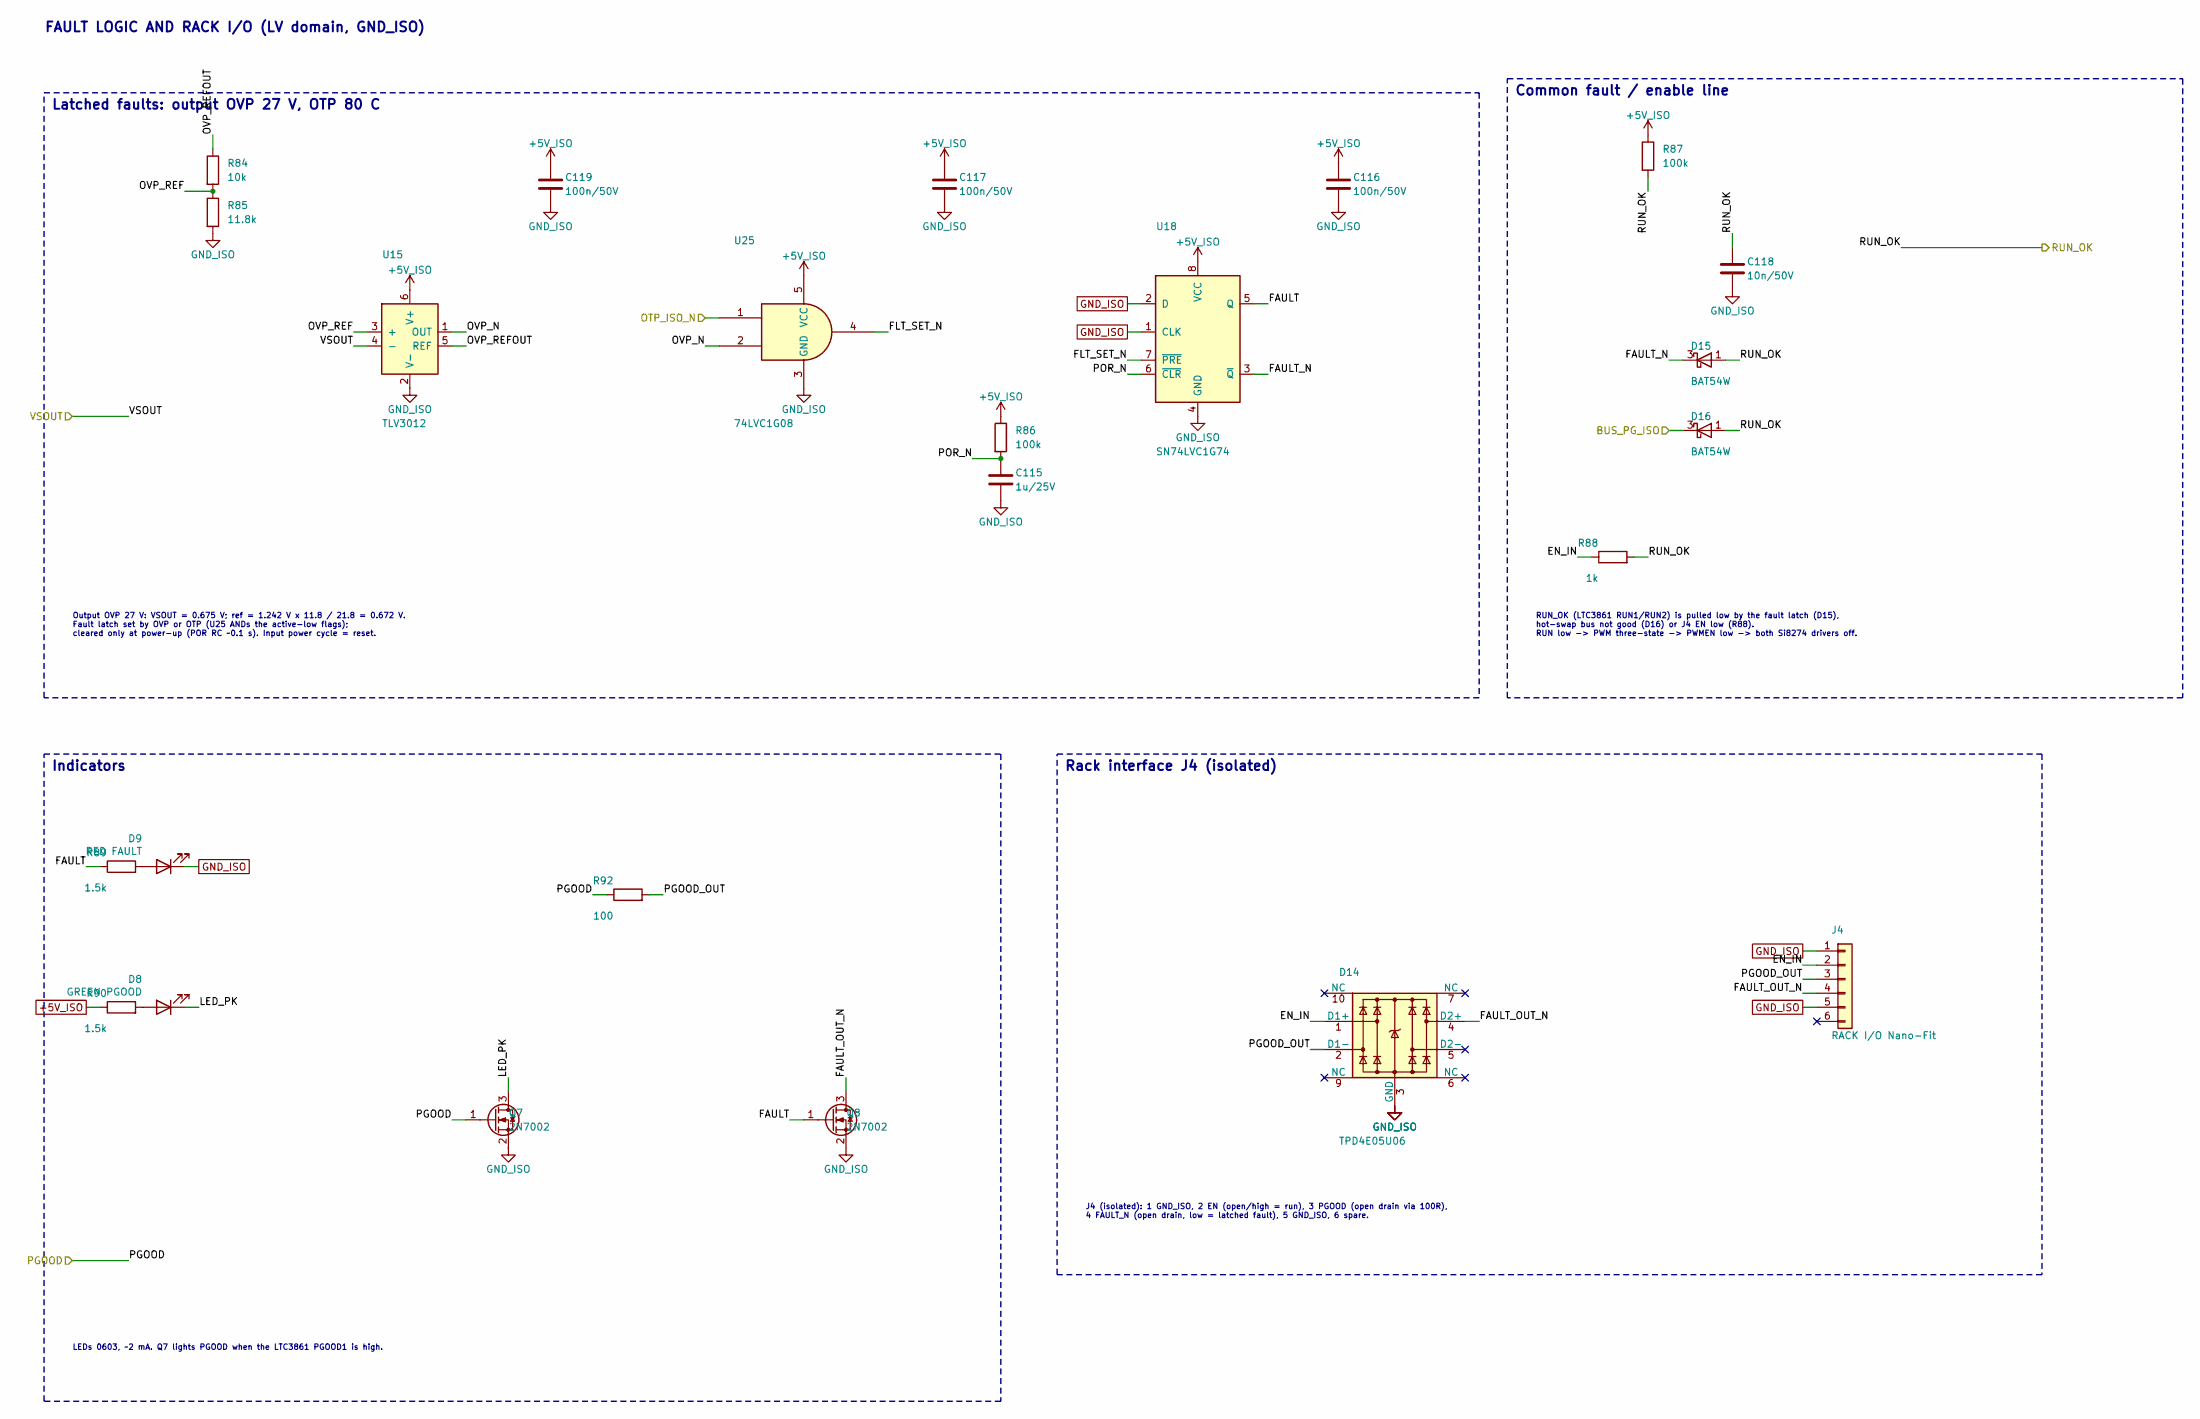
[picture p132: schematic fault_io.kicad_sch, Fault logic and rack I/O (LV)]

Parts:
C115: 1u/25V; C_0603_1608Metric; MPN GRM188R71E105KA12D; LCSC C86020
C116, C117, C119: 100n/50V; C_0603_1608Metric; MPN GRM188R71H104KA93D; LCSC C77055
C118: 10n/50V; C_0603_1608Metric; MPN GRM188R71H103KA01D; LCSC C77053
D8: GREEN PGOOD; LED_0603_1608Metric; MPN LTST-C191KGKT; LCSC C125098
D9: RED FAULT; LED_0603_1608Metric; MPN LTST-C191KRKT; LCSC C125099
D14: TPD4E05U06; USON-10_2.5x1.0mm_P0.5mm; MPN TPD4E05U06DQAR; LCSC C138714
D15, D16: BAT54W; SOT-323_SC-70; MPN BAT54W-7-F; LCSC C134417
J4: RACK I/O Nano-Fit; Molex_Nano-Fit_105313-xx06_1x06_P2.50mm_Horizontal; MPN 105313-1206; LCSC C17656275
Q7, Q8: 2N7002; SOT-23; MPN 2N7002LT1G; LCSC C16338
R84: 10k; R_0603_1608Metric; MPN RC0603FR-0710KL
R85: 11.8k; R_0603_1608Metric; MPN RC0603FR-0711K8L
R86, R87: 100k; R_0603_1608Metric; MPN RC0603FR-07100KL
R88: 1k; R_0603_1608Metric; MPN RC0603FR-071KL
R89, R90: 1.5k; R_0603_1608Metric; MPN RC0603FR-071K5L
R92: 100; R_0603_1608Metric; MPN RC0603FR-07100RL
U15: TLV3012; SOT-23-6; MPN TLV3012AIDBVR; LCSC C62505
U18: SN74LVC1G74; SSOP-8_2.95x2.8mm_P0.65mm; MPN SN74LVC1G74DCTR; LCSC C840104
U25: 74LVC1G08; SOT-23-5; MPN SN74LVC1G08DBVR; LCSC C7666

Connections:
+5V_ISO: C116.1, C117.1, C119.1, R86.1, R87.1, R90.1, U15.6 (V+), U18.8 (VCC), U25.5 (VCC); also elsewhere on the board
/BUS_PG_ISO: D16.3 (K); also elsewhere on the board
/Controller (LV)/Fault logic and rack I/O/EN_IN: D14.1 (D1+), J4.2, R88.1
/Controller (LV)/Fault logic and rack I/O/FAULT: Q8.1 (G), R89.1, U18.5 (Q)
/Controller (LV)/Fault logic and rack I/O/FAULT_N: D15.3 (K), U18.3 (~Q)
/Controller (LV)/Fault logic and rack I/O/FAULT_OUT_N: D14.4 (D2+), J4.4, Q8.3 (D)
/Controller (LV)/Fault logic and rack I/O/FLT_SET_N: U18.7 (~PRE), U25.4
/Controller (LV)/Fault logic and rack I/O/LED_PK: D8.1 (K), Q7.3 (D)
/Controller (LV)/Fault logic and rack I/O/OVP_N: U15.1 (OUT), U25.2
/Controller (LV)/Fault logic and rack I/O/OVP_REF: R84.2, R85.1, U15.3 (+)
/Controller (LV)/Fault logic and rack I/O/OVP_REFOUT: R84.1, U15.5 (REF)
/Controller (LV)/Fault logic and rack I/O/PGOOD_OUT: D14.2 (D1-), J4.3, R92.2
/Controller (LV)/Fault logic and rack I/O/POR_N: C115.1, R86.2, U18.6 (~CLR)
/Controller (LV)/PGOOD: Q7.1 (G), R92.1; also elsewhere on the board
/Controller (LV)/RUN_OK: C118.1, D15.1 (A), D16.1 (A), R87.2, R88.2; also elsewhere on the board
/Controller (LV)/VSOUT: U15.4 (-); also elsewhere on the board
/OTP_ISO_N: U25.1; also elsewhere on the board
GND_ISO: C115.2, C116.2, C117.2, C118.2, C119.2, D9.1 (K), D14.3 (GND), D14.8 (GND), J4.1, J4.5, Q7.2 (S), Q8.2 (S), R85.2, U15.2 (V-), U18.1 (CLK), U18.2 (D), U18.4 (GND), U25.3 (GND); also elsewhere on the board
unnamed: D8.2 (A), R90.2
unnamed: D9.2 (A), R89.2

Notes on the sheet:
FAULT LOGIC AND RACK I/O (LV domain, GND_ISO)
Output OVP 27 V: VSOUT = 0.675 V; ref = 1.242 V x 11.8 / 21.8 = 0.672 V. Fault latch set by OVP or OTP (U25 ANDs the active-low flags); cleared only at power-up (POR RC ~0.1 s). Input power cycle = reset.
Latched faults: output OVP 27 V, OTP 80 C
RUN_OK (LTC3861 RUN1/RUN2) is pulled low by the fault latch (D15), hot-swap bus not good (D16) or J4 EN low (R88). RUN low -> PWM three-state -> PWMEN low -> both Si8274 drivers off.
Common fault / enable line
LEDs 0603, ~2 mA. Q7 lights PGOOD when the LTC3861 PGOOD1 is high.
Indicators
J4 (isolated): 1 GND_ISO, 2 EN (open/high = run), 3 PGOOD (open drain via 100R), 4 FAULT_N (open drain, low = latched fault), 5 GND_ISO, 6 spare.
Rack interface J4 (isolated)

Board: 4 copper layers, 273 parts (134 on the bottom side), 140 nets, no tracks yet.
