tsshendo/2-Phase-interleaved-buck-converter/(commit log)

2026-10-15 Set up repo for credit-card PCB design
    - Restructure: kicad/, bom/, docs/, sim/ltspice/, fab/
    - Import KiCad 10 project (ECE533_Guide), BOM, reports, LTspice files
    - Add CLAUDE.md (design requirements + workflow) and PROGRESS.md
    - Add KiCad/LTspice .gitignore and .gitattributes
    - Vendor libraries, datasheets and SPICE models kept local (licenses); READMEs explain setup
    - Add CI: KiCad 10 ERC/DRC + schematic PDF export
    Claude-Session: https://claude.ai/code/session_012eMivaqkd1dyxnrq7oV5Sv
    [ECE533_Guide.csv, ECE533_Guide.kicad_pcb, ECE533_Guide.kicad_sch, PCB_BOM.xlsx, connectors.kicad_sch, gate_drive.kicad_sch]
2026-10-15 Stage 1: isolated control architecture and block diagram (refs #1)
    HV/LV domain split, barrier crossings, fault logic and power-up sequence.
    LTC3861 voltage-mode controller at 250 kHz with Si8274 isolated drivers.
2026-10-15 Stage 1: power-stage, stack-up/IPC-2152 and thermal calculations (refs #1)
2026-10-15 Stage 1: control supply, protection thresholds and proposed parts (refs #1)
2026-10-15 Update PROGRESS.md for Stage 1 (refs #1)
2026-10-15 Stage 1 review: keep inductor/FETs, precise 82 V input OVP, update spec (refs #1)
    - Keep ERUC23-3R2K and EPC2304; accept the resulting per-phase ripple
    - Input OVP via TLV3012 (U22) driving LM5069 OVLO at 81.9 V
    - 100 V pass FET; stack-up accepted; Digi-Key handled by the user
    - CLAUDE.md: 250 kHz, ripple target, Si8274 drivers, isolators/PS1 kept
2026-10-15 Stage 1 review: keep NME1S0505SC as PS1 (refs #1)
2026-10-17 Stage 2: hierarchical schematic with isolated control domain (refs #2)
    Nine sheets: overview/block diagram, input protection + hot-swap, power
    stage with two instances of the phase sheet, aux supply + fan, isolation
    barrier crossings, controller and nested fault logic / rack I/O.
    Project symbol library ECE533.kicad_sym drawn from manufacturer datasheets.
    Replaces the old gate_drive/connectors sheets.
    ERC: 0 errors; 11 warnings for custom footprints drawn in Stage 3.
    kicad/tools/check_netlist.py: 74/74 connectivity checks pass.
    [ECE533_Guide.kicad_sch, aux_supply_fan.kicad_sch, connectors.kicad_sch, controller.kicad_sch, fault_io.kicad_sch, gate_drive.kicad_sch, input_protection.kicad_sch, isolation.kicad_sch]
2026-10-17 Stage 2: BOM from schematic, LCSC numbers, fix duplicate C114 (refs #2)
    - kicad/tools/make_bom.py builds bom/PCB_BOM.xlsx (+ CSV) from the netlist;
    previous report BOM kept as a sheet, Digi-Key PNs carried over
    - 47 LCSC numbers verified on lcsc.com; two unconfirmed Murata MPNs replaced
    - check_netlist.py now also checks for duplicate reference designators
    - Yageo part-number codes fixed (13K, 0R jumper)
    [PCB_BOM.csv, PCB_BOM.xlsx, aux_supply_fan.kicad_sch, controller.kicad_sch, fault_io.kicad_sch, input_protection.kicad_sch, isolation.kicad_sch, power_phase.kicad_sch]
2026-10-17 Stage 2: design notes, PROGRESS and CI library tables (refs #2)
    - docs/design/schematic_stage2.md: sheets, conventions, refdes, changes,
    verification, BOM notes, open items for Stage 3
    - Stage 1 notes updated where the schematic changed details
    - CI installs default KiCad library tables and blocks on ERC errors
2026-10-17 Stage 3: footprints from datasheets and vendor libraries, 3D-checked (refs #3)
    - ECE533_Mods.pretty (drawn from manufacturer datasheets):
    EPC2304 (EPC copper, solder-mask-defined land pattern and stencil),
    TDK ERUC23 (TDK recommended layout), R_2512_Kelvin (Bourns CSS2H-2512
    pads with net-tie sense strips), Littelfuse 456 fuse (+ placeholder STEP)
    - ECE533_Vendor library (git-ignored): Wurth REDCUBE 74650194R and the
    SamacSys NME1S0505SC footprint; vendor STEP models referenced from
    kicad/lib/vendor, alignment verified by rendering
    - gen_footprints.py regenerates both libraries; check_footprints.py checks
    symbol pins against footprint pads
    - Fix D15/D16 BAT54W footprint: SOT-323,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
    [fault_io.kicad_sch, input_protection.kicad_sch, isolation.kicad_sch, power_stage.kicad_sch]
2026-10-17 Stage 3: input fuse F1 becomes a not-fitted option, R96 link (refs #3)
    0456025.ER is rated 72 VDC, below the 79.2 V maximum input, and no
    >=25 A SMD fuse rated >=100 VDC was found. Per review decision the
    LM5069 circuit breaker is the eFuse; F1 keeps its NANO2 456 footprint
    (DNP) and R96 (Bourns CSS2H-2512C-000, <0.1 mOhm, 100 A) links it.
    Adds the R_2512_CSS2H footprint; BOM regenerated.
    [PCB_BOM.csv, PCB_BOM.xlsx, input_protection.kicad_sch]
2026-10-17 Stage 3: board set-up, JLCPCB rules and first-pass placement (refs #3)
    - build_pcb.py builds the PCB from the netlist: ID-1 outline, 4 x 2 oz
    stack-up (3313, ENIG), layer names, LV_ISO/HV_SW net classes, heatsink,
    pedestal and fan-duct outlines, isolation-barrier rule area, and places
    all 273 footprints (power stage on the bottom under L1, isolators on the
    barrier column, terminals on the right edge)
    - ECE533_Guide.kicad_dru: JLC 2 oz limits, HV margin, 2.5 mm barrier rule
    - Test points 1.0 mm (all on top); L1 pin-1 mark moved off RS2
    - DRC with parity: 0 errors; only unrouted nets and 1 silk warning remain
    - docs/design/placement_stage3.md with renders, PROGRESS updated
    Co-Authored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
    [ECE533_Guide.kicad_pcb, PCB_BOM.xlsx, aux_supply_fan.kicad_sch, input_protection.kicad_sch, isolation.kicad_sch, power_phase.kicad_sch, power_stage.kicad_sch]
2026-10-17 Power module: new KiCad project from the base schematic, footprints and BOM fields, ERC clean
    - kicad/PowerModule: base power-stage + gate-drive sheets (commit 57d8ca5), unchanged circuit
    - footprints/values/MPN/LCSC assigned (0603 minimum, catalog values: C1-C4 2.2u, C5/C6 EGXF 110u)
    - EPC2304_QFN-7_3x5mm_15pin footprint for the SamacSys 15-pin symbol (stacked pads)
    - SHIELD label joins both input-cap centre taps (interstitial shield return, report p.18)
    - PWR_FLAGs on driver supply nets; ERC 0 errors, 6 off-grid warnings from the base drawing
    [PowerModule.kicad_sch, gate_drive.kicad_sch]
2026-10-17 Power module: board in the report layout, report polygon pours, routed, DRC clean
    - PowerModule.kicad_pcb: ID-1 outline, 4 x 2 oz stack-up; L1 = 1st Cu plane, L4 = 2nd Cu plane
    (FETs), L2/L3 = interstitial SHIELD; J4 | isolators + PS1 | driver column | 2x2 EPC2304 | ERUC23 |
    bulk caps | REDCUBE terminals, as in the SolidWorks model
    - per-phase VBUS / SW / PGND combs at the EPC2304 strips, centre-tap SHIELD island, Kelvin islands
    under the HS drivers, via-in-pad SW fields (33 vias per phase), M3 heatsink holes
    - PowerModule.kicad_dru: JLC 2 oz rules, HV 0.25 mm, 2.5 mm barrier with the PS1 exception
    - tools: pm_build.py, pm_route.py (power / signals / finish), pm_bom.py; route_power.py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
    [PowerModule.kicad_pcb]
2026-10-17 Power module: design note, renders, BOM, progress log
    [PowerModule_BOM.csv]
2026-10-17 Power module: LS drivers next to the LS FETs, reference labels and owner block on silkscreen
    - U2/U4 moved from the driver column to the top side between the phases, outputs facing the LS
    gate vias: driver -> gate path 4.8 mm (was 11-14 mm); HS 5.9-6.8 mm
    - every reference designator on the silkscreen (0.8 mm, collision-checked placement)
    - bottom silkscreen: owner name block, 2.3 mm text
    - shield planes: 0.25 mm antipads and L2-L3 ties; centre-tap vias placed clear of the driver cells
    - DRC with schematic parity: 0 violations, 0 unconnected, 0 parity issues
    [PowerModule.kicad_pcb]
2026-10-17 Power module: bulk caps split into 4 x 62 uF, J4 centred with fixed control lanes
    - C5/C6 -> C5+C15 (output), C6+C16 (input): 2 x EGXF161ELL620MJ25S per position (user: half
    values for lower ESR); VIN/VOUT labels added (pm_split_bulk.py), ERC 0 errors
    - J4 centred on the left edge; AT1 pair on L4, AT2 pair on L1, +5V lane on L4: 15-19 mm per
    command line, no meanders; PS1 to the bottom left, H2 screw to (28.4, 50.6)
    - PS1 barrier keep-out from pin-2 to pin-3 centre (1.5 mm per side)
    - name block on the bottom silkscreen auto-sized into the clear strip (2.0 mm)
    - DRC with schematic parity: 0 violations, 0 unconnected, 0 parity issues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
    [PowerModule.kicad_pcb, PowerModule.kicad_sch, PowerModule_BOM.csv]
2026-10-18 Power module: symmetric bulk caps, PS1 centred on J4, right-angle J4 with model
    - bulk caps mirror-symmetric: C6/C16 on the top edge (VBUS), C5/C15 on the bottom edge (VOUT
    strip added), x 37.5 / 64.6; PGND tongues for C6 (L1 + vias) and C16
    - PS1 on J4's centreline; J4 right angle, mating face 2.2 mm off the edge; H2 back to (21.5, 50)
    - J4 project footprint Molex_Nano-Fit_105313-1206_RA (off-board silk dropped) + generated
    right-angle STEP (gen_footprints.py, nanofit_fp.py)
    - name block 2.35 mm in the widened clear strip
    - ERC 0 errors; DRC with schematic parity: 0 violations, 0 unconnected, 0 parity issues
    [PowerModule.kicad_pcb, gate_drive.kicad_sch]
2026-10-18 Power module: parasitics vs the report (hand estimates)
2026-10-18 Power module: 1 kOhm gate pull-downs R21-R24 at the gate pads
    - schematic: R21 P1H-KS1, R22 P1L-GNDPWR, R23 P2H-KS2, R24 P2L-GNDPWR (pm_pulldowns.py), as in
    the report's LTspice model; ERC 0 errors
    - HS pull-downs on the bottom inside the Kelvin island next to the gate pads, LS on the top over
    the gate via next to the LS Kelvin via
    - DRC with schematic parity: 0 violations, 0 unconnected, 0 parity issues; BOM and docs updated
    [PowerModule.kicad_pcb, PowerModule_BOM.csv, gate_drive.kicad_sch]
2026-10-18 Power module: centred inductor, symmetric control side, bulk caps grouped by role
    - inductor body centred on the board; L4/L1 switch-node copper extended under its SW pads
    - gate-drive cells as identical per-phase copies (15.8 mm pitch): both phases HS 8.3 / LS 5.9 mm;
    Kelvin islands copied; isolators, PS1, J4, C11/C12 mirrored about the centreline
    - input bulk C6 + C16 on the top edge (input side, L1 PGND tongue to the LS1 comb), output bulk
    C5 + C15 on the bottom edge under the VOUT pads
    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
    [PowerModule.kicad_pcb]
